Workshop88/thotcon0x4/DesignNotes.html

<h3>Links for Thotcon badges</h3>

<h4>Protocols</h4>

<ul>

<li>802.15.4 - MAC (Media Access Layer) and PHY (Physical layer) used by all RF devices (may be some others)</li>

<li>ZigBee - proprietary (consortium owned) protocol set over 802.15.4 RF. Requires ~128k memory for protocol stack. </li>

<li>6LowPan - <a href="http://www.ecnmag.com/articles/2009/02/6lowpan-goes-where-zigbee-cant">IPv6 over Low Power access network</a> - Routing, Addressing, IP protocols over 802.15.4 RF. Applications similar to Zigbee, multiple implementations. Each node gets an IP address. Less memory usage compared to Zigbee?</li>

<li><a href="http://www.contiki-os.org/">Contiki</a> - network OS built atop 6LowPan, open source. Runs on current generation chipsets. Full IDE, Cooja network simulator free. </li>

<li><a href="http://www.ti.com/tool/simpliciti">SimpliciTI</a> - simple protocol for small star networks, uses hubs for store and forward, minimal memory footprint, software available for Texas Instruments chipsets, price? <a href="http://www.ti.com/lit/ml/swru130b/swru130b.pdf">Overview</a></li>

<li>SNAP - network operating system over 802.15.4. Proprietary to <a href="http://www.synapse-wireless.com/snap-components/rf-engine">Synapse Networks</a>, programmed by Python over the air. Modules $40 each.</li>

<li><a href="http://en.m.wikipedia.org/wiki/MiWi">MiWi</a> Proprietary MicroChip protocol for PIC controllers over 802.15.4.</li>

</ul>

<h4>Chipsets</h4>

<p>TI has a variety of <a href="http://focus.ti.com/wireless/docs/wirelessproduct.tsp?familyId=2003&amp;sectionId=646&amp;tabId=2736">chipsets</a> with integrated radios that could fit the budget:</p>

<ul>

<li> <a href="http://www.ti.com/product/cc1110f32">CC1110F32</a> 8 bit processor (antique 8051 instruction set) + CC1101 900MHz RF. $2.75 1K quantity. This probably needs an additional host processor to do much. There’s a version with 6LowPan protocol preloaded <a href="http://www.ti.com/product/cc1180">CC1180</a> $3.85@1K.</li>

<li> <a href="http://www.ti.com/docs/prod/folders/print/cc430f6137.html">CC430F6137</a> - TI CC430 processor + CC1101 900MHz RF. $3 in 1K quantity. Used for variety of radio protocols. The processor is TI&#39;s 16 bit ultra low power series. &lt;1Ghz radio, use same band as wireless phone handset (900 mhz)</li>

<li><a href="http://www.ti.com/product/cc2530">CC2530</a> 8-bit 8051 + 2.4 GHz radio $3.65@1K. ZigBee stack available on 256K flash memory version</li>

<li><a href="http://www.ti.com/product/cc2544">CC2544</a> - 8-bit + 2.4GHz radio. “Value line” $1.80@1k. 32K flash memory, targeted to proprietary 2.4 GHz systems, USB dongles</li>

</ul>

<p>Freescale</p>

<ul>

<li>MC13211:2.4 GHz 802.15.4 RF and 8-bit HCS08 MCU with 16KB Flash, 1KB RAM</li>

<li> MC13224V: 2.4 GHz 802.15.4 RF and 32-bit ARM7™ MCU with 128KB Flash, 96K ram &lt;$5.</li>

<li>MPXY8300: Microcontroller, Pressure Sensor, X-Z Accelerometer and RF Transmitter- 900 MHz intended for tire pressure monitoring</li>

<li>MC12311: Sub-1 GHz RF and 8-bit HCS08 MCU with 32KB Flash, 2KB RAM</li>

<li>MC33696: PLL Tuned UHF Transceiver - 900Mhz, needs microprocessor to do anything</li>

</ul>

<p>Atmel</p>

<ul>

<li><a href="http://www.atmel.com/devices/ATMEGA256RFR2.aspx">ATMEGA256RFR2</a> brand new, AVR 8 bit processor + 2.4 GHz $6.20 DigiKey qty 1</li>

<li>AT86RF212 - 900 MHz transceiver chip, &lt; $3</li>

</ul>

<p>STMicroelectronics</p>

<ul>

<li><a href="http://www.st.com/internet/mcu/product/245381.jsp">STM32W108xx</a> ARM processor + 2.4 GHz radio, <a href="http://www.digikey.com/scripts/DkSearch/dksus.dll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">$2.75 @ 2.5K, $6.00 @ 1</a></li>

</ul>

<p>Silicon Labs</p>

<ul>

<li><a href="http://www.silabs.com/Support%20Documents/TechnicalDocs/Si1010.pdf">Si1012-A-GM</a> 8051 core + 915 MHz transceiver $5</li>

</ul>

<h4>RF modules</h4>

<p>Modules include radio chip, antenna, and support chips, sometimes with MCU. Price is the issue - first gen Zigbee seem to range from $20 to $75.</p>

<p><a href="http://www.anaren.com/air-wiki-zigbee/index.php/Main_Page">Anaren</a> - makes <a href="https://estore.ti.com/430BOOST-CC110L-CC110L-RF-Module-BoosterPack-P2734.aspx">RF Boosterpacks</a> for TI Launchpad dev units. $19 single unit</p>

<p><a href="http://www.anaren.com/sites/default/files/Part-Datasheets/A110LR09A.pdf">Anaren A110LR09A</a> - 900 MHz $15</p>

<p><a href="http://www.newark.com/microchip/mrf89xam9a-i-rm/915mhz-radio-transceiver-module/dp/76R6669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">MICROCHIP - MRF89XAM9A-I&#47;RM</a> - 915MHZ RADIO TRANSCEIVER MODULE W&#47; FCC CERTIFICATION, PCB ANTENNA AND MIWI SUPPORT $7+, SPI interface to host board, MiWi only if PIC processor used</p>

<p><a href="http://m.dhgate.com/product/FreeShipping-5pcs-lot-F20-Micro-NRF24L01+/112844608.html">No name Chinese 2.4 ghz xmit module</a> ~$6</p>

<h4>Dev kits</h4>

<p><a href="http://www.atmel.com/tools/ATMEGA256RFR2-EK.aspx">AT256RFR2-EK</a> Atmel kit includes two radios, processor, $349</p>

<p><a href="http://www.ti.com/tool/ez430-rf2500">EZ430-RF2500</a> kit from TI - two 2.4 GHz radio modules, MPS430 processor, USB board to attach radio to PC - $49</p>

<p><a href="http://www.freescale.com/webapp/sps/site/prod_summary.jsp?code=1320xRFC&amp;fpsp=1&amp;tab=desc">1320x-QE128-DSK</a> Freescale two radio kit $349</p>

<p><a href="http://www.newark.com/stmicroelectronics/stm32w-rfckit/eval-kit-stm32w-rf-control-kit/dp/39T7141">STM32W</a> two boards dev kit $38.75</p>

<h4>RF issues</h4>

<p>Design decision needed: what radio spectrum? Common choices for US are 900 MHz and 2.4 GHz. Radios available for each, most (all?) protocols work on both. Other things being equal, 915 MHz should have 2485&#47;915 ~= 2.5 times the range.</p>

<p>Noise floor - how many transmitters can we run simultaneously without blowing range, data rate?</p>

<p>How to test our implementation? Spectrum analyzer?</p>

<p>FCC certification for manufacture? We can <strong>operate</strong> in 2.4 Ghz, can we build 700 devices? We can get around any problems if we use an existing certified module.</p>

<p>Antenna detuning when used as badge - body within a centimeter would cause radio efficiency to get very poor if not tuned well. Even if tuned, radiation directional?</p>

<p><a href="http://www.ti.com/lit/an/swra169a/swra169a.pdf">Application note</a> describes range calculations and measurements for sensor radios.</p>

<p><a href="http://www.qsl.net/va3iul/Antenna/Printed_and_Microstrip_Antennas/Design_Ideas_for_Printed_and_Microstrip_Antennas.htm">Collection of real antenna designs</a></p>

<p><a href="http://www.newark.com/taiyo-yuden/ah212m245001-t/chip-antenna-2-45ghz/dp/46T5705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">Chip antenna</a> Taiyo Yuden 2.45GHz $0.73</p>

<p><a href="http://www.newark.com/abracon/abls2-13-000mhz-d4-t/crystal-13mhz-18pf-smd/dp/67P3787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">Abracon</a> 13 MHz SMD crystal $0.35
