Workshop88/thotcon0x4/tcb-prop.pdf

# THOTCON 0x4 Badge

## Design Proposal

Thursday, January 3, 2013

# Design Requirements

- Interactive element
- Battery powered
- RF transmitter / communications w/ Unique Identifiers
- Scoreboard / wall element
- Mixed color theme (Black,green,blue,red,gold)
- ~30k sq. ft. facility
- ~$12k budgeted, ~700 qty
- Early April Delivery

# Design Features

# - Multiple levels of hackability - hardware - firmware serial access - backend system - Useful after the con - Tool oriented - Explorative

# System Considerations

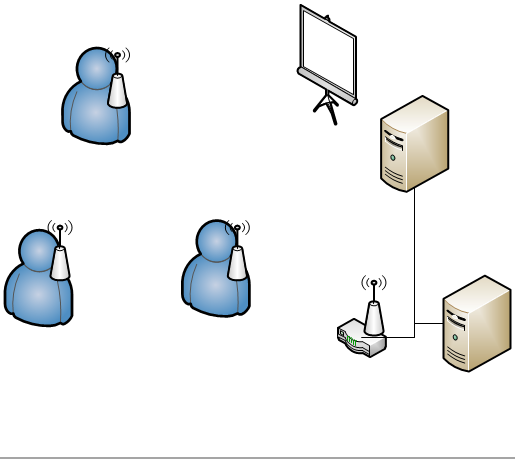
[picture p1: figure]

# Component Consideration

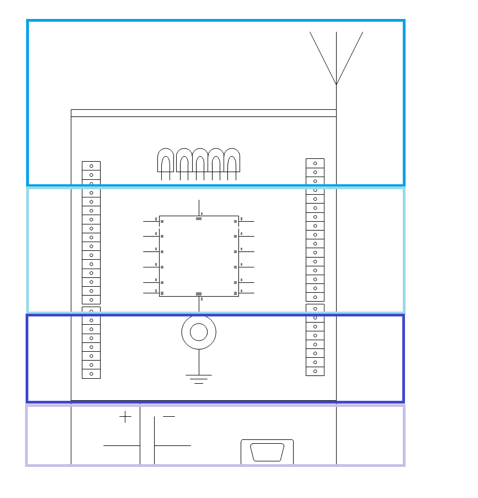
[picture p2: figure]

# - Out:RF / LED

- uC

# - In: Sensors - Power

# RF Technologies

# - High Band AM - Low Band FM

- IR

# - Proximity Radios - 802.11 - WiFi - 802.16 - WiMax - 802.15.4 - ZigBee

802.15.4

# - Cost effective Radio - Native protocols to manage base stations - CDMA , Error Control, Replay - Architecture to manage density

- Wide range of protocols (ZigBee,Xbee,

# 6LoWPAN, OpenBeacon, etc)

# Antenna Consideration

| Cost | Range | Durability | Size | Design
PCB | $10* | Variable | Highly Durable | PCB Based | Large PCB Aesthetics
Whip | $3 | Directional | Connectors Break | Obtrusive | Wireless Mystique
Chip | $0.50 | Moderate | Highly Durable | Component based

Contained
to PCB

# Network Topologies

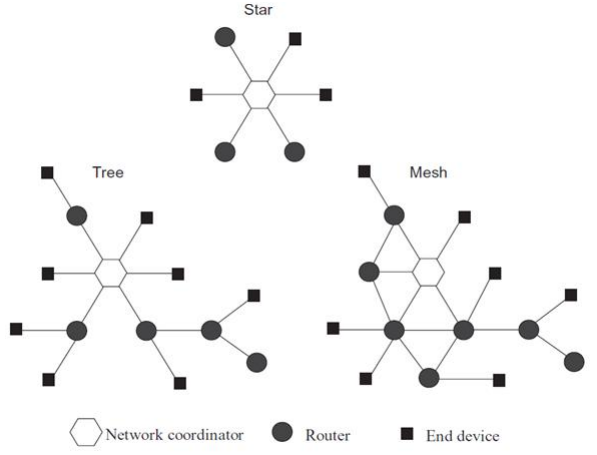
[picture p3: figure]

# Coverage Area

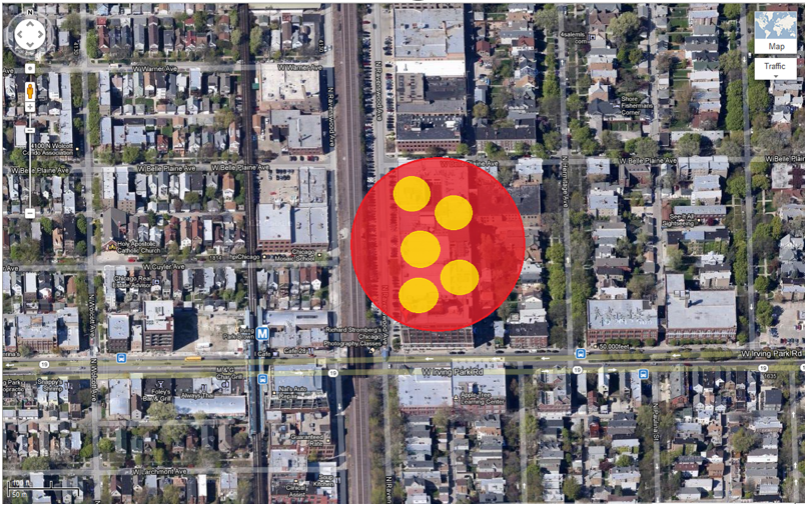
[picture p4: figure]

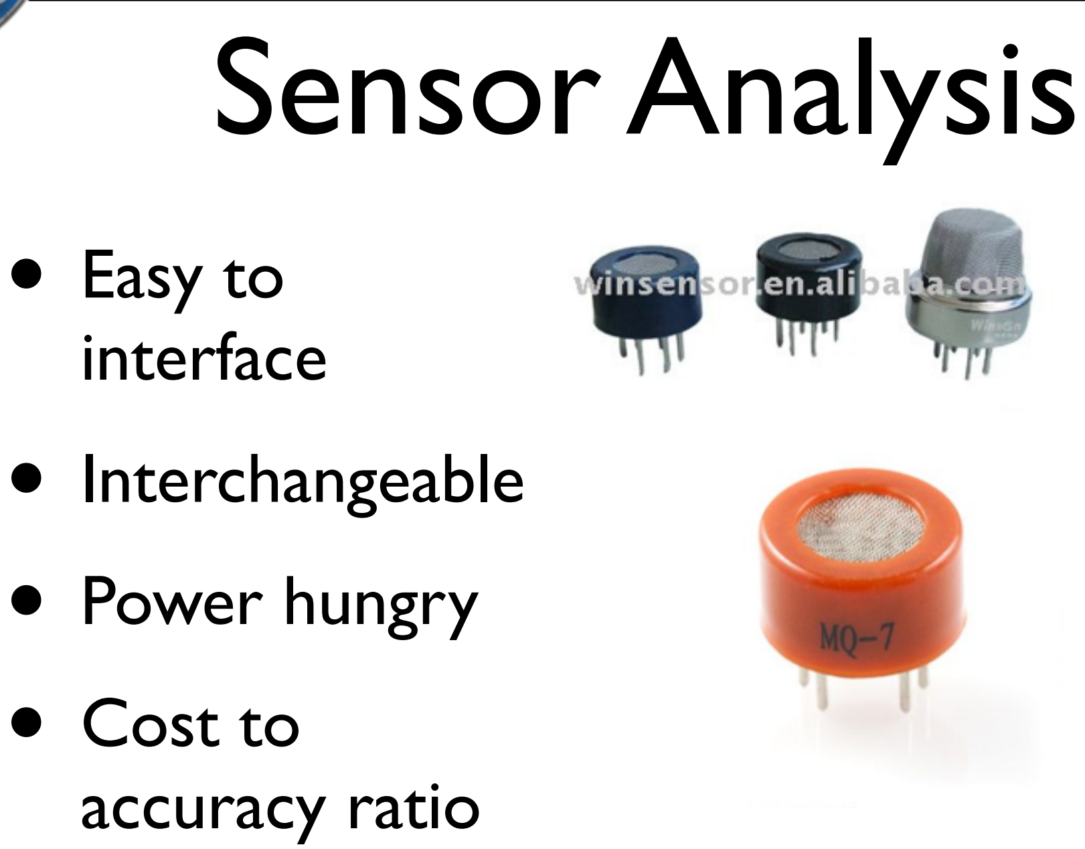
[picture p5: figure]
Sensor Analysis; • Interchangeable; • Power hungry; • Cost to accuracy ratio

# - Easy to interface

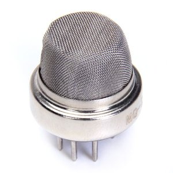
[picture p6: figure]

# Microcontroller Selection

# - Multiple A/D Inputs - Decent on chip Memory Footprint - Standard Bus Protocols

Atmel | Rabbit | TI | Freescale
Large community Several supported base languages ASM is most friendly Hobbiest Support Moderate Cost | Popular hobbyist community Difficult to program Free tools but not officially supported High Cost | Widely used commercially Not much public code base Closed Tools Low Cost | Widely used commercially Open tools, but small public code base Fewer community users Moderate Cost

# Scoreboard/Gameplay

# - QR Code Based Reg / Portal - Accessible from the THOTCON network - Top Scorerboard / Wall of Shame - Achievements

# Artistic Aspect / Theme

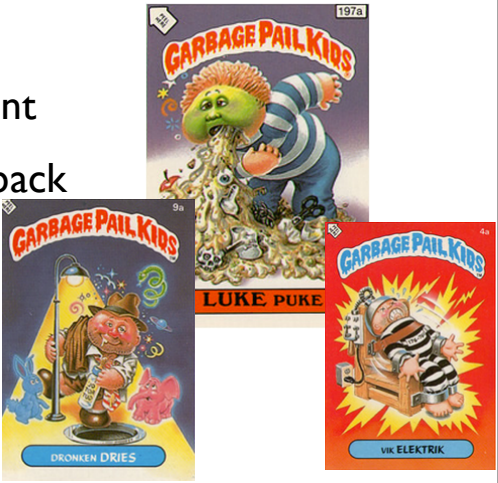
[picture p7: figure]

# - “Coaster” screen print - “Crime Dog” throwback - “Garbage Pail Kids”

# BoM Estimate

Component | Qty | Cost (@700 Units)
ATMEGA128RF | 1 | 5.28
MQ - 3 Sensor | 1 | 3.06
AT9520 Antenna | 1 | 0.56
32kHz Crystal | 1 | 0.18
16 mHz Crystal | 1 | 0.21
LED Array | 5 | 0.55
Battery | 2 | 0.25
Passive Components | 16 | 0.42
PCB Fab* | | $3 - $6
PCB Assembly* | | $6 - $10
Per Unit | -$18 - $26
Raw Cost | -$12,650 - $18,200

# Milestones

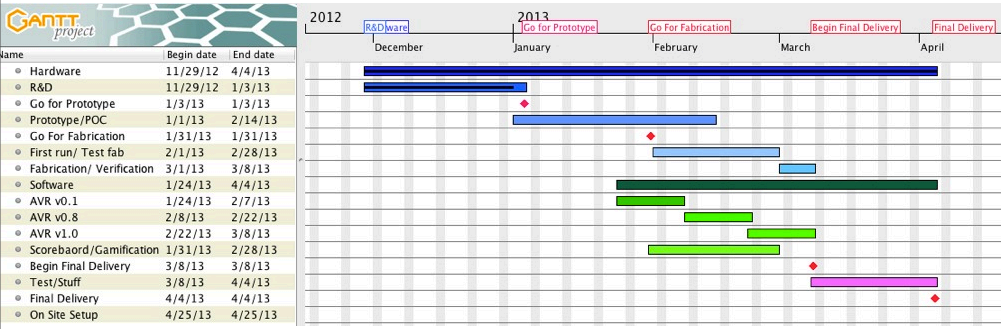
[picture p8: figure]

# - Design Review - Fab and assembly quote - Fab Verification

# Risks

# - Lot size - Lead times from Fab shops - Component availability - Budget skew

# Prior Art

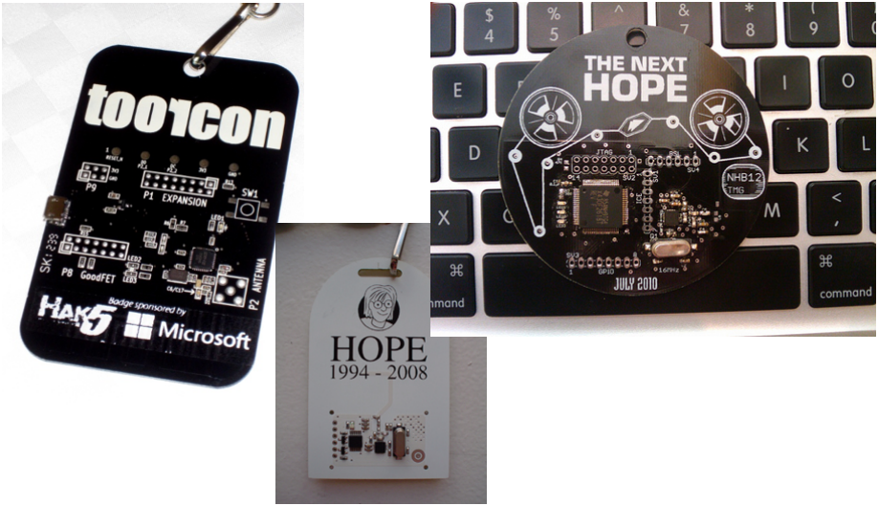
[picture p9: figure]

# Documentation / Publicity

# - “Making of the Badge” blog series - Open licensed schematics - Attribution on PCB and firmware - Github repo for documentations - All released post-con
