Workshop88/thotcon0x4/00PCB-layout/attic/01-15-13/ScreenCap-01-15-13.png

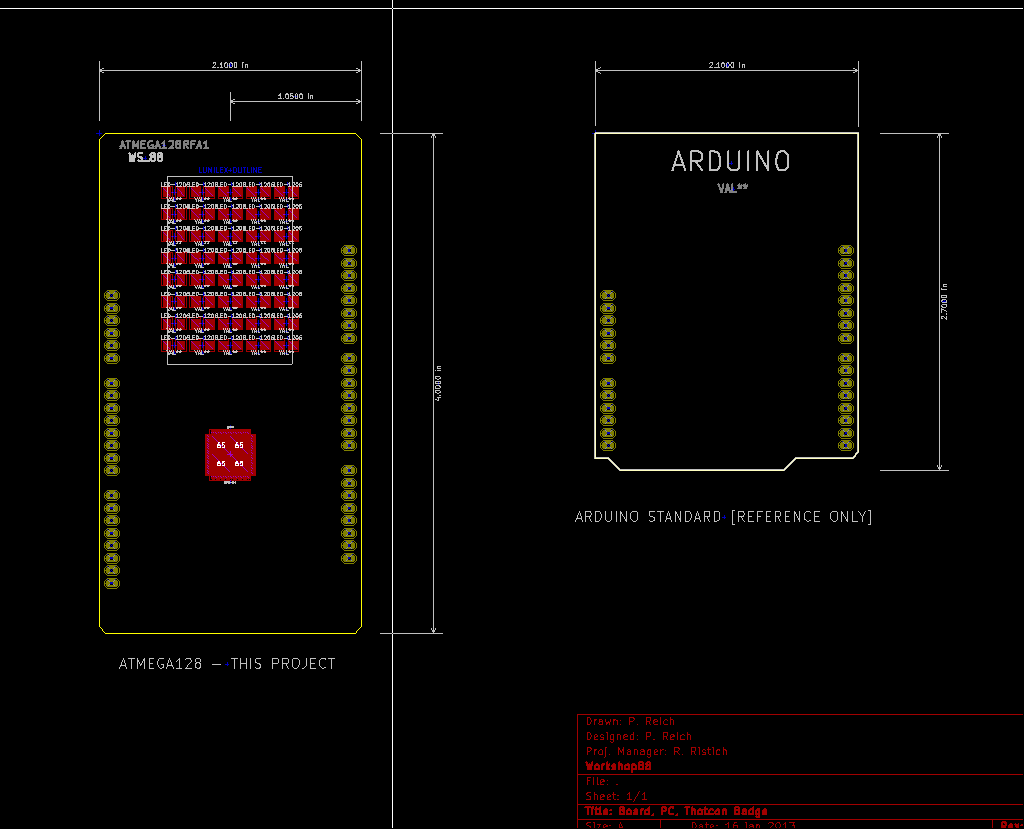
00PCB-layout/attic/01-15-13/ScreenCap-01-15-13.png
