Workshop88/thotcon0x4/00PCB-layout/attic/iss_P1/release/fab/THOTCON_0x4_oper.png

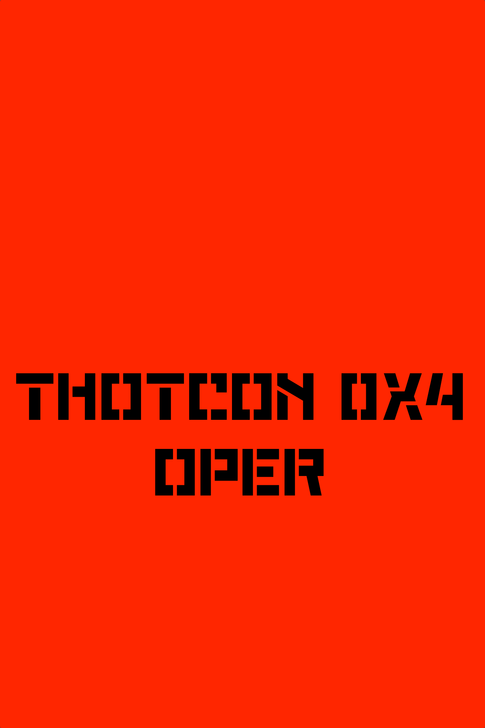
00PCB-layout/attic/iss_P1/release/fab/THOTCON_0x4_oper.png
