Workshop88/thotcon0x4/00PCB-layout/attic/iss_T2/cc_sa_3_notice.png

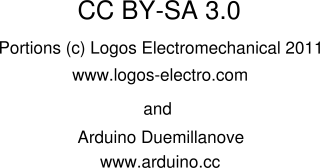
00PCB-layout/attic/iss_T2/cc_sa_3_notice.png
