Workshop88/thotcon0x4/00PCB-layout/development/iss_P3/release/thotcon_front.png

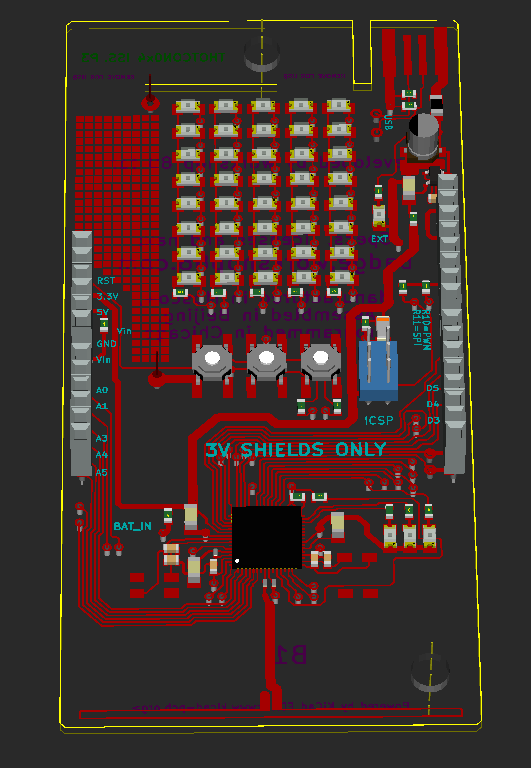
00PCB-layout/development/iss_P3/release/thotcon_front.png
