Workshop88/thotcon0x4/FUSE_TABLE/fuse-bits-2.png

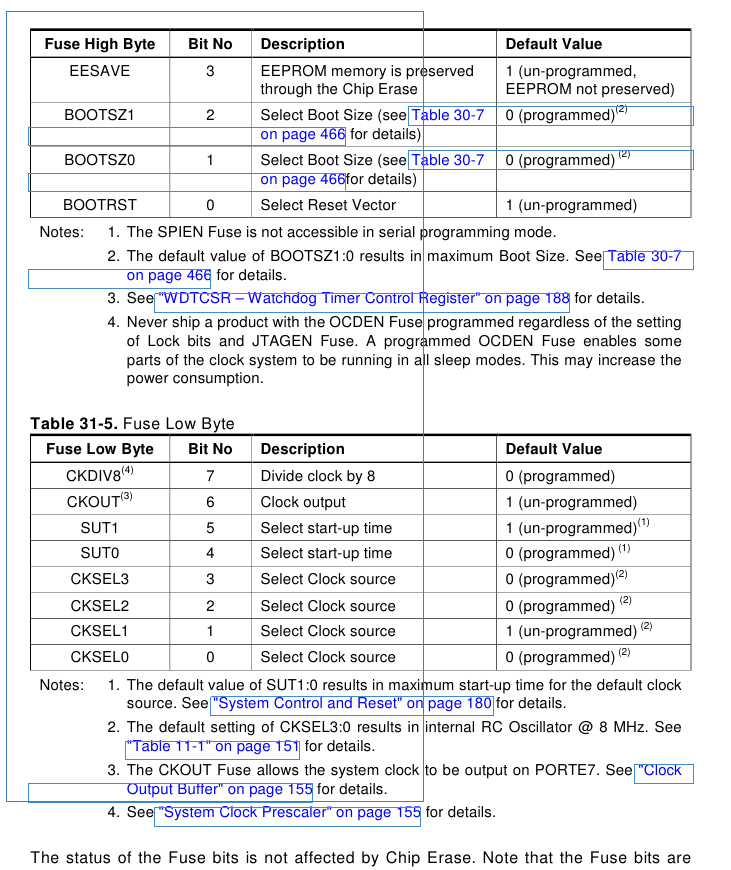
FUSE_TABLE/fuse-bits-2.png
