Workshop88/thotcon0x4/00PCB-layout/attic/iss_T2/release/thotcon_badge_zig_BOM_BY_PART.pdf

Sheet1

Page 1

REF | VALUE | DESC | PRICE/1000 | ASSY_STATUS | SUPLIER_1 | SUPPLIER_2
B1 | 3.3V | HOLDER BATT CR2032 | 0.230 | Y | Mouser 712-BAT-HLD-001
C1 | CAP CER SMD 0402 22 5 NPO | 0.040 | Y | Mouser 581-04023U220JAT2A
C2 | CAP CER SMD 0402 22 5 NPO | 0.040 | Y | Mouser 581-04023U220JAT2A
C3 | CAP CER SMD 0603 12 5 NPO | 0.010 | Y | Mouser 81-GRM39C120J50
C4 | CAP CER SMD 0603 12 5 NPO | 0.010 | Y | Mouser 81-GRM39C120J50
C5 | CAP CER SMD 0603 12 5 NPO | 0.010 | Y | Mouser 81-GRM39C120J50
C6 | CAP CER SMD 0603 12 5 NPO | 0.010 | Y | Mouser 81-GRM39C120J50
C8 | CAP CER SMD .01 10 X7R 16V | 0.015 | Y | Mouser 81-GRM18R71C103KA01D
C9 | CAP CER SMD 4.7uF 10% X7R 25V | 0.110 | Y | Mouser 81-GRM31CR71E475KA88
C10 | | CAP CER SMD 4.7uF 10% X7R 25V | 0.110 | Y | Mouser 81-GRM31CR71E475KA88
C11 | | CAR CER SMD 0402 22 5 NPO | 0.040 | Y | Mouser 581-04023U220JAT2A
C12 | | CAP LYTIC 100u 20% 6.3V | 0.210 | Y | Mouser 647-UWX0J101MCL1
D1 | RED | DIODE LED RED 1206 | 0.050 | Y | Mouser 604-APTL3216SURCK
D2 | RED | DIODE LED RED 1206 | 0.050 | Y | Mouser 604-APTL3216SURCK
D3 | RED | DIODE LED RED 1206 | 0.050 | Y | Mouser 604-APTL3216SURCK
D4 | RED | DIODE LED RED 1206 | 0.050 | Y | Mouser 604-APTL3216SURCK
D5 | RED | DIODE LED RED 1206 | 0.050 | Y | Mouser 604-APTL3216SURCK
D6 | RED | DIODE LED RED 1206 | 0.050 | Y | Mouser 604-APTL3216SURCK
D7 | RED | DIODE LED RED 1206 | 0.050 | Y | Mouser 604-APTL3216SURCK
D8 | RED | DIODE LED RED 1206 | 0.050 | Y | Mouser 604-APTL3216SURCK
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
| Digi 754-1165-1-ND
| Digi 754-1165-1-ND
| Digi CD1206-S01575CT-ND
| DigiKey P120GCT-ND
| DigiKey P120GCT-ND
| DigiKey P120GCT-ND
| DigiKey P120GCT-ND
| DigiKey P120GCT-ND
| Digikey P10KGCT-ND
| DigiKey P120GCT-ND
| Digikey P0.0GCT-ND
| Digikey P10KGCT-ND
| Digikey P0.0GCT-ND

Sheet1

Page 2

S1 | RESET | SW PB SMD N.O. | 0.250 | Y | Mouser 667-EVQQ2P02W
U1 | ATMEGA128RFA1 | IC MICROCONT RF 2450 | 5.280 | Y | Mouser 556-ATMEGA128RFA1-ZU
Y1 | 16.000 MHz | XTAL 16 MHZ | 0.500 | Y | Mouser 815-ABMM-16-B2-T
Y2 | | XTAL RTC 32768 | 0.800 | Y | Mouser 520-ECS327-12.5-17X-TR
| | TOTAL ACTIVE PART COST | 9.7322

NON-ITEMIZED PARTS
| BATTERY, CR-2032 | BATTERY, CR-2032 | 0.280 | Y
BAOARD, PC, THOTCON 0x04 | 3.000 | Y
| | TOTAL NON-ITEMIZED COST | 3.280
C13 | | CAP CER SMD 4.7u 10% X7R 25V | 0.110 | DO NOT PLACE | Mouser 81-GRM31CR71E475KA88
C14 | | CAP CER SMD .01 10 X7R 16V | 0.015 | DO NOT PLACE | Mouser 81-GRM18R71C103KA01D
C15 | | CAP LYTIC SMD 10uF 20% 16V | 0.100 | DO NOT PLACE | Mouser 647-UWF1C100MCL1GB
D41 | RED | DIODE LED RED 1206 | 0.050 | DO NOT PLACE | Mouser 604-APTL3216SURCK
D42 | RED | DIODE LED RED 1206 | 0.050 | DO NOT PLACE | Mouser 604-APTL3216SURCK
D43 | RED | DIODE LED RED 1206 | 0.050 | DO NOT PLACE | Mouser 604-APTL3216SURCK
D44 | RED | DIODE LED RED 1206 | 0.050 | DO NOT PLACE | Mouser 604-APTL3216SURCK
F1 | .5 A | FUSE POLY .5A 15V | 0.210 | DO NOT PLACE | Mouser 576-1206L050/15YR
J1 | POWER | 06-WAY SIL VERT SOCKET | 0.480 | DO NOT PLACE | Mouser 855-M20-7820646
J2 | ANALOG | 06-WAY SIL VERT SOCKET | 0.480 | DO NOT PLACE | Mouser 855-M20-7820646
J3 | DIGITAL_0 | SOCKET STRP .1 1X8 | 0.550 | DO NOT PLACE | Mouser 855-M20-7820842
J4 | DIGITAL_1 | SOCKET STRP .1 1X8 | 0.550 | DO NOT PLACE | Mouser 855-M20-7820842
P1 | USB_2_MALE | CONN USB PCB M | 0.000 | DO NOT PLACE
P2 | AVR-ISP-6A | CONN SPI AVR | 0.480 | DO NOT PLACE | Mouser 649-75869-131LF
R7 | 1K | RES CER SMD 0603 1K 5 1/10 | 0.003 | DO NOT PLACE | Mouser 667-ERJ-3GEYJ102V
R8 | 1K | RES CER SMD 0603 1K 5 1/10 | 0.003 | DO NOT PLACE | Mouser 667-ERJ-3GEYJ102V
R9 | 1K | RES CER SMD 0603 1K 5 1/10 | 0.003 | DO NOT PLACE | Mouser 667-ERJ-3GEYJ102V
R11 | 120 | RES CER SMD 0603 120 5 1/10 | 0.003 | DO NOT PLACE | Mouser 667-ERJ-3GEYJ121V
R15 | 0 | RES CER SMD 0603 0 | 0.003 | DO NOT PLACE | Mouser 667-ERJ-3GEY0R00V
R16 | 1K | RES CER SMD 0603 1K 5 1/10 | 0.003 | DO NOT PLACE | Mouser 667-ERJ-3GEYJ102V
R17 | 5V | VRSTR ESD 0603 LO-CAP | 0.090 | DO NOT PLACE | Mouser 652-CG0603MLC-05E
R18 | 5V | VRSTR ESD 0603 LO-CAP | 0.090 | DO NOT PLACE | Mouser 652-CG0603MLC-05E
R19 | 1K | RES CER SMD 0603 1K 5 1/10 | 0.003 | DO NOT PLACE | Mouser 667-ERJ-3GEYJ102V
R20 | 1K | RES CER SMD 0603 1K 5 1/10 | 0.003 | DO NOT PLACE | Mouser 667-ERJ-3GEYJ102V
R21 | 0 | RES CER SMD 0603 0 | 0.003 | DO NOT PLACE | Mouser 667-ERJ-3GEY0R00V
R22 | 120 | RES CER SMD 0603 120 5 1/10 | 0.003 | DO NOT PLACE | Mouser 667-ERJ-3GEYJ121V
R23 | 120 | RES CER SMD 0603 120 5 1/10 | 0.003 | DO NOT PLACE | Mouser 667-ERJ-3GEYJ121V
R24 | 120 | RES CER SMD 0603 120 5 1/10 | 0.003 | DO NOT PLACE | Mouser 667-ERJ-3GEYJ121V
R25 | 120 | RES CER SMD 0603 120 5 1/10 | 0.003 | DO NOT PLACE | Mouser 667-ERJ-3GEYJ121V
R26 | 120 | RES CER SMD 0603 120 5 1/10 | 0.003 | DO NOT PLACE | Mouser 667-ERJ-3GEYJ121V
R27 | 120 | RES CER SMD 0603 120 5 1/10 | 0.003 | DO NOT PLACE | Mouser 667-ERJ-3GEYJ121V
S2 | PF1 | SW PB SMD N.O. | 0.250 | DO NOT PLACE | Mouser 667-EVQQ2P02W
S3 | PF2 | SW PB SMD N.O. | 0.250 | DO NOT PLACE | Mouser 667-EVQQ2P02W
TP1 | USB_D- | TEST POINT | 0.000 | DO NOT PLACE
TP2 | USB_D+ | TEST POINT | 0.000 | DO NOT PLACE
U2 | LP2985-33 | IC REG 3.3V LDO SOT5 | 0.360 | DO NOT PLACE | Mouser 595-LP2985-33DBVR
Z1 | ANTENNA | ANTENNA PRINTED | 0.000 | DO NOT PLACE
Z2 | 100 OHM BAL | LINE TRANS 100 OHM | 0.000 | DO NOT PLACE
| | TOTAL DO NOT PLACE/UNUSED** | 4.254
| | GRAND TOTAL DEFAULT CONFIG. | 13.012
BACKWARD COMPAT CONFIG | 17.266 | **NOTE: Not all required compatibility parts have been designed in at this time.

Digikey P12943SCT-ND
Digi ATMEGA128RFA1-ZU-ND
DigiKey 535-9155-1-ND
32.768 KHz | DigiKey XC1195CT-ND
(500 pc. Estimate)
| Diigikey P189-ND
Engineer's 500 pc. Estamate.

DO NOT PLACE/UNUSED PARTS
4.7 uF | Digikey 490-1809-1-ND
.01 uF | Digikey 490-1525-1-ND
10 uF
| Digi 754-1165-1-ND
| Digi 754-1165-1-ND
| Digi 754-1165-1-ND
| Digi 754-1165-1-ND
| Digikey F3733CT-ND
| DigiKey 952-1809-ND
| DigiKey 952-1809-ND
| Digikey 952-1823-ND
| Digikey 952-1823-ND
| Digikey 609-2845-ND
| DigiKey P1.0KGCT-ND
| DigiKey P1.0KGCT-ND
| DigiKey P1.0KGCT-ND
| DigiKey P120GCT-ND
| Digikey P0.0GCT-ND
| DigiKey P1.0KGCT-ND
| Digi CG0603MLC-05ECT-ND
| Digi CG0603MLC-05ECT-ND
| DigiKey P1.0KGCT-ND
| DigiKey P1.0KGCT-ND
| Digikey P0.0GCT-ND
| DigiKey P120GCT-ND
| DigiKey P120GCT-ND
| DigiKey P120GCT-ND
| DigiKey P120GCT-ND
| DigiKey P120GCT-ND
| DigiKey P120GCT-ND
| Digikey P12943SCT-ND
| Digikey P12943SCT-ND
| Digi 296-18476-1-ND
