Workshop88/thotcon0x4/00PCB-layout/attic/iss_T2a/release/thotcon_badge_zig_BOM_BY_REF_T2a.pdf

Sheet1

Page 1

REF | VALUE | DESC | PRICE/1000 | ASSY_STATUS | SUPPLIER_1 | SUPPLIER_2
B1 | CR_2032 | HOLDER BATT CR2032 | 0.230 | Y | Mouser 712-BAT-HLD-001
C1 | | CAP CER SMD 0402 22 5 NPO | 0.04 | Y | Mouser 581-04023U220JAT2A
C2 | | CAP CER SMD 0402 22 5 NPO | 0.04 | Y | Mouser 581-04023U220JAT2A
C3 | | CAP CER SMD 0603 12 5 NPO | 0.0103 | Y | Mouser 81-GRM39C120J50
C4 | | CAP CER SMD 0603 12 5 NPO | 0.0103 | Y | Mouser 81-GRM39C120J50
C5 | | CAP CER SMD 0603 12 5 NPO | 0.0103 | Y | Mouser 81-GRM39C120J50
C6 | | CAP CER SMD 0603 12 5 NPO | 0.0103 | Y | Mouser 81-GRM39C120J50
C8 | | CAP CER SMD .01 10 X7R 16V | 0.015 | Y | Mouser 81-GRM18R71C103KA01D
C9 | | CAP CER SMD 4.7uF 10% X7R 25V | 0.11 | Y | Mouser 81-GRM31CR71E475KA88
C10 | | CAP CER SMD 4.7uF 10% X7R 25V | 0.11 | Y | Mouser 81-GRM31CR71E475KA88
C11 | | CAR CER SMD 0402 22 5 NPO | 0.04 | Y | Mouser 581-04023U220JAT2A
C12 | | CAP CER SMD 4.7uF 10% X7R 25V | 0.11 | Y | Mouser 81-GRM31CR71E475KA88
D1 | RED | DIODE LED RED 1206 | 0.05 | Y | Mouser 604-APTL3216SURCK
D2 | RED | DIODE LED RED 1206 | 0.05 | Y | Mouser 604-APTL3216SURCK
D3 | RED | DIODE LED RED 1206 | 0.05 | Y | Mouser 604-APTL3216SURCK
D4 | RED | DIODE LED RED 1206 | 0.05 | Y | Mouser 604-APTL3216SURCK
D5 | RED | DIODE LED RED 1206 | 0.05 | Y | Mouser 604-APTL3216SURCK
D6 | RED | DIODE LED RED 1206 | 0.05 | Y | Mouser 604-APTL3216SURCK
D7 | RED | DIODE LED RED 1206 | 0.05 | Y | Mouser 604-APTL3216SURCK
D8 | RED | DIODE LED RED 1206 | 0.05 | Y | Mouser 604-APTL3216SURCK
D9 | RED | DIODE LED RED 1206 | 0.05 | Y | Mouser 604-APTL3216SURCK
D10 | RED | DIODE LED RED 1206 | 0.05 | Y | Mouser 604-APTL3216SURCK
D11 | RED | DIODE LED RED 1206 | 0.05 | Y | Mouser 604-APTL3216SURCK
D12 | RED | DIODE LED RED 1206 | 0.05 | Y | Mouser 604-APTL3216SURCK
D13 | RED | DIODE LED RED 1206 | 0.05 | Y | Mouser 604-APTL3216SURCK
D14 | RED | DIODE LED RED 1206 | 0.05 | Y | Mouser 604-APTL3216SURCK
D15 | RED | DIODE LED RED 1206 | 0.05 | Y | Mouser 604-APTL3216SURCK
D16 | RED | DIODE LED RED 1206 | 0.05 | Y | Mouser 604-APTL3216SURCK
D17 | RED | DIODE LED RED 1206 | 0.05 | Y | Mouser 604-APTL3216SURCK
D18 | RED | DIODE LED RED 1206 | 0.05 | Y | Mouser 604-APTL3216SURCK
D19 | RED | DIODE LED RED 1206 | 0.05 | Y | Mouser 604-APTL3216SURCK
D20 | RED | DIODE LED RED 1206 | 0.05 | Y | Mouser 604-APTL3216SURCK
D21 | RED | DIODE LED RED 1206 | 0.05 | Y | Mouser 604-APTL3216SURCK
D22 | RED | DIODE LED RED 1206 | 0.05 | Y | Mouser 604-APTL3216SURCK
D23 | RED | DIODE LED RED 1206 | 0.05 | Y | Mouser 604-APTL3216SURCK
D24 | RED | DIODE LED RED 1206 | 0.05 | Y | Mouser 604-APTL3216SURCK
D25 | RED | DIODE LED RED 1206 | 0.05 | Y | Mouser 604-APTL3216SURCK
D26 | RED | DIODE LED RED 1206 | 0.05 | Y | Mouser 604-APTL3216SURCK
D27 | RED | DIODE LED RED 1206 | 0.05 | Y | Mouser 604-APTL3216SURCK
D28 | RED | DIODE LED RED 1206 | 0.05 | Y | Mouser 604-APTL3216SURCK
D29 | RED | DIODE LED RED 1206 | 0.05 | Y | Mouser 604-APTL3216SURCK
D30 | RED | DIODE LED RED 1206 | 0.05 | Y | Mouser 604-APTL3216SURCK
D31 | RED | DIODE LED RED 1206 | 0.05 | Y | Mouser 604-APTL3216SURCK
D32 | RED | DIODE LED RED 1206 | 0.05 | Y | Mouser 604-APTL3216SURCK
D33 | RED | DIODE LED RED 1206 | 0.05 | Y | Mouser 604-APTL3216SURCK
D34 | RED | DIODE LED RED 1206 | 0.05 | Y | Mouser 604-APTL3216SURCK
D35 | RED | DIODE LED RED 1206 | 0.05 | Y | Mouser 604-APTL3216SURCK
D36 | RED | DIODE LED RED 1206 | 0.05 | Y | Mouser 604-APTL3216SURCK
D37 | RED | DIODE LED RED 1206 | 0.05 | Y | Mouser 604-APTL3216SURCK
D38 | RED | DIODE LED RED 1206 | 0.05 | Y | Mouser 604-APTL3216SURCK
D39 | RED | DIODE LED RED 1206 | 0.05 | Y | Mouser 604-APTL3216SURCK
D40 | RED | DIODE LED RED 1206 | 0.05 | Y | Mouser 604-APTL3216SURCK
D45 | S01575 | DIODE SIG SMD 75V 1206 | 0.04 | Y | Mouser 652-CD1206-S01575
R1 | 120 | RES CER SMD 0603 120 5 1/10 | 0.0026 | Y | Mouser 667-ERJ-3GEYJ121V
R2 | 120 | RES CER SMD 0603 120 5 1/10 | 0.0026 | Y | Mouser 667-ERJ-3GEYJ121V
R3 | 120 | RES CER SMD 0603 120 5 1/10 | 0.0026 | Y | Mouser 667-ERJ-3GEYJ121V
R4 | 120 | RES CER SMD 0603 120 5 1/10 | 0.0026 | Y | Mouser 667-ERJ-3GEYJ121V
R5 | 120 | RES CER SMD 0603 120 5 1/10 | 0.0026 | Y | Mouser 667-ERJ-3GEYJ121V
R6 | 10K | RES CER SMD 0603 10K 5 1/10 | 0.0026 | Y | Mouser 667-ERJ-3GEYJ103V
R10 | 120 | RES CER SMD 0603 120 5 1/10 | 0.0026 | Y | Mouser 667-ERJ-3GEYJ121V
R12 | 0 | RES CER SMD 0603 0 | 0.0026 | Y | Mouser 667-ERJ-3GEY0R00V
R13 | 10K | RES CER SMD 0603 10K 5 1/10 | 0.0026 | Y | Mouser 667-ERJ-3GEYJ103V
R14 | 0 | RES CER SMD 0603 0 | 0.0026 | Y | Mouser 667-ERJ-3GEY0R00V
S1 | RESET | SW PB SMD N.O. | 0.25 | Y | Mouser 667-EVQQ2P02W
U1 | ATMEGA128RFA1 | IC MICROCONT RF 2450 | 5.28 | Y | Mouser 556-ATMEGA128RFA1-ZU

Digikey BAT-HLD-001-ND
22 pF
22 pF
12 pF | Digikey 490-1405-1-ND
12 pF | Digikey 490-1405-1-ND
12 pF | Digikey 490-1405-1-ND
12 pF | Digikey 490-1405-1-ND
.01 uF | Digikey 490-1525-1-ND
4.7 uF | Digikey 490-1809-1-ND
4.7 uF | Digikey 490-1809-1-ND
22 pF
4.7 uF | Digikey 490-1809-1-ND
| Digi 754-1165-1-ND
| Digi 754-1165-1-ND
| Digi 754-1165-1-ND
| Digi 754-1165-1-ND
| Digi 754-1165-1-ND
| Digi 754-1165-1-ND
| Digi 754-1165-1-ND
| Digi 754-1165-1-ND
| Digi 754-1165-1-ND
| Digi 754-1165-1-ND
| Digi 754-1165-1-ND
| Digi 754-1165-1-ND
| Digi 754-1165-1-ND
| Digi 754-1165-1-ND
| Digi 754-1165-1-ND
| Digi 754-1165-1-ND
| Digi 754-1165-1-ND
| Digi 754-1165-1-ND
| Digi 754-1165-1-ND
| Digi 754-1165-1-ND
| Digi 754-1165-1-ND
| Digi 754-1165-1-ND
| Digi 754-1165-1-ND
| Digi 754-1165-1-ND
| Digi 754-1165-1-ND
| Digi 754-1165-1-ND
| Digi 754-1165-1-ND
| Digi 754-1165-1-ND
| Digi 754-1165-1-ND
| Digi 754-1165-1-ND
| Digi 754-1165-1-ND
| Digi 754-1165-1-ND
| Digi 754-1165-1-ND
| Digi 754-1165-1-ND
| Digi 754-1165-1-ND
| Digi 754-1165-1-ND
| Digi 754-1165-1-ND
| Digi 754-1165-1-ND
| Digi 754-1165-1-ND
| Digi 754-1165-1-ND
| Digi CD1206-S01575CT-ND
| DigiKey P120GCT-ND
| DigiKey P120GCT-ND
| DigiKey P120GCT-ND
| DigiKey P120GCT-ND
| DigiKey P120GCT-ND
| Digikey P10KGCT-ND
| DigiKey P120GCT-ND
| Digikey P0.0GCT-ND
| Digikey P10KGCT-ND
| Digikey P0.0GCT-ND
| Digikey P12943SCT-ND
| Digi ATMEGA128RFA1-ZU-ND

Sheet1

Page 2

Y1 | 16.000 MHz | XTAL 16 MHZ | 0.5 | Y | Mouser 815-ABMM-16-B2-T
Y2 | | XTAL RTC 32768 | 0.8 | Y | Mouser 520-ECS327-12.5-17X-TR
| | TOTAL ACTIVE PART COST | 9.6322

NON-ITEMIZED PARTS
| BATTERY, CR-2032 | BATTERY, CR-2032 | 0.280 | Y
BOARD, PC, THOTCO Printed Circuit, each | 3.000 | Y
| | TOTAL NON-ITEMIZED COST | 3.280
C13 | | CAP CER SMD 4.7u 10% X7R 25V | 0.11 | DO NOT PLACE | Mouser 81-GRM31CR71E475KA88
C14 | | CAP CER SMD .01 10 X7R 16V | 0.015 | DO NOT PLACE | Mouser 81-GRM18R71C103KA01D
C15 | | CAP LYTIC SMD 10uF 20% 16V | 0.1 | DO NOT PLACE | Mouser 647-UWF1C100MCL1GB
D41 | | DIODE LED RED 1206 | 0.05 | DO NOT PLACE | Mouser 604-APTL3216SURCK
D42 | | DIODE LED RED 1206 | 0.05 | DO NOT PLACE | Mouser 604-APTL3216SURCK
D43 | SCK | DIODE LED RED 1206 | 0.05 | DO NOT PLACE | Mouser 604-APTL3216SURCK
D44 | | DIODE LED RED 1206 | 0.05 | DO NOT PLACE | Mouser 604-APTL3216SURCK
F1 | .5 A | FUSE POLY .5A 15V | 0.21 | DO NOT PLACE | Mouser 576-1206L050/15YR
J1 | POWER | 06-WAY SIL VERT SOCKET | 0.48 | DO NOT PLACE | Mouser 855-M20-7820646
J2 | ANALOG | 06-WAY SIL VERT SOCKET | 0.48 | DO NOT PLACE | Mouser 855-M20-7820646
J3 | DIGITAL_0 | SOCKET STRP .1 1X8 | 0.55 | DO NOT PLACE | Mouser 855-M20-7820842
J4 | DIGITAL_1 | SOCKET STRP .1 1X8 | 0.55 | DO NOT PLACE | Mouser 855-M20-7820842
P1 | USB_2_MALE | CONN USB PCB M | 0 | DO NOT PLACE
P2 | AVR-ISP-6A | CONN SPI AVR | 0.48 | DO NOT PLACE | Mouser 649-75869-131LF
R7 | 1K | RES CER SMD 0603 1K 5 1/10 | 0.0026 | DO NOT PLACE | Mouser 667-ERJ-3GEYJ102V
R8 | 1K | RES CER SMD 0603 1K 5 1/10 | 0.0026 | DO NOT PLACE | Mouser 667-ERJ-3GEYJ102V
R9 | 1K | RES CER SMD 0603 1K 5 1/10 | 0.0026 | DO NOT PLACE | Mouser 667-ERJ-3GEYJ102V
R11 | 120 | RES CER SMD 0603 120 5 1/10 | 0.0026 | DO NOT PLACE | Mouser 667-ERJ-3GEYJ121V
R15 | 0 | RES CER SMD 0603 0 | 0.0026 | DO NOT PLACE | Mouser 667-ERJ-3GEY0R00V
R16 | 1K | RES CER SMD 0603 1K 5 1/10 | 0.0026 | DO NOT PLACE | Mouser 667-ERJ-3GEYJ102V
R17 | 5V | VRSTR ESD 0603 LO-CAP | 0.09 | DO NOT PLACE | Mouser 652-CG0603MLC-05E
R18 | 5V | VRSTR ESD 0603 LO-CAP | 0.09 | DO NOT PLACE | Mouser 652-CG0603MLC-05E
R19 | 1K | RES CER SMD 0603 1K 5 1/10 | 0.0026 | DO NOT PLACE | Mouser 667-ERJ-3GEYJ102V
R20 | 1K | RES CER SMD 0603 1K 5 1/10 | 0.0026 | DO NOT PLACE | Mouser 667-ERJ-3GEYJ102V
R21 | 0 | RES CER SMD 0603 0 | 0.0026 | DO NOT PLACE | Mouser 667-ERJ-3GEY0R00V
S2 | PF1 | SW PB SMD N.O. | 0.25 | DO NOT PLACE | Mouser 667-EVQQ2P02W
S3 | PF2 | SW PB SMD N.O. | 0.25 | DO NOT PLACE | Mouser 667-EVQQ2P02W
TP1 | USB_D- | TEST POINT | 0 | DO NOT PLACE
TP2 | USB_D+ | TEST POINT | 0 | DO NOT PLACE
TP3 | SER_RXD | TEST POINT | 0 | DO NOT PLACE
TP4 | SER_TXD | TEST POINT | 0 | DO NOT PLACE
U2 | LP2985-33 | IC REG 3.3V LDO SOT5 | 0.36 | DO NOT PLACE | Mouser 595-LP2985-33DBVR
Z3 | ANTENNA | DIPOLE_FOLDED | 0 | DO NOT PLACE
| | TOTAL DO NOT PLACE/UNUSED** | 4.238
| | GRAND TOTAL DEFAULT CONFIG. | 12.912
| | BACKWARD COMPAT CONFIG | 17.151

DigiKey 535-9155-1-ND
32.768 KHz | DigiKey XC1195CT-ND
(500 pc. Estimate)

Diigikey P189-ND
Engineer's 500 pc. Estimate.

DO NOT PLACE/UNUSED PARTS
4.7 uF | Digikey 490-1809-1-ND
.01 uF | Digikey 490-1525-1-ND
10 uF
RxD | Digi 754-1165-1-ND
TxD | Digi 754-1165-1-ND
| Digi 754-1165-1-ND
ExT_PwR | Digi 754-1165-1-ND
| Digikey F3733CT-ND
| DigiKey 952-1809-ND
| DigiKey 952-1809-ND
| Digikey 952-1823-ND
| Digikey 952-1823-ND
| Digikey 609-2845-ND
| DigiKey P1.0KGCT-ND
| DigiKey P1.0KGCT-ND
| DigiKey P1.0KGCT-ND
| DigiKey P120GCT-ND
| Digikey P0.0GCT-ND
| DigiKey P1.0KGCT-ND
| Digi CG0603MLC-05ECT-ND
| Digi CG0603MLC-05ECT-ND
| DigiKey P1.0KGCT-ND
| DigiKey P1.0KGCT-ND
| Digikey P0.0GCT-ND
| Digikey P12943SCT-ND
| Digikey P12943SCT-ND

Digi 296-18476-1-ND

**NOTE: Arduino compatibility features are incomplete at this time.
