Workshop88/thotcon0x4/00PCB-layout/attic/iss_P1/release/fab/thotcon_badge_zig_BOM-BY-REF_P1_PRODN.pdf

BOM-BY-REF

Page 1

REF | VALUE | DESC | ASSY_STATUS | SUPPLIER_1 | SUPPLIER_2
B1 | CR_2032 | HOLDER BATT CR2032 | Y | Mouser 712-BAT-HLD-001
C1 | | CAP CER SMD 0402 22 5 NPO | Y | Mouser 581-04023U220JAT2A
C2 | | CAP CER SMD 0402 22 5 NPO | Y | Mouser 581-04023U220JAT2A
C3 | | CAP CER SMD 0603 12 5 NPO | Y | Mouser 81-GRM39C120J50
C4 | | CAP CER SMD 0603 12 5 NPO | Y | Mouser 81-GRM39C120J50
C5 | | CAP CER SMD 0603 12 5 NPO | Y | Mouser 81-GRM39C120J50
C6 | | CAP CER SMD 0603 12 5 NPO | Y | Mouser 81-GRM39C120J50
C8 | | CAP CER SMD .01 10 X7R 16V | Y | Mouser 81-GRM18R71C103KA01D
C9 | | CAP CER SMD 4.7uF 10% X7R 25V | Y | Mouser 81-GRM31CR71E475KA88
C10 | | CAP CER SMD 4.7uF 10% X7R 25V | Y | Mouser 81-GRM31CR71E475KA88
C11 | | CAR CER SMD 0402 22 5 NPO | Y | Mouser 581-04023U220JAT2A
C12 | | CAP CER SMD 4.7uF 10% X7R 25V | Y | Mouser 81-GRM31CR71E475KA88
D1 | RED | DIODE LED RED 1206 | Y | Mouser 604-APTL3216SURCK
D2 | RED | DIODE LED RED 1206 | Y | Mouser 604-APTL3216SURCK
D3 | RED | DIODE LED RED 1206 | Y | Mouser 604-APTL3216SURCK
D4 | RED | DIODE LED RED 1206 | Y | Mouser 604-APTL3216SURCK
D5 | RED | DIODE LED RED 1206 | Y | Mouser 604-APTL3216SURCK
D6 | RED | DIODE LED RED 1206 | Y | Mouser 604-APTL3216SURCK
D7 | RED | DIODE LED RED 1206 | Y | Mouser 604-APTL3216SURCK
D8 | RED | DIODE LED RED 1206 | Y | Mouser 604-APTL3216SURCK
D9 | RED | DIODE LED RED 1206 | Y | Mouser 604-APTL3216SURCK
D10 | RED | DIODE LED RED 1206 | Y | Mouser 604-APTL3216SURCK
D11 | RED | DIODE LED RED 1206 | Y | Mouser 604-APTL3216SURCK
D12 | RED | DIODE LED RED 1206 | Y | Mouser 604-APTL3216SURCK
D13 | RED | DIODE LED RED 1206 | Y | Mouser 604-APTL3216SURCK
D14 | RED | DIODE LED RED 1206 | Y | Mouser 604-APTL3216SURCK
D15 | RED | DIODE LED RED 1206 | Y | Mouser 604-APTL3216SURCK
D16 | RED | DIODE LED RED 1206 | Y | Mouser 604-APTL3216SURCK
D17 | RED | DIODE LED RED 1206 | Y | Mouser 604-APTL3216SURCK
D18 | RED | DIODE LED RED 1206 | Y | Mouser 604-APTL3216SURCK
D19 | RED | DIODE LED RED 1206 | Y | Mouser 604-APTL3216SURCK
D20 | RED | DIODE LED RED 1206 | Y | Mouser 604-APTL3216SURCK
D21 | RED | DIODE LED RED 1206 | Y | Mouser 604-APTL3216SURCK
D22 | RED | DIODE LED RED 1206 | Y | Mouser 604-APTL3216SURCK
D23 | RED | DIODE LED RED 1206 | Y | Mouser 604-APTL3216SURCK
D24 | RED | DIODE LED RED 1206 | Y | Mouser 604-APTL3216SURCK
D25 | RED | DIODE LED RED 1206 | Y | Mouser 604-APTL3216SURCK
D26 | RED | DIODE LED RED 1206 | Y | Mouser 604-APTL3216SURCK
D27 | RED | DIODE LED RED 1206 | Y | Mouser 604-APTL3216SURCK
D28 | RED | DIODE LED RED 1206 | Y | Mouser 604-APTL3216SURCK
D29 | RED | DIODE LED RED 1206 | Y | Mouser 604-APTL3216SURCK
D30 | RED | DIODE LED RED 1206 | Y | Mouser 604-APTL3216SURCK
D31 | RED | DIODE LED RED 1206 | Y | Mouser 604-APTL3216SURCK
D32 | RED | DIODE LED RED 1206 | Y | Mouser 604-APTL3216SURCK
D33 | RED | DIODE LED RED 1206 | Y | Mouser 604-APTL3216SURCK
D34 | RED | DIODE LED RED 1206 | Y | Mouser 604-APTL3216SURCK
D35 | RED | DIODE LED RED 1206 | Y | Mouser 604-APTL3216SURCK
D36 | RED | DIODE LED RED 1206 | Y | Mouser 604-APTL3216SURCK
D37 | RED | DIODE LED RED 1206 | Y | Mouser 604-APTL3216SURCK

Digikey BAT-HLD-001-ND
22 pF
22 pF
12 pF | Digikey 490-1405-1-ND
12 pF | Digikey 490-1405-1-ND
12 pF | Digikey 490-1405-1-ND
12 pF | Digikey 490-1405-1-ND
.01 uF | Digikey 490-1525-1-ND
4.7 uF | Digikey 490-1809-1-ND
4.7 uF | Digikey 490-1809-1-ND
22 pF
4.7 uF | Digikey 490-1809-1-ND
| Digi 754-1165-1-ND
| Digi 754-1165-1-ND
| Digi 754-1165-1-ND
| Digi 754-1165-1-ND
| Digi 754-1165-1-ND
| Digi 754-1165-1-ND
| Digi 754-1165-1-ND
| Digi 754-1165-1-ND
| Digi 754-1165-1-ND
| Digi 754-1165-1-ND
| Digi 754-1165-1-ND
| Digi 754-1165-1-ND
| Digi 754-1165-1-ND
| Digi 754-1165-1-ND
| Digi 754-1165-1-ND
| Digi 754-1165-1-ND
| Digi 754-1165-1-ND
| Digi 754-1165-1-ND
| Digi 754-1165-1-ND
| Digi 754-1165-1-ND
| Digi 754-1165-1-ND
| Digi 754-1165-1-ND
| Digi 754-1165-1-ND
| Digi 754-1165-1-ND
| Digi 754-1165-1-ND
| Digi 754-1165-1-ND
| Digi 754-1165-1-ND
| Digi 754-1165-1-ND
| Digi 754-1165-1-ND
| Digi 754-1165-1-ND
| Digi 754-1165-1-ND
| Digi 754-1165-1-ND
| Digi 754-1165-1-ND
| Digi 754-1165-1-ND
| Digi 754-1165-1-ND
| Digi 754-1165-1-ND
| Digi 754-1165-1-ND

BOM-BY-REF

Page 2

D38 | RED | DIODE LED RED 1206 | Y | Mouser 604-APTL3216SURCK
D39 | RED | DIODE LED RED 1206 | Y | Mouser 604-APTL3216SURCK
D40 | RED | DIODE LED RED 1206 | Y | Mouser 604-APTL3216SURCK
D45 | S01575 | DIODE SIG SMD 75V 1206 | Y | Mouser 652-CD1206-S01575
R1 | 120 | RES CER SMD 0603 120 5 1/10 | Y | Mouser 667-ERJ-3GEYJ121V
R2 | 120 | RES CER SMD 0603 120 5 1/10 | Y | Mouser 667-ERJ-3GEYJ121V
R3 | 120 | RES CER SMD 0603 120 5 1/10 | Y | Mouser 667-ERJ-3GEYJ121V
R4 | 120 | RES CER SMD 0603 120 5 1/10 | Y | Mouser 667-ERJ-3GEYJ121V
R5 | 120 | RES CER SMD 0603 120 5 1/10 | Y | Mouser 667-ERJ-3GEYJ121V
R6 | 10K | RES CER SMD 0603 10K 5 1/10 | Y | Mouser 667-ERJ-3GEYJ103V
R10 | 120 | RES CER SMD 0603 120 5 1/10 | Y | Mouser 667-ERJ-3GEYJ121V
R12 | 0 | RES CER SMD 0603 0 | Y | Mouser 667-ERJ-3GEY0R00V
R13 | 10K | RES CER SMD 0603 10K 5 1/10 | Y | Mouser 667-ERJ-3GEYJ103V
R14 | 0 | RES CER SMD 0603 0 | Y | Mouser 667-ERJ-3GEY0R00V
S1 | RESET | SW PB SMD N.O. | Y | Mouser 667-EVQQ2P02W
U1 | ATMEGA128RFA1 | IC MICROCONT RF 2450 | Y | Mouser 556-ATMEGA128RFA1-ZU
Y1 | 16.000 MHz | XTAL 16 MHZ | Y | Mouser 815-ABMM-16-B2-T
Y2 | | XTAL RTC 32768 | Y | Mouser 520-ECS327-12.5-17X

NON-ITEMIZED PARTS
| BATTERY, CR-2032 | BATTERY, CR-2032 | Y | Mouser 658-CR2032
| BOARD, PC, THOTCO | Printed Circuit, each | Y

DO NOT PLACE PARTS

C13 | | CAP CER SMD 4.7u 10% X7R 25V | DO NOT PLACE | DO NOT PLACE | DO NOT PLACE
C14 | | CAP CER SMD .01 10 X7R 16V | DO NOT PLACE | DO NOT PLACE | DO NOT PLACE
C15 | | CAP LYTIC SMD 10uF 20% 16V | DO NOT PLACE | DO NOT PLACE | DO NOT PLACE
D41 | | DIODE LED RED 1206 | DO NOT PLACE | DO NOT PLACE | DO NOT PLACE
D42 | | DIODE LED RED 1206 | DO NOT PLACE | DO NOT PLACE | DO NOT PLACE
D43 | SCK | DIODE LED RED 1206 | DO NOT PLACE | DO NOT PLACE | DO NOT PLACE
D44 | | DIODE LED RED 1206 | DO NOT PLACE | DO NOT PLACE | DO NOT PLACE
F1 | .5 A | FUSE POLY .5A 15V | DO NOT PLACE | DO NOT PLACE | DO NOT PLACE
J1 | POWER | 06-WAY SIL VERT SOCKET | DO NOT PLACE | DO NOT PLACE | DO NOT PLACE
J2 | ANALOG | 06-WAY SIL VERT SOCKET | DO NOT PLACE | DO NOT PLACE | DO NOT PLACE
J3 | DIGITAL_0 | SOCKET STRP .1 1X8 | DO NOT PLACE | DO NOT PLACE | DO NOT PLACE
J4 | DIGITAL_1 | SOCKET STRP .1 1X8 | DO NOT PLACE | DO NOT PLACE | DO NOT PLACE
P1 | USB_2_MALE | CONN USB PCB M | DO NOT PLACE | DO NOT PLACE | DO NOT PLACE
P2 | AVR-ISP-6A | CONN SPI AVR | DO NOT PLACE | DO NOT PLACE | DO NOT PLACE
R7 | 1K | RES CER SMD 0603 1K 5 1/10 | DO NOT PLACE | DO NOT PLACE | DO NOT PLACE
R8 | 1K | RES CER SMD 0603 1K 5 1/10 | DO NOT PLACE | DO NOT PLACE | DO NOT PLACE
R9 | 1K | RES CER SMD 0603 1K 5 1/10 | DO NOT PLACE | DO NOT PLACE | DO NOT PLACE
R11 | 120 | RES CER SMD 0603 120 5 1/10 | DO NOT PLACE | DO NOT PLACE | DO NOT PLACE
R15 | 0 | RES CER SMD 0603 0 | DO NOT PLACE | DO NOT PLACE | DO NOT PLACE
R16 | 1K | RES CER SMD 0603 1K 5 1/10 | DO NOT PLACE | DO NOT PLACE | DO NOT PLACE
R17 | 5V | VRSTR ESD 0603 LO-CAP | DO NOT PLACE | DO NOT PLACE | DO NOT PLACE
R18 | 5V | VRSTR ESD 0603 LO-CAP | DO NOT PLACE | DO NOT PLACE | DO NOT PLACE
R19 | 1K | RES CER SMD 0603 1K 5 1/10 | DO NOT PLACE | DO NOT PLACE | DO NOT PLACE
R20 | 1K | RES CER SMD 0603 1K 5 1/10 | DO NOT PLACE | DO NOT PLACE | DO NOT PLACE
R21 | 0 | RES CER SMD 0603 0 | DO NOT PLACE | DO NOT PLACE | DO NOT PLACE
S2 | PF1 | SW PB SMD N.O. | DO NOT PLACE | DO NOT PLACE | DO NOT PLACE

Digi 754-1165-1-ND
Digi 754-1165-1-ND
Digi 754-1165-1-ND
Digi CD1206-S01575CT-ND
DigiKey P120GCT-ND
DigiKey P120GCT-ND
DigiKey P120GCT-ND
DigiKey P120GCT-ND
DigiKey P120GCT-ND
Digikey P10KGCT-ND
DigiKey P120GCT-ND
Digikey P0.0GCT-ND
Digikey P10KGCT-ND
Digikey P0.0GCT-ND
Digikey P12943SCT-ND
Digi ATMEGA128RFA1-ZURCT-ND DigiKey 535-9155-1-ND
32.768 KHz | DigiKey XC1195CT-ND
| Digikey P189-ND
*Brigitflex quote / 800 pcs

4.7 uF
.01 uF
10 uF
RxD
TxD

ExT_PwR

BOM-BY-REF

Page 3

S3 | PF2 | SW PB SMD N.O. | DO NOT PLACE | DO NOT PLACE | DO NOT PLACE
TP1 | USB_D- | TEST POINT | DO NOT PLACE | P/O PCB | P/O PCB
TP2 | USB_D+ | TEST POINT | DO NOT PLACE | P/O PCB | P/O PCB
TP3 | SER_RXD | TEST POINT | DO NOT PLACE | P/O PCB | P/O PCB
TP4 | SER_TXD | TEST POINT | DO NOT PLACE | P/O PCB | P/O PCB
U2 | LP2985-33 | IC REG 3.3V LDO SOT5 | DO NOT PLACE | DO NOT PLACE | DO NOT PLACE
Z3 | ANTENNA | DIPOLE_FOLDED | DO NOT PLACE | P/O PCB | P/O PCB
