Workshop88/thotcon0x4/00PCB-layout/assembly/U1-assembly.png

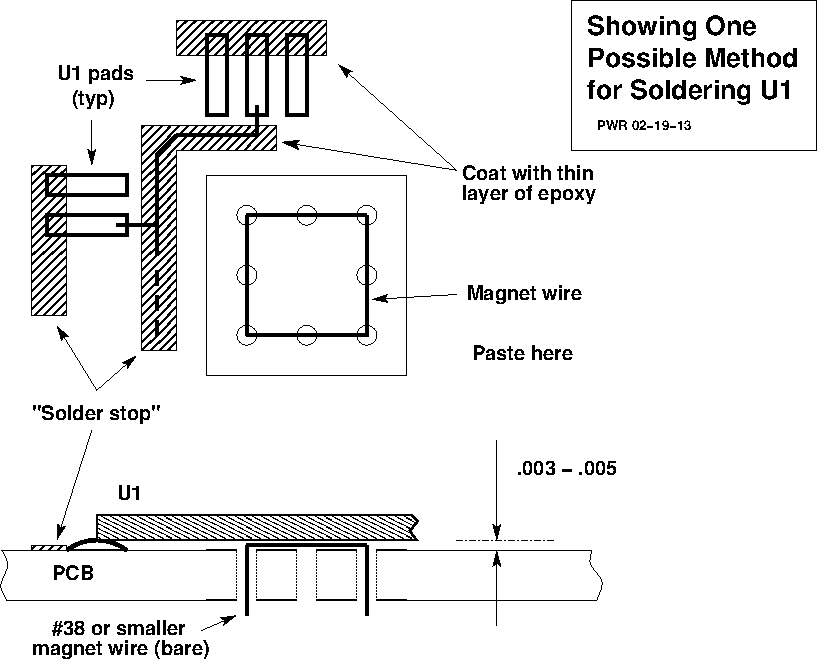
00PCB-layout/assembly/U1-assembly.png
