Workshop88/thotcon0x4/00PCB-layout/attic/iss_P1/patches/Y2_fix.png

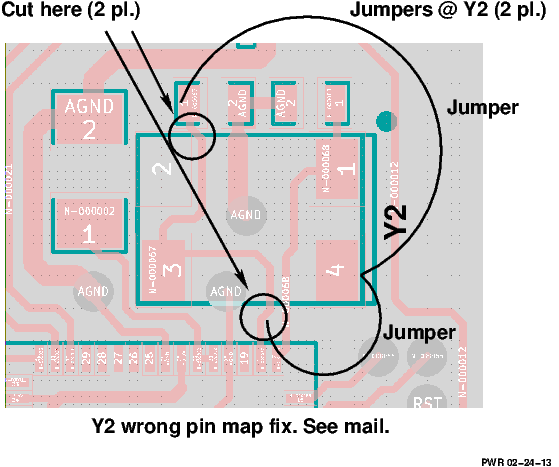
00PCB-layout/attic/iss_P1/patches/Y2_fix.png
