Workshop88/thotcon0x4/00PCB-layout/attic/iss_P2/release/thotcon_badge_zig-SCHEM.pdf

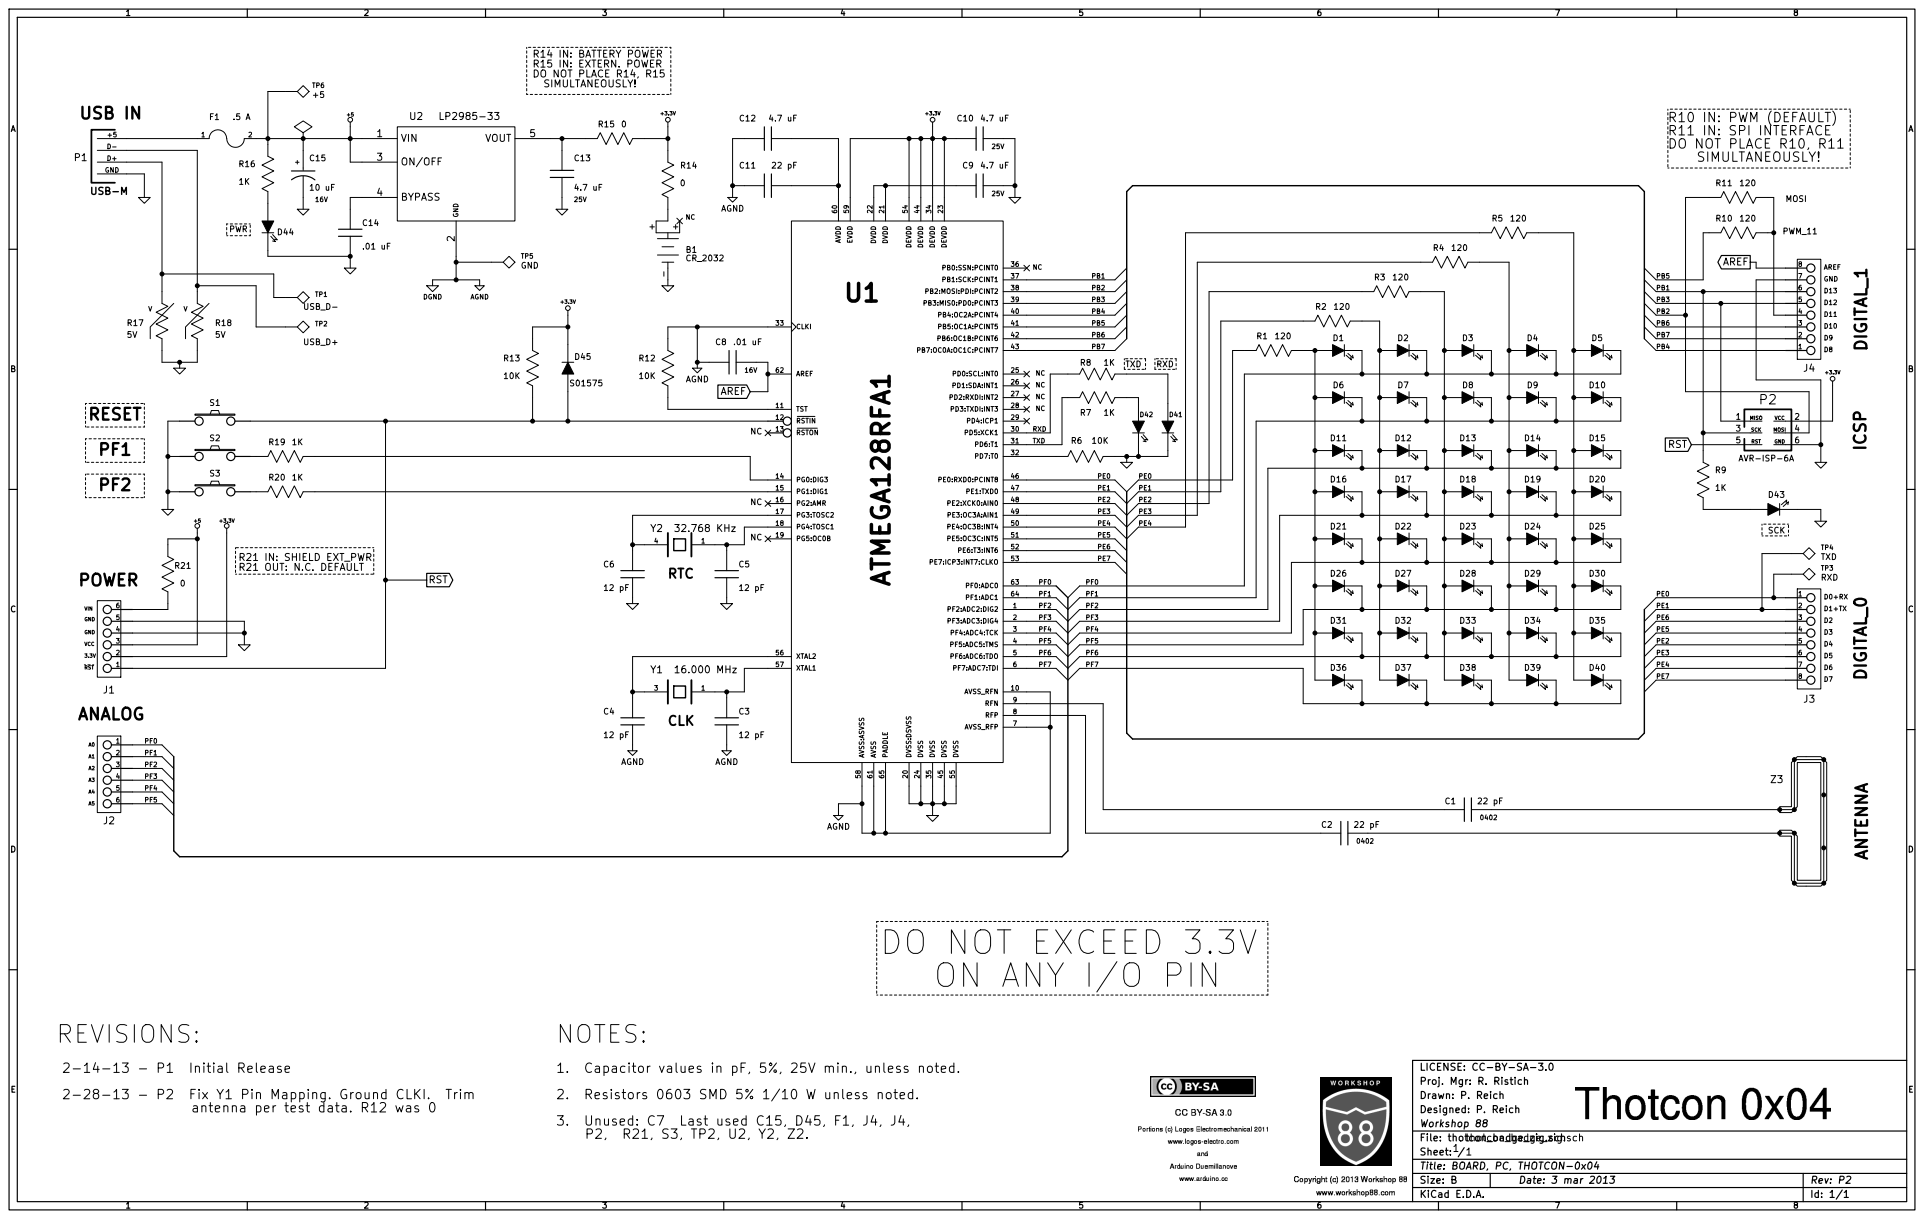
[picture p21: page 1]

2-14-13 - P1 Initial Release
2-28-13 - P2 Fix Y1 Pin Mapping. Ground CLKI. Trim

1. Capacitor values in pF, 5%, 25V min., unless noted.
2. Resistors 0603 SMD 5% 1/10 W unless noted.
3. Unused: C7 Last used C15, D45, F1, J4, J4,

LICENSE: CC-BY-SA-3.0
Designed: P. Reich Drawn: P. Reich Proj. Mgr: R. Ristich

antenna per test data. R12 was 0
