Workshop88/thotcon0x4/00PCB-layout/attic/iss_T2/release/thotcon_badge_zig-SCHEM(cut).pdf

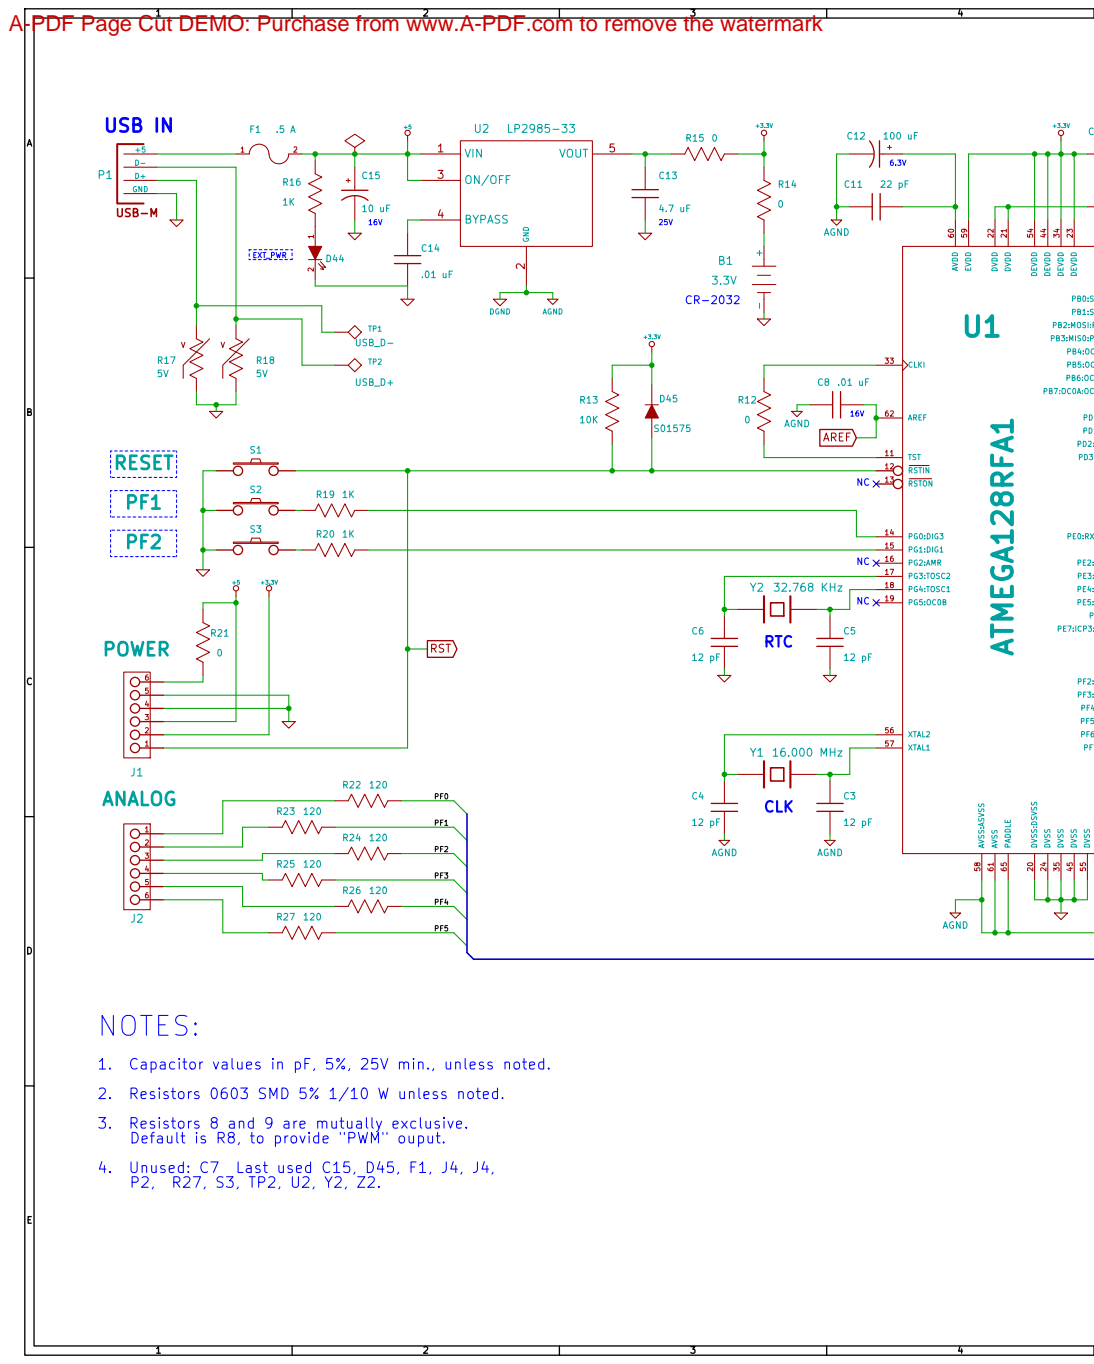
[picture p22: page 1]

A-PDF Page Cut DEMO: Purchase from www.A-PDF.com to remove the watermark (http://www.a-pdf.com/?pc-demo)

RXD_IN SCKMOSI 1. Capacitor values in pF, 5%, 25V min., unless noted.

2. Resistors 0603 SMD 5% 1/10 W unless noted.
3. Resistors 8 and 9 are mutually exclusive.
Default is R8, to provide "PWM" ouput.
4. Unused: C7 Last used C15, D45, F1, J4, J4,

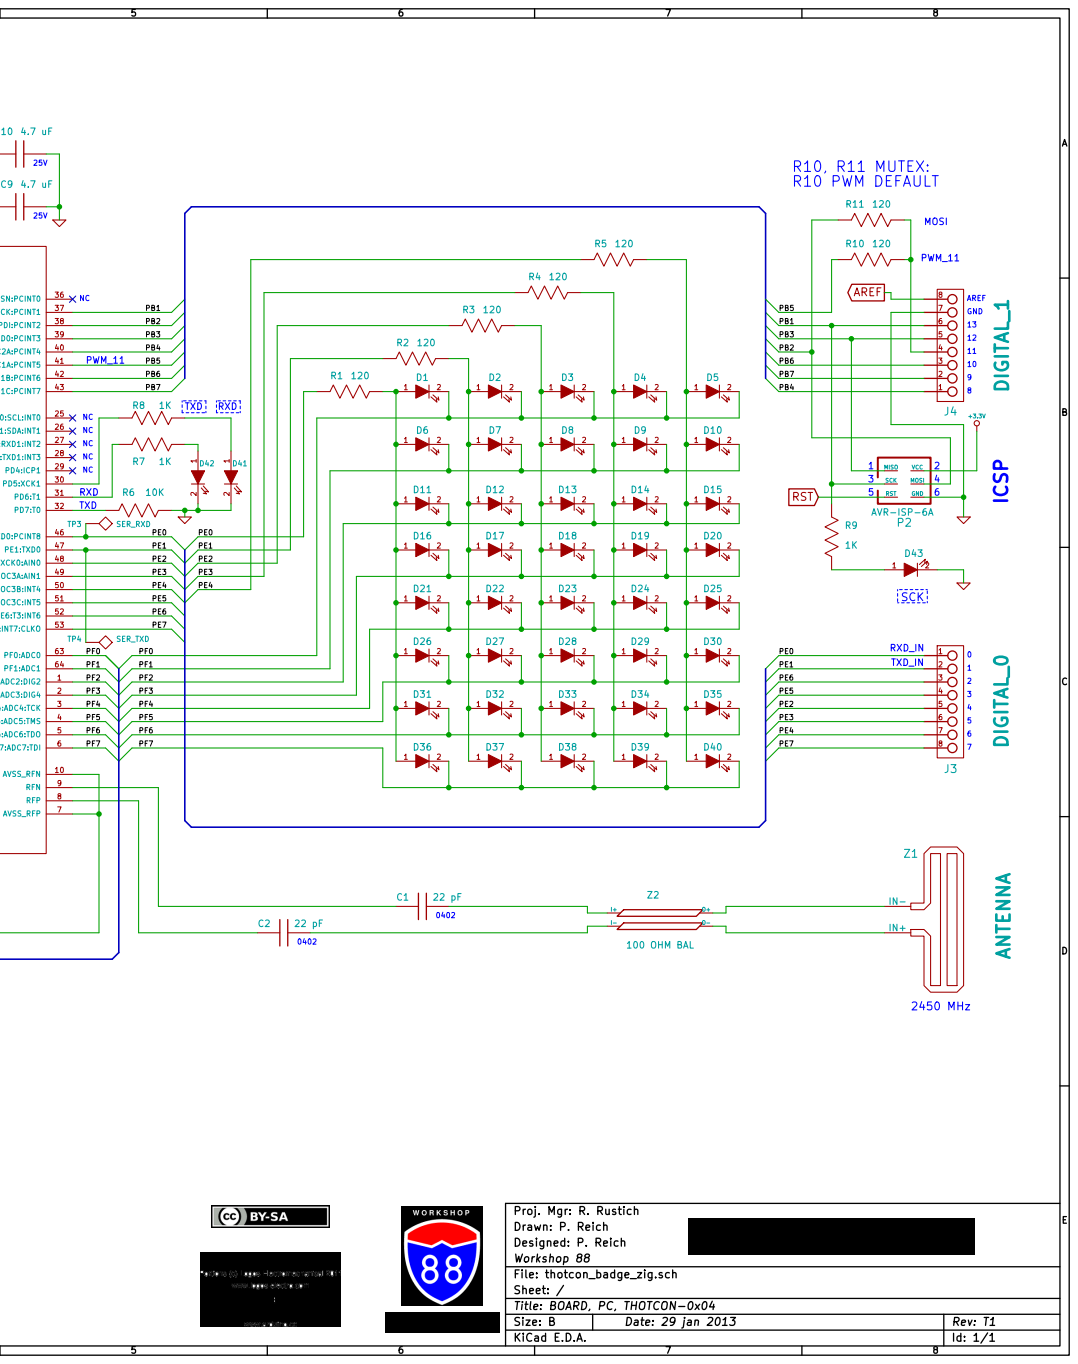
[picture p23: page 2]

RXD_IN SCKMOSI 1. Capacitor values in pF, 5%, 25V min., unless noted.

Designed: P. Reich Drawn: P. Reich Proj. Mgr: R. Rustich
