Workshop88/thotcon0x4/00PCB-layout/attic/iss_T2a/release/thotcon_badge_zig-SCHEM.pdf

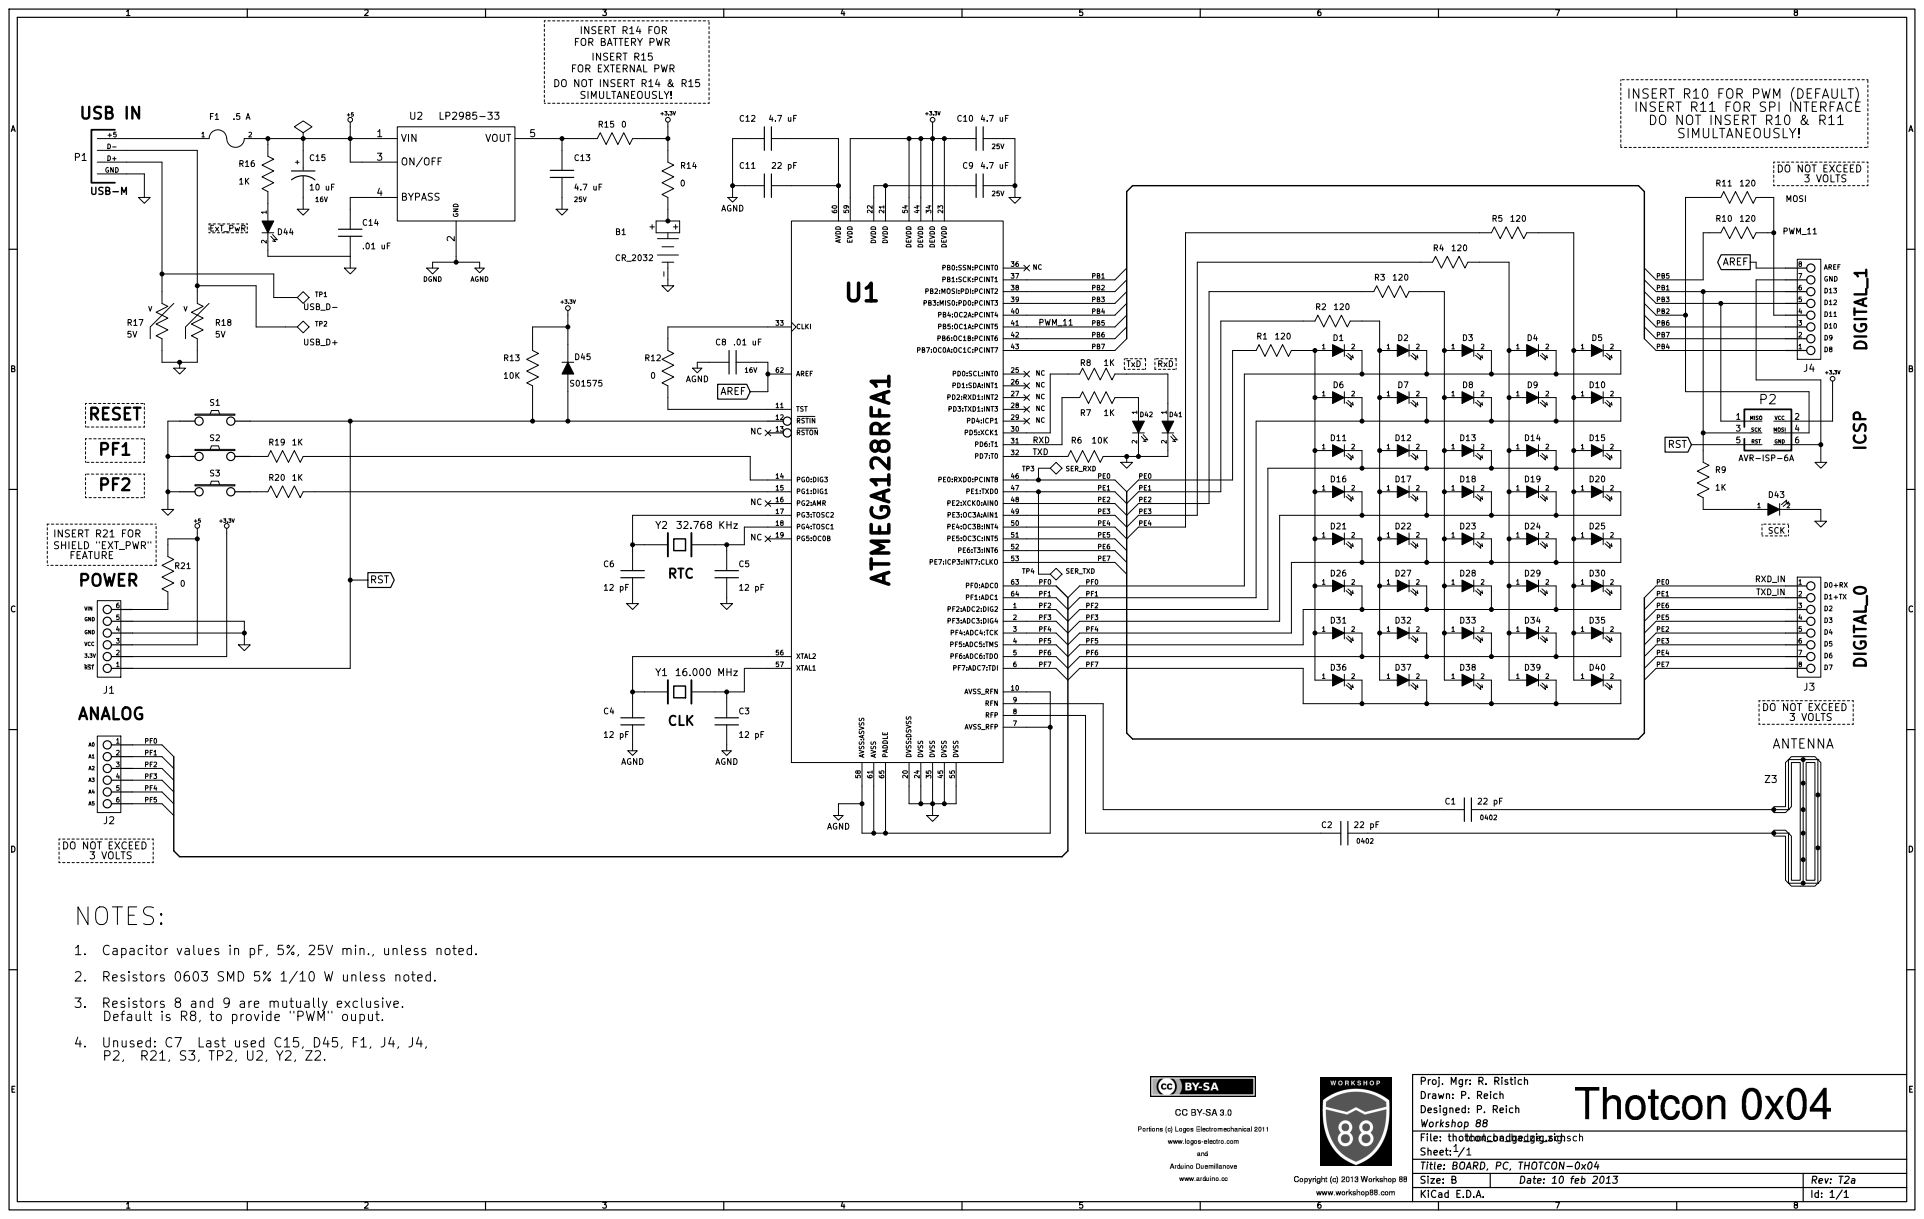
[picture p26: page 1]

PB5 INSERT R10 FOR PWM (DEFAULT)
INSERT R11 FOR SPI INTERFACE
DO NOT INSERT R10 & R11

RXD_INMOSI 1. Capacitor values in pF, 5%, 25V min., unless noted.

SHIELD "EXT_PWR"

2. Resistors 0603 SMD 5% 1/10 W unless noted.
3. Resistors 8 and 9 are mutually exclusive.
Default is R8, to provide "PWM" ouput.
4. Unused: C7 Last used C15, D45, F1, J4, J4,

Designed: P. Reich Drawn: P. Reich Proj. Mgr: R. Ristich
