Workshop88/thotcon0x4/00PCB-layout/development/iss_P3/release/thotcon_badge_zig-SCHEM.pdf

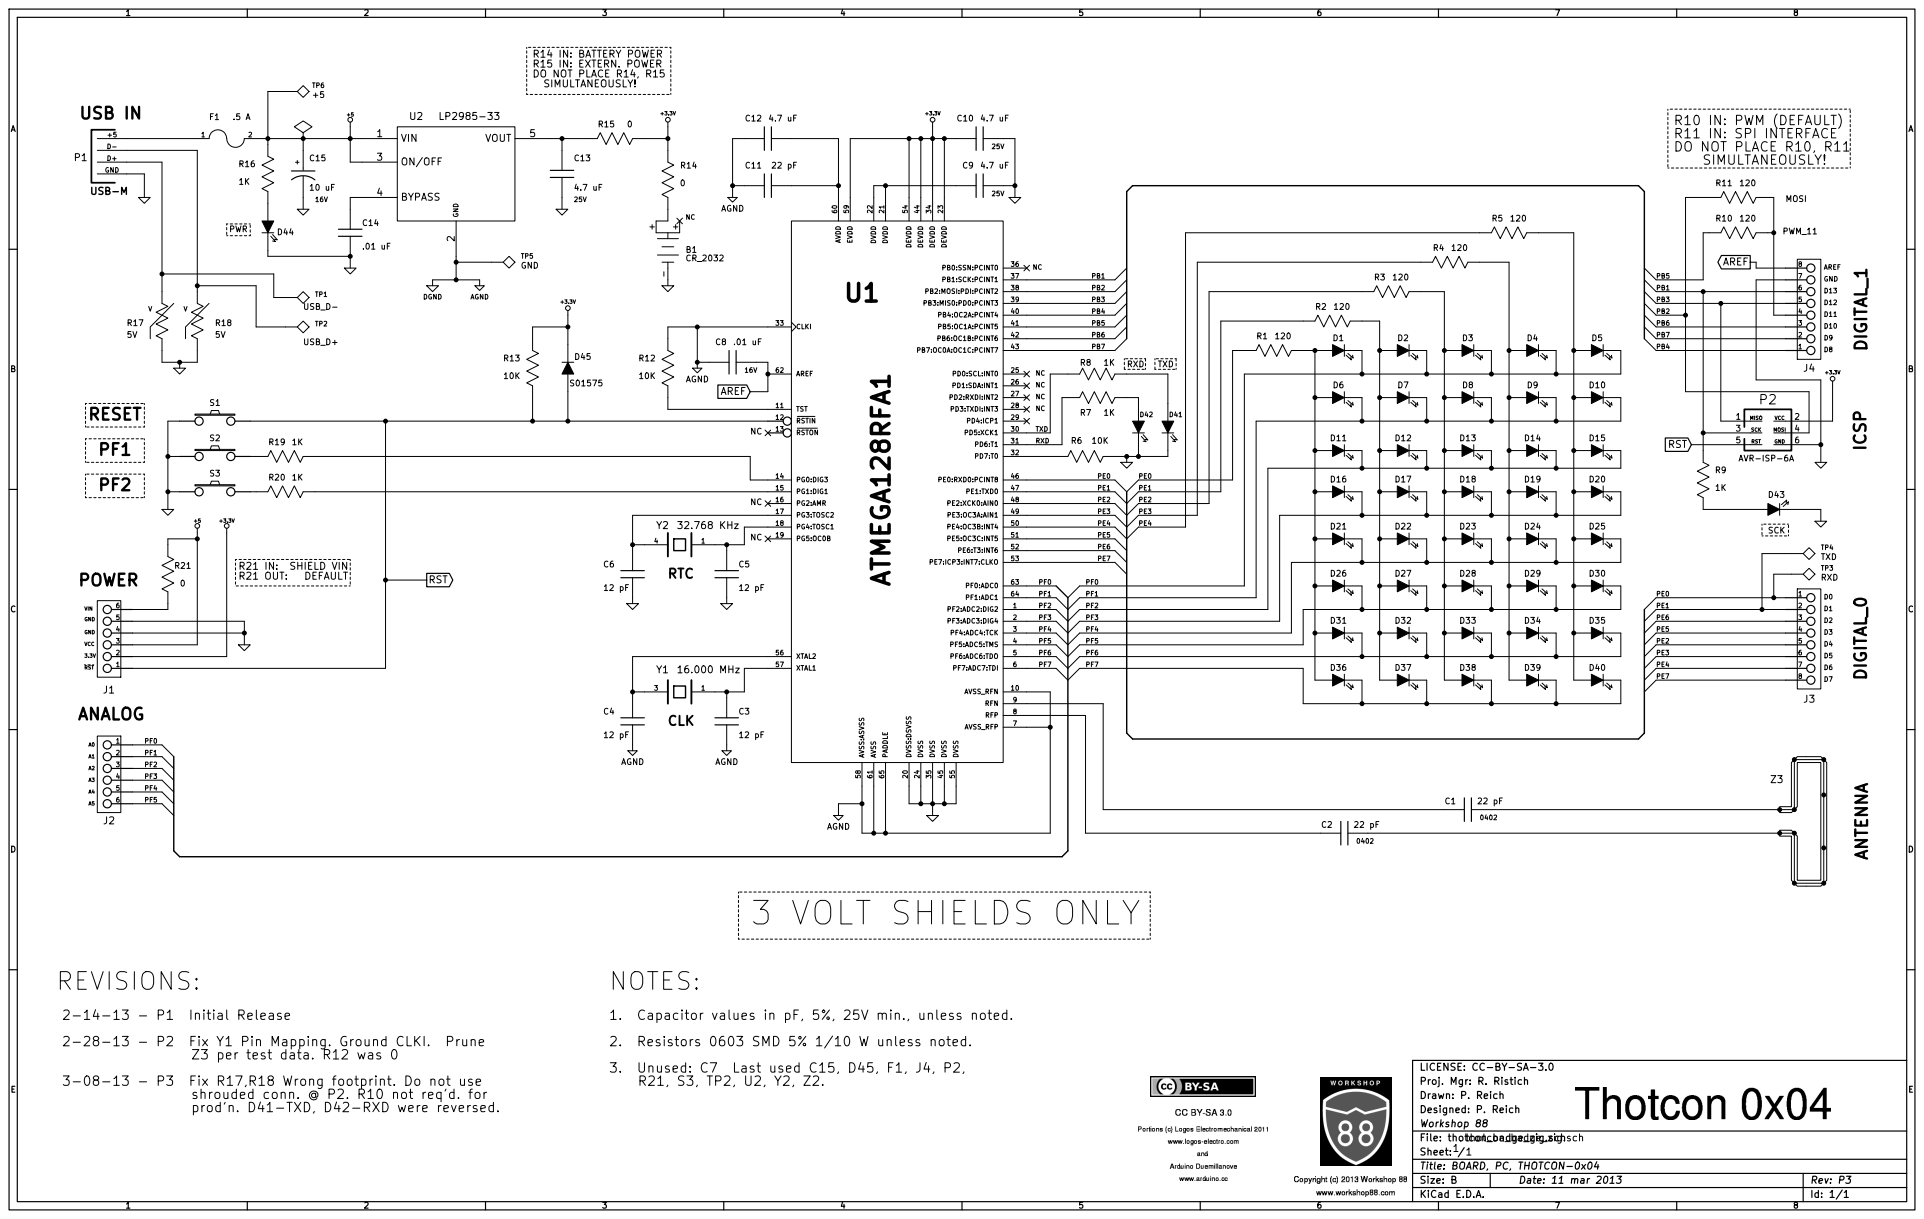
[picture p27: page 1]

2-14-13 - P1 Initial Release
2-28-13 - P2 Fix Y1 Pin Mapping. Ground CLKI. Prune

1. Capacitor values in pF, 5%, 25V min., unless noted.
2. Resistors 0603 SMD 5% 1/10 W unless noted.
3. Unused: C7 Last used C15, D45, F1, J4, P2,

Z3 per test data. R12 was 0

LICENSE: CC-BY-SA-3.0
Designed: P. Reich Drawn: P. Reich Proj. Mgr: R. Ristich

3-08-13 - P3 Fix R17,R18 Wrong footprint. Do not use

shrouded conn. @ P2. R10 not req'd. for
prod'n. D41-TXD, D42-RXD were reversed.
