Workshop88/thotcon0x4/pinoccio-schematic.pdf

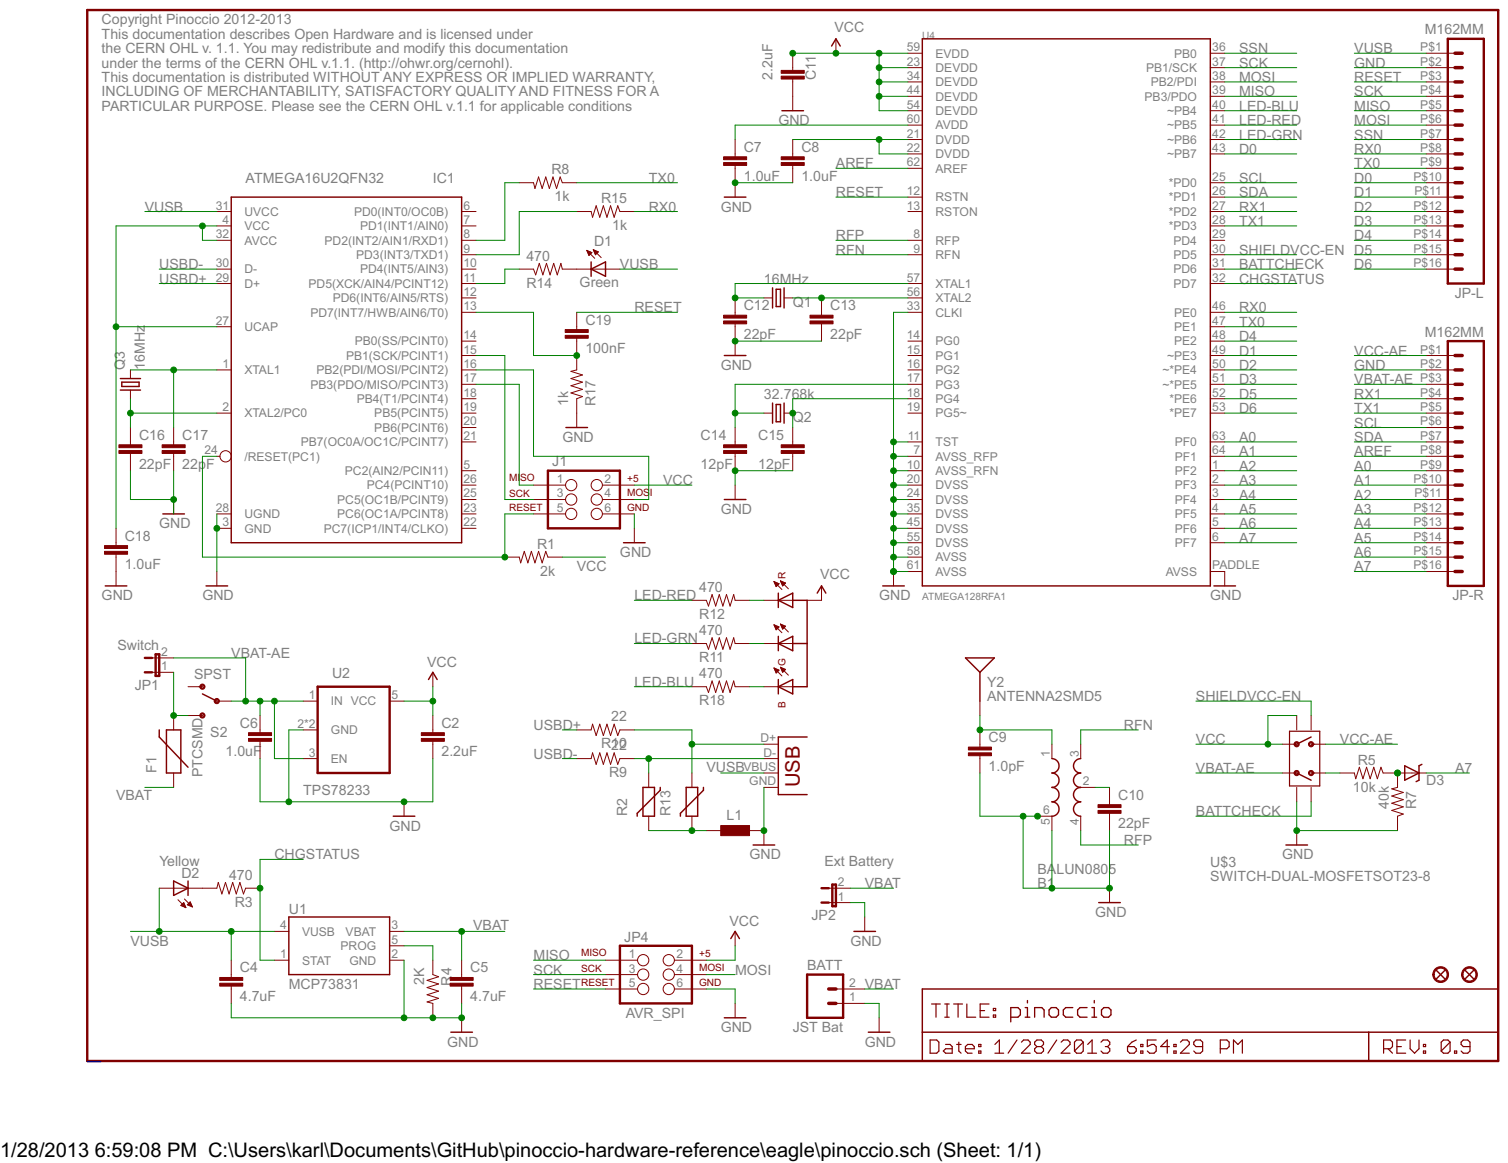
[picture p28: page 1]

Copyright Pinoccio 2012-2013
This documentation describes Open Hardware and is licensed under
the CERN OHL v. 1.1. You may redistribute and modify this documentation
under the terms of the CERN OHL v.1.1. (http://ohwr.org/cernohl). This documentation is distributed WITHOUT ANY EXPRESS OR IMPLIED WARRANTY,

INCLUDING OF MERCHANTABILITY, SATISFACTORY QUALITY AND FITNESS FOR A
PARTICULAR PURPOSE. Please see the CERN OHL v.1.1 for applicable conditions

21 | | LED-GRN

AREF | 22 | | 43 D0

32.768k | | 52 D5
Q2 | 11 | 53 D6

1/28/2013 6:59:08 PM C:\Users\karl\Documents\GitHub\pinoccio-hardware-reference\eagle\pinoccio.sch (Sheet: 1/1)
