Workshop88/thotcon0x4/00PCB-layout/attic/01-15-13/test-brd.pdf

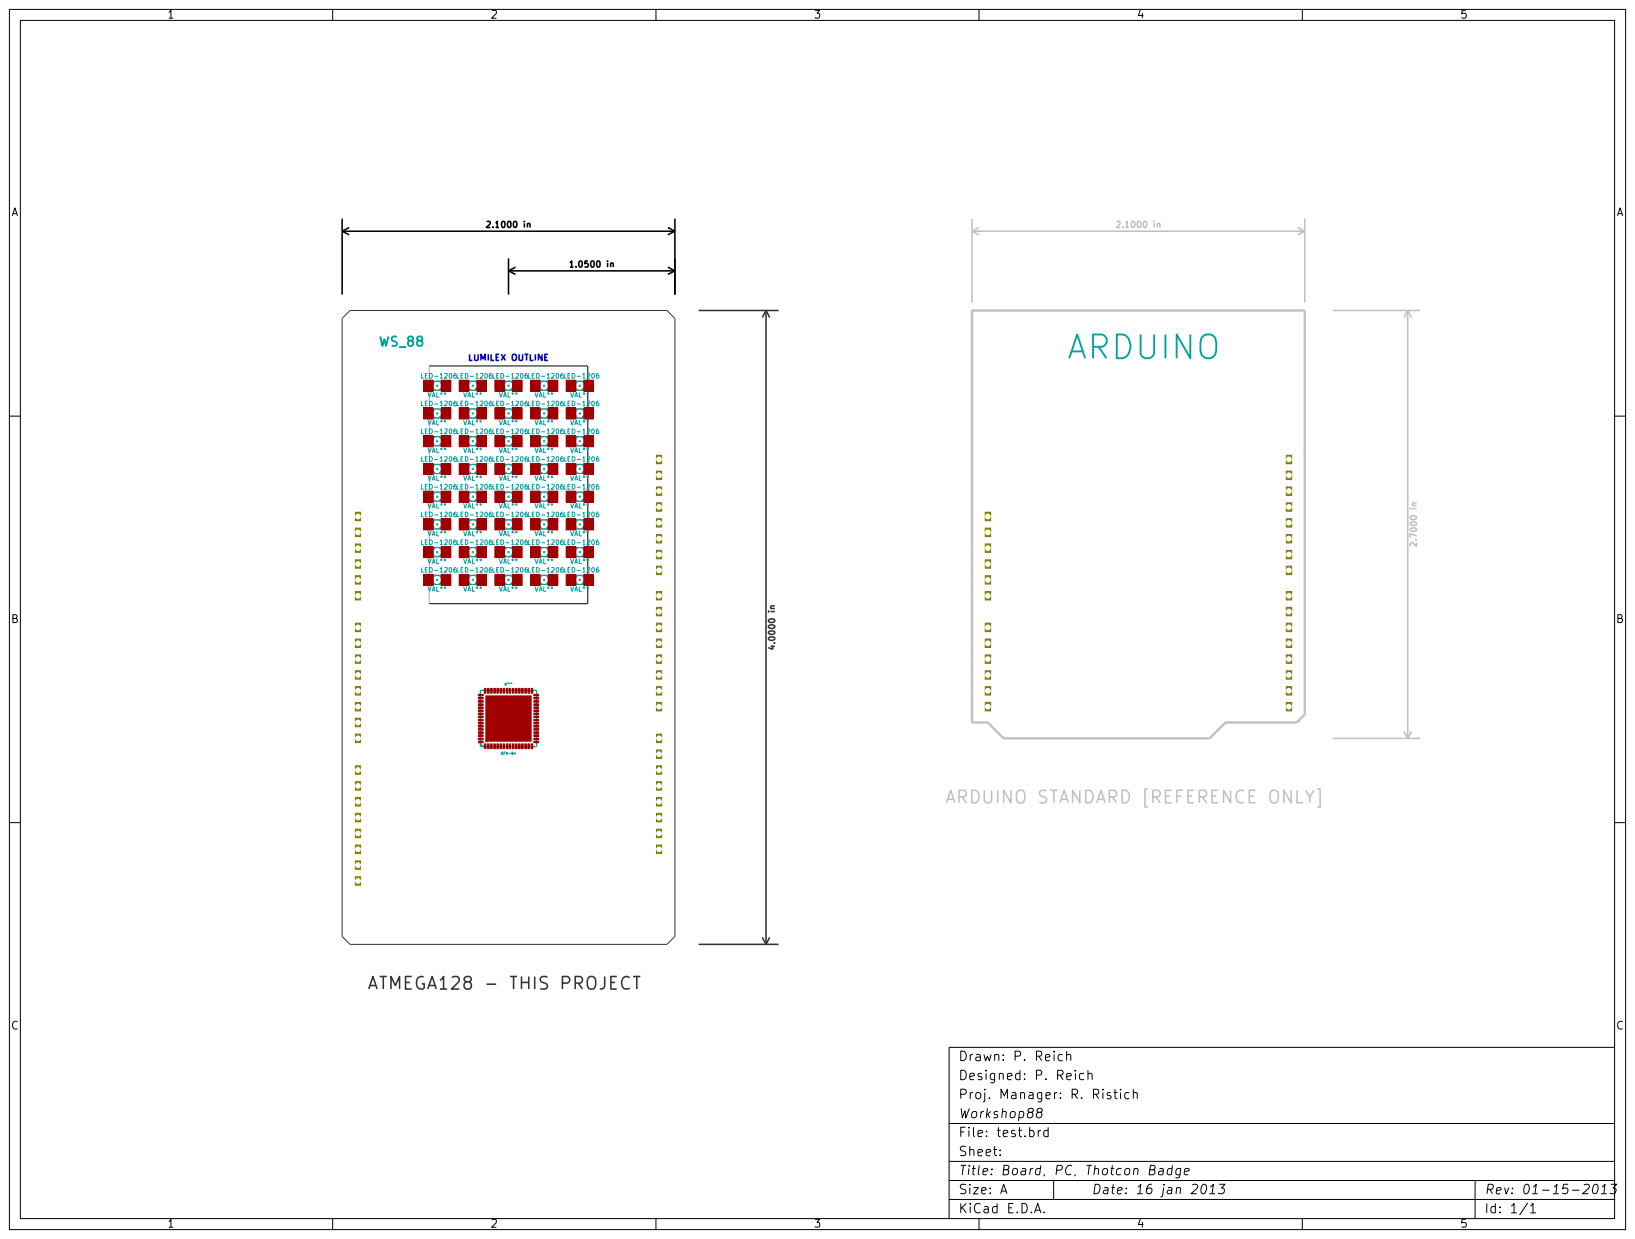
[picture p29: page 1]
