Workshop88/thotcon0x4/pinoccio-board.pdf

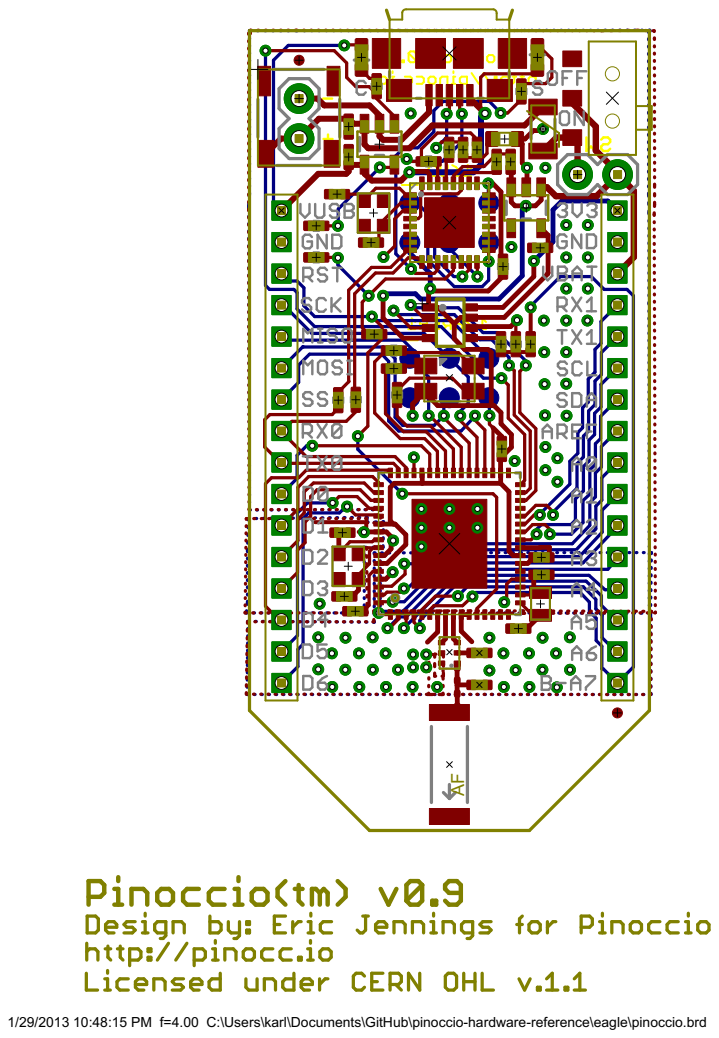
[picture p30: page 1]

1/29/2013 10:48:15 PM f=4.00 C:\Users\karl\Documents\GitHub\pinoccio-hardware-reference\eagle\pinoccio.brd
