Workshop88/thotcon0x4/00PCB-layout/attic/iss_P1/release/thotcon_badge_zig-B_copper.pdf

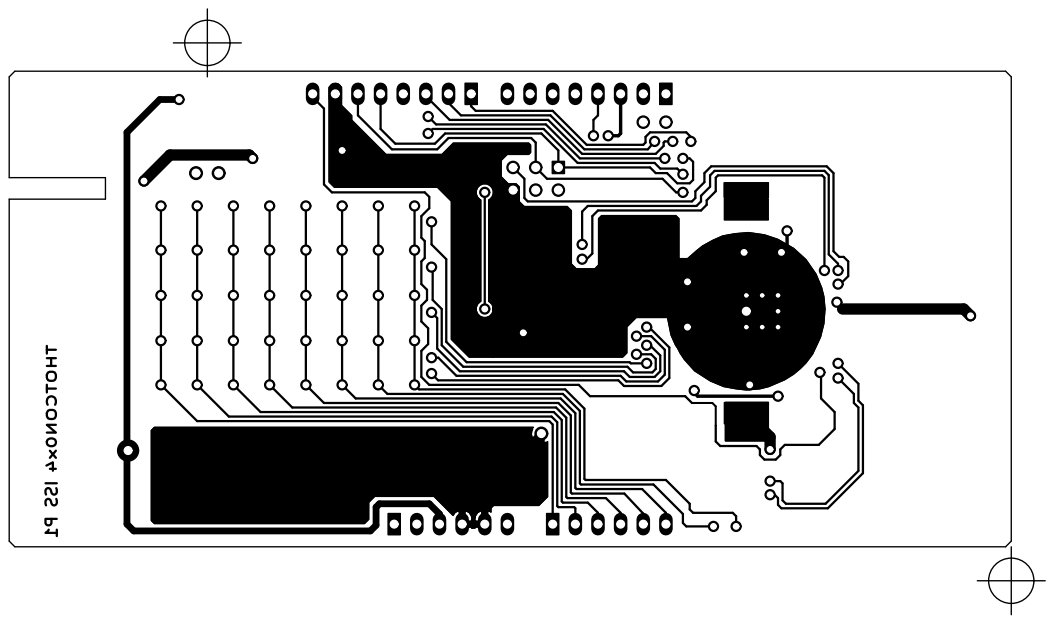
[picture p31: page 1]
