Workshop88/thotcon0x4/00PCB-layout/attic/iss_P1/release/thotcon_badge_zig-Dwgs_User.pdf

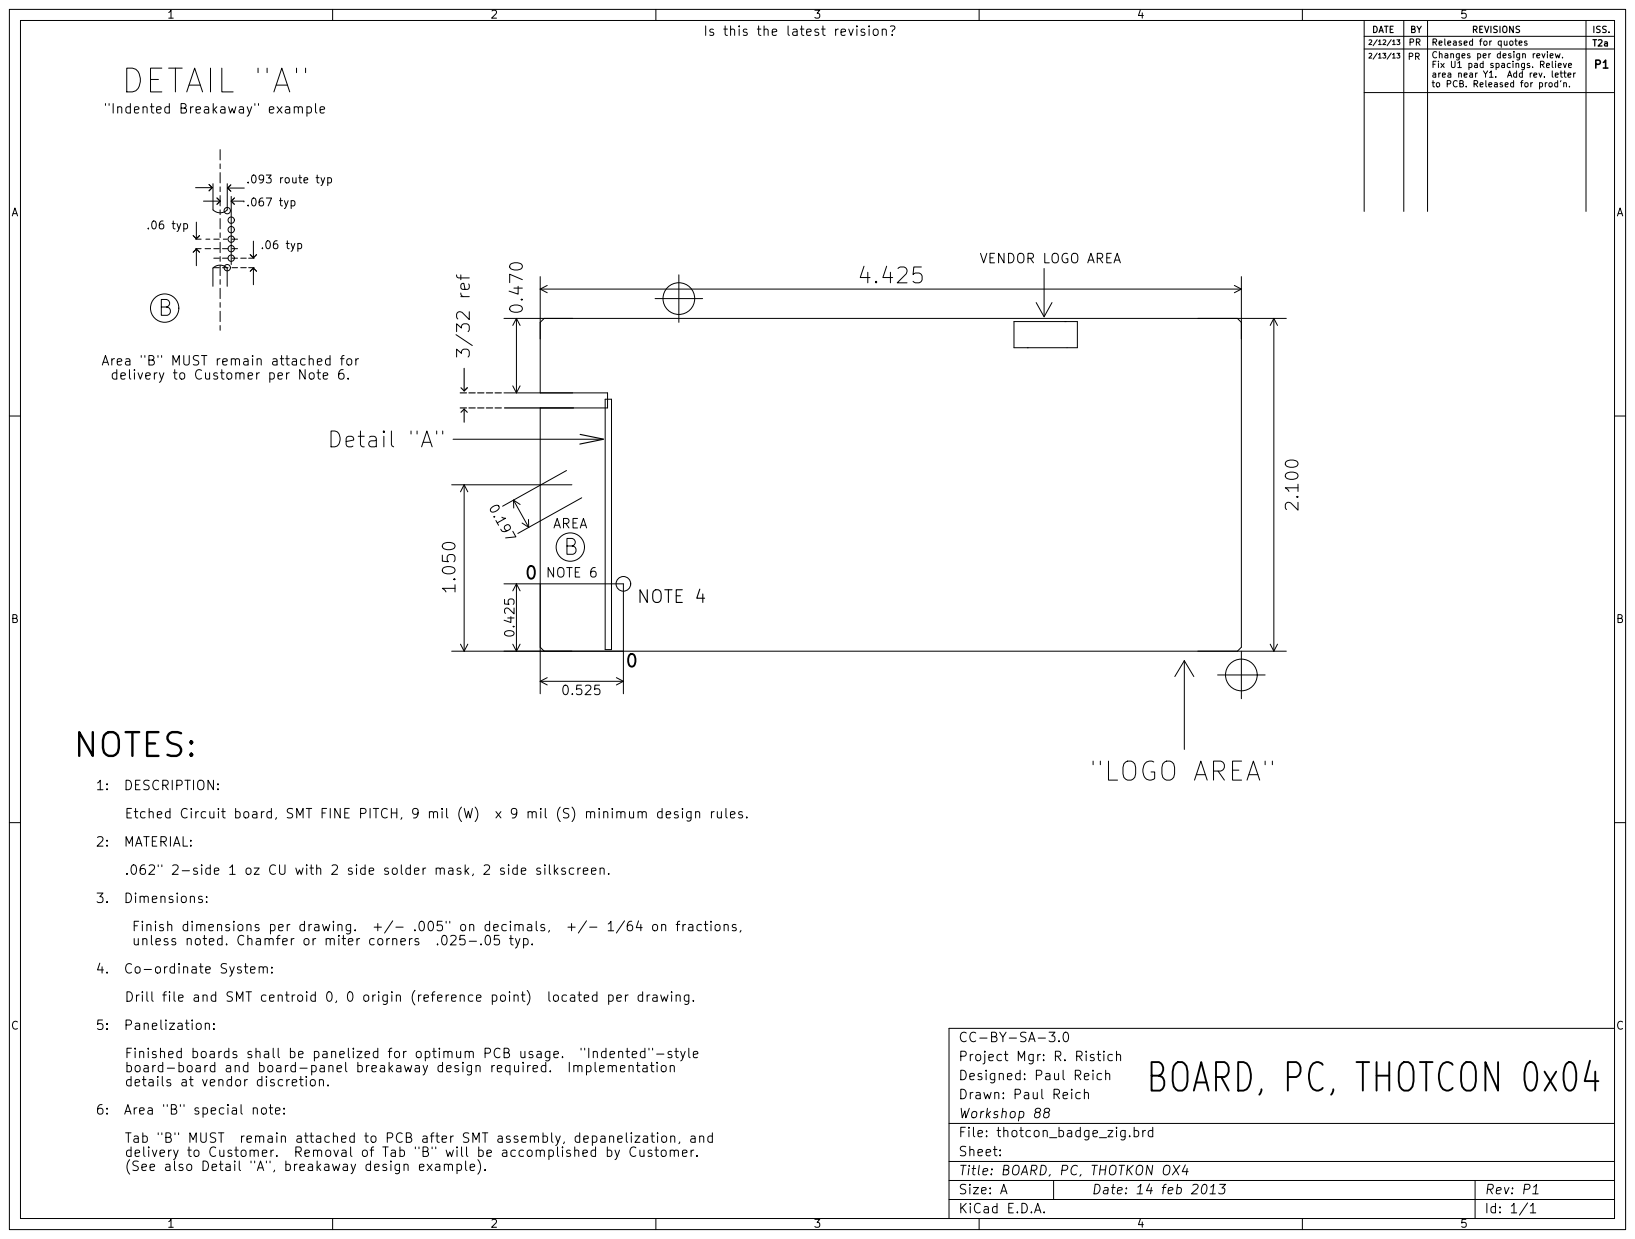
[picture p35: page 1]
