Workshop88/thotcon0x4/00PCB-layout/attic/iss_P1/release/thotcon_badge_zig-Edge_Cuts.pdf

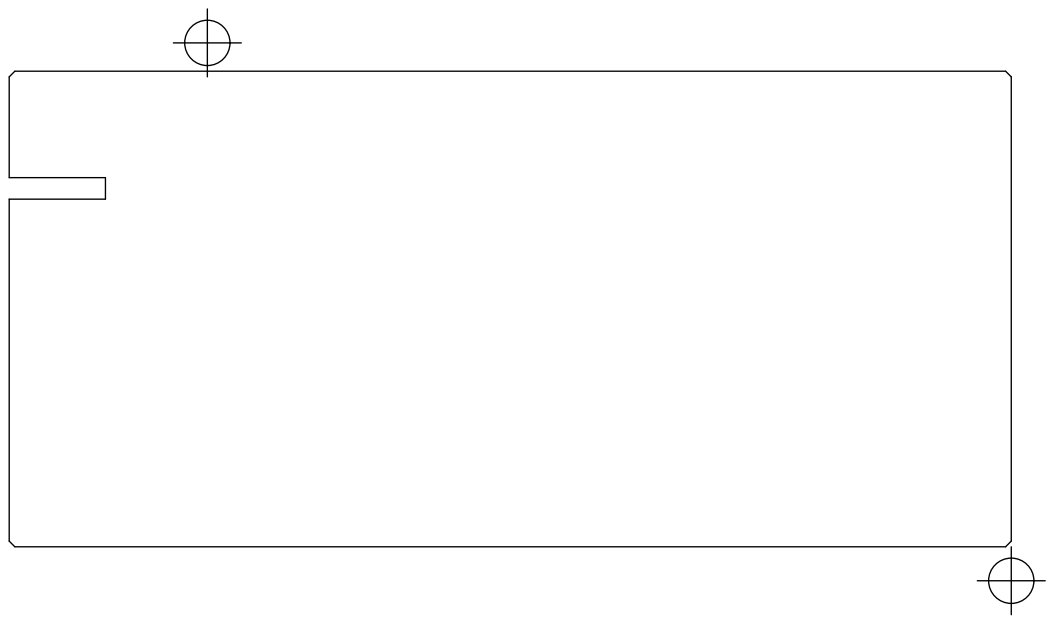
[picture p36: page 1]
