Workshop88/thotcon0x4/00PCB-layout/attic/iss_P1/release/thotcon_badge_zig-F_copper.pdf

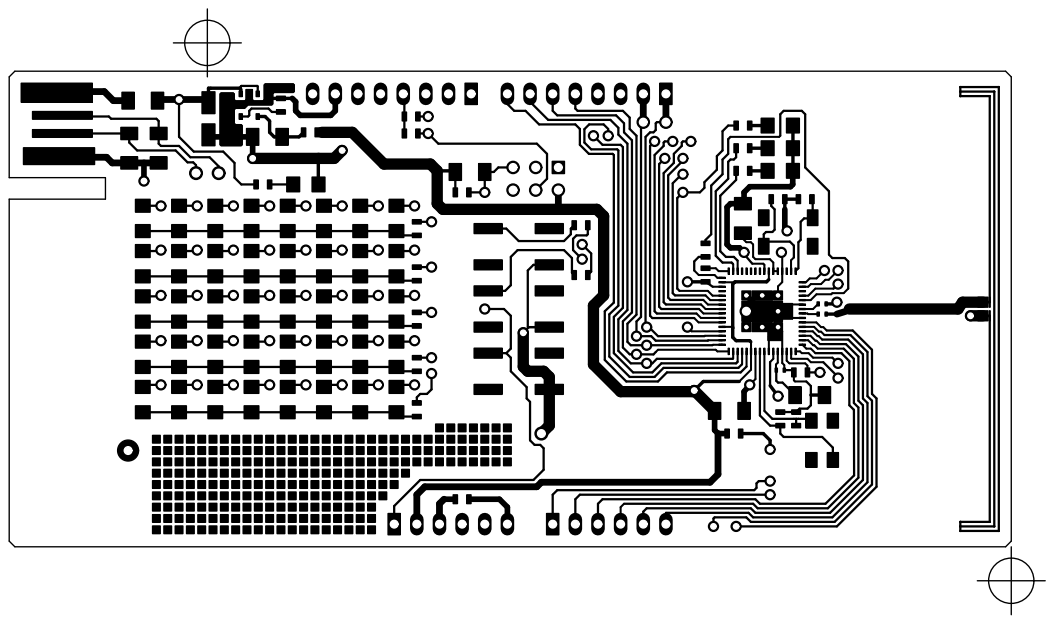
[picture p37: page 1]
