Workshop88/thotcon0x4/00PCB-layout/attic/iss_P1/release/thotcon_badge_zig-F_Mask.pdf

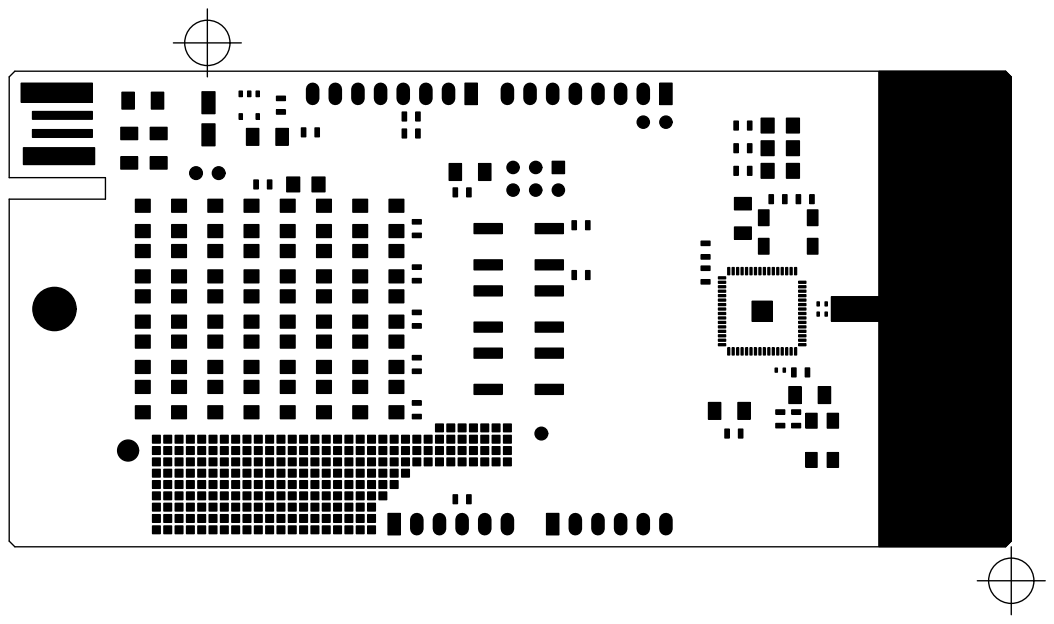
[picture p38: page 1]
