Workshop88/thotcon0x4/00PCB-layout/attic/iss_P1/release/thotcon_badge_zig-F_Paste.pdf

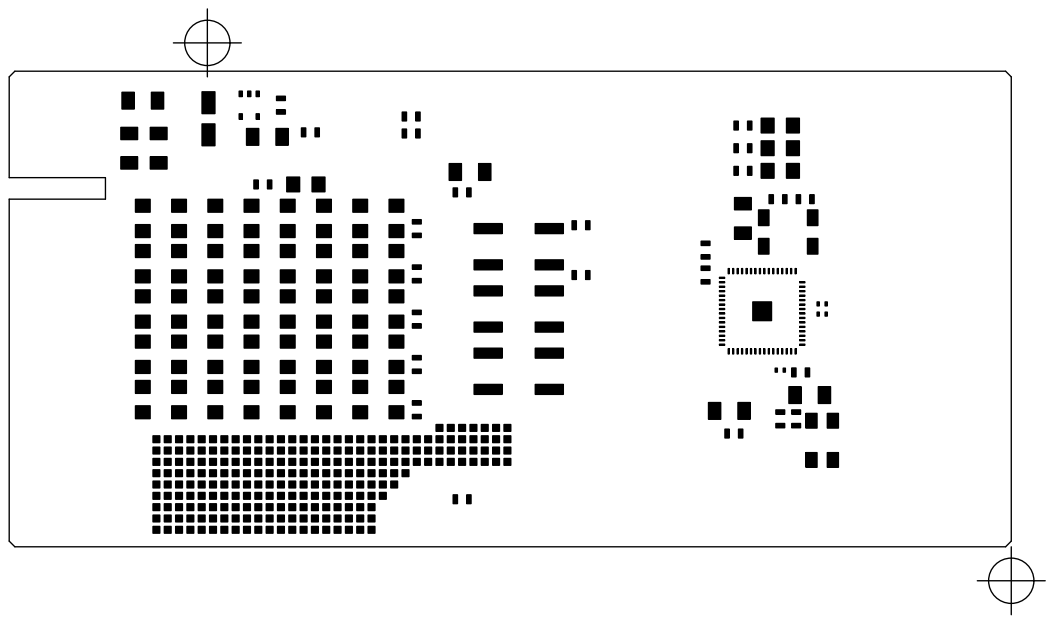
[picture p39: page 1]
