Workshop88/thotcon0x4/00PCB-layout/attic/iss_P1/release/thotcon_badge_zig-F_SilkS.pdf

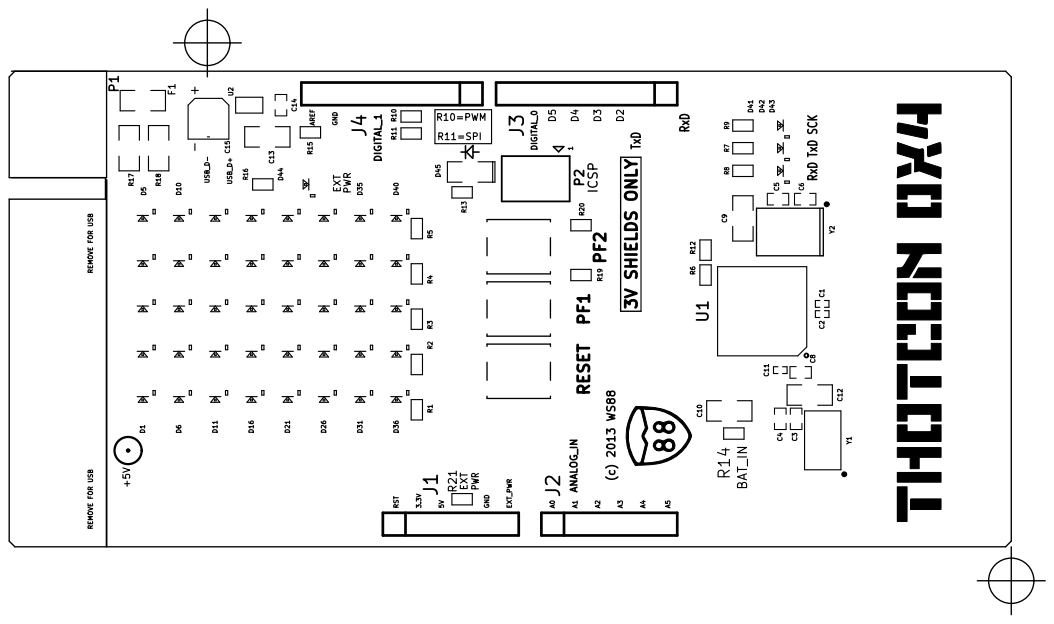
[picture p40: page 1]
