Workshop88/thotcon0x4/00PCB-layout/attic/iss_P2/release/thotcon_badge_zig-B_SilkS.pdf

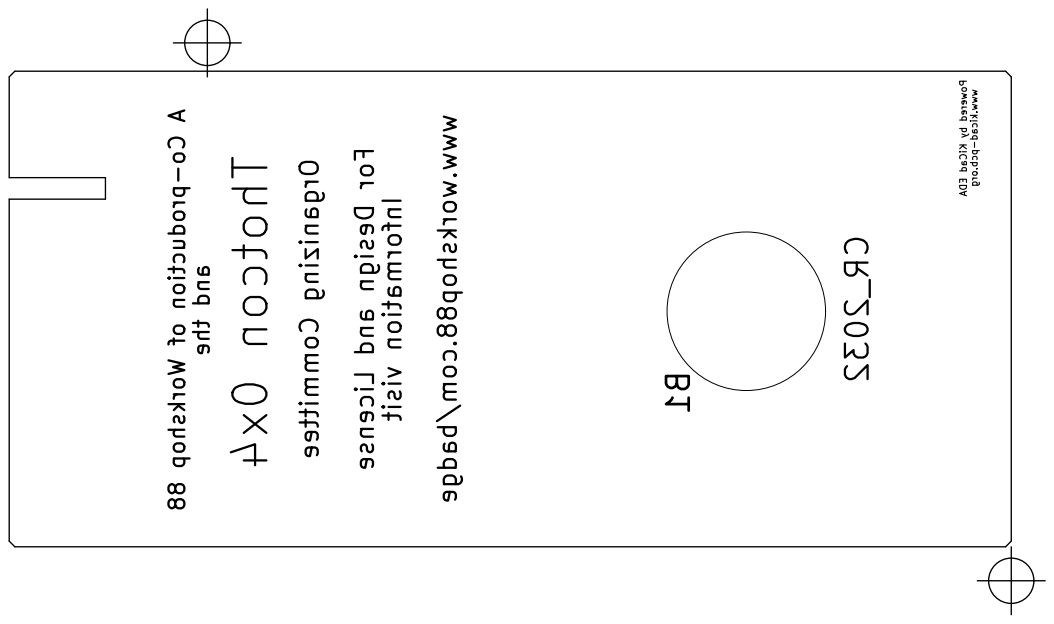
[picture p44: page 1]
