Workshop88/thotcon0x4/00PCB-layout/attic/iss_P2/release/thotcon_badge_zig-Dwgs_User.pdf

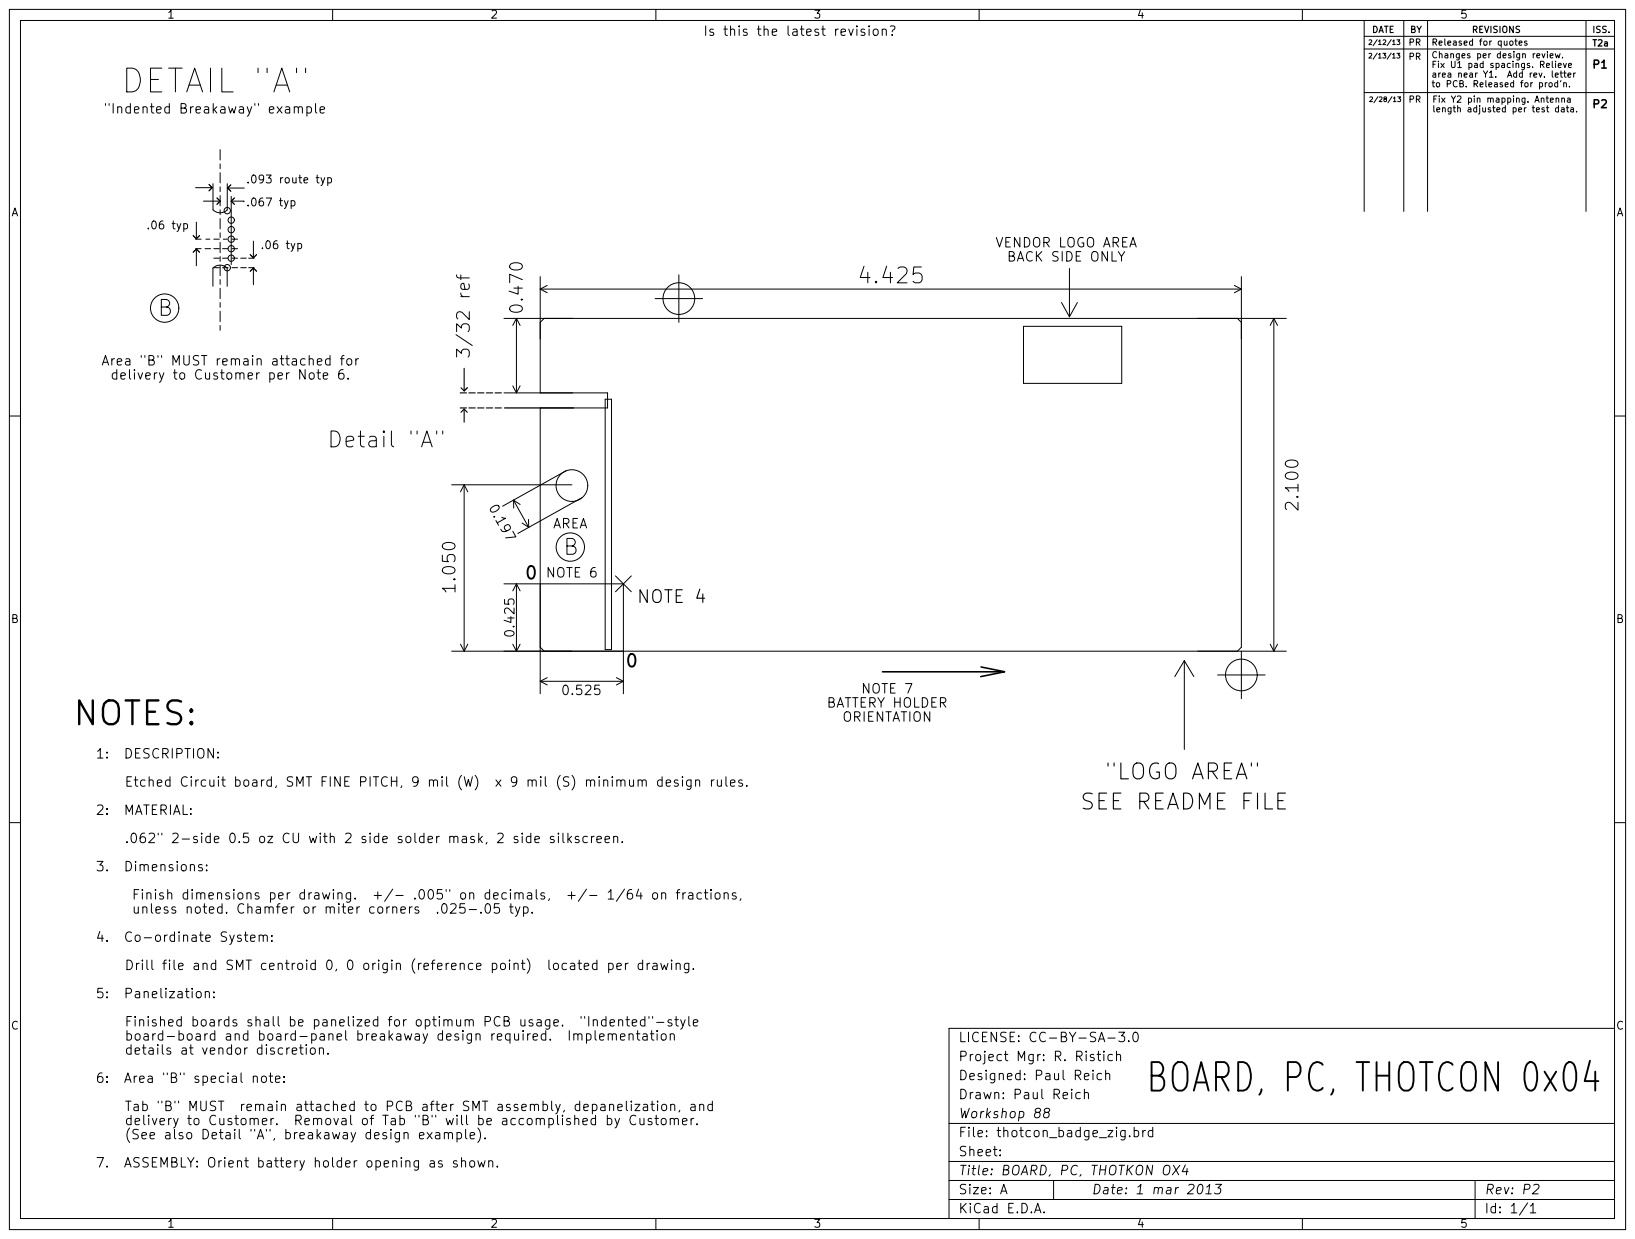
[picture p45: page 1]
