Workshop88/thotcon0x4/00PCB-layout/attic/iss_P2/release/thotcon_badge_zig-Edge_Cuts.pdf

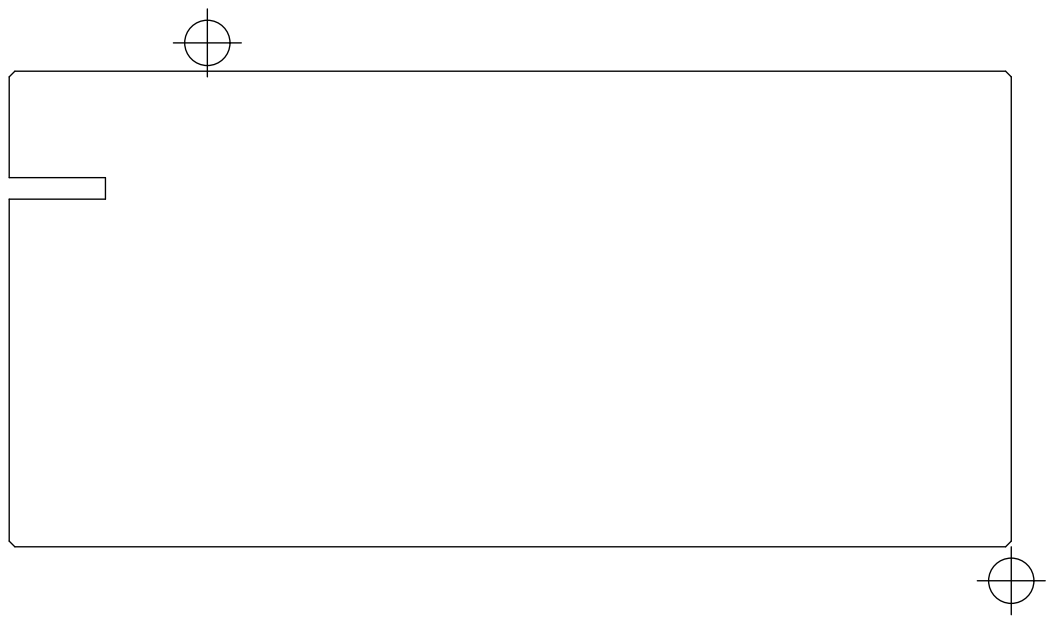
[picture p46: page 1]
