Workshop88/thotcon0x4/00PCB-layout/attic/iss_P2/release/thotcon_badge_zig-F_copper.pdf

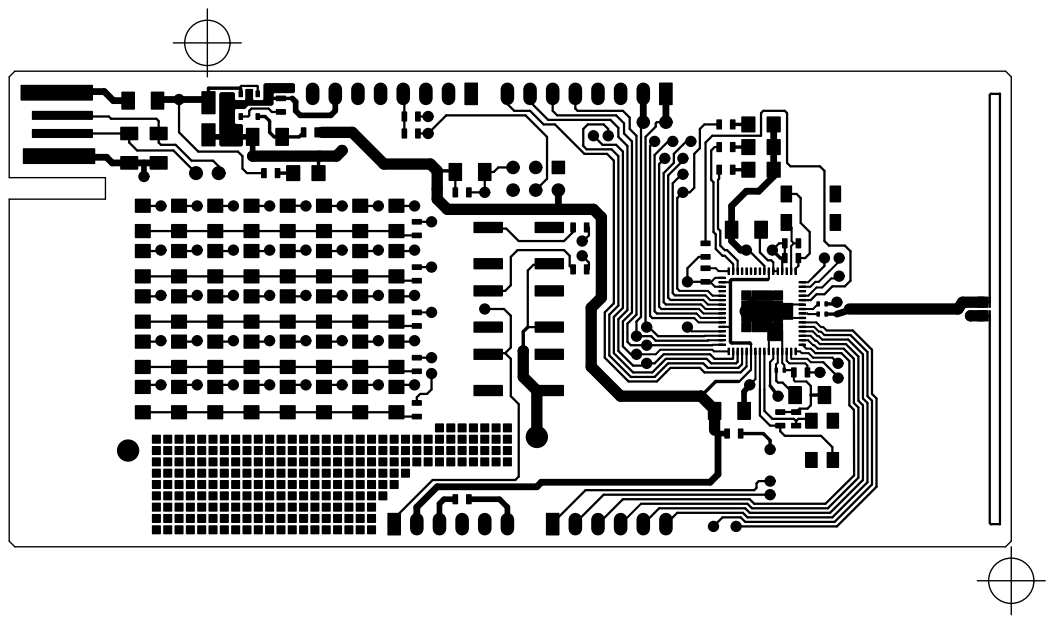
[picture p47: page 1]
