Workshop88/thotcon0x4/00PCB-layout/attic/iss_P2/release/thotcon_badge_zig-F_Mask.pdf

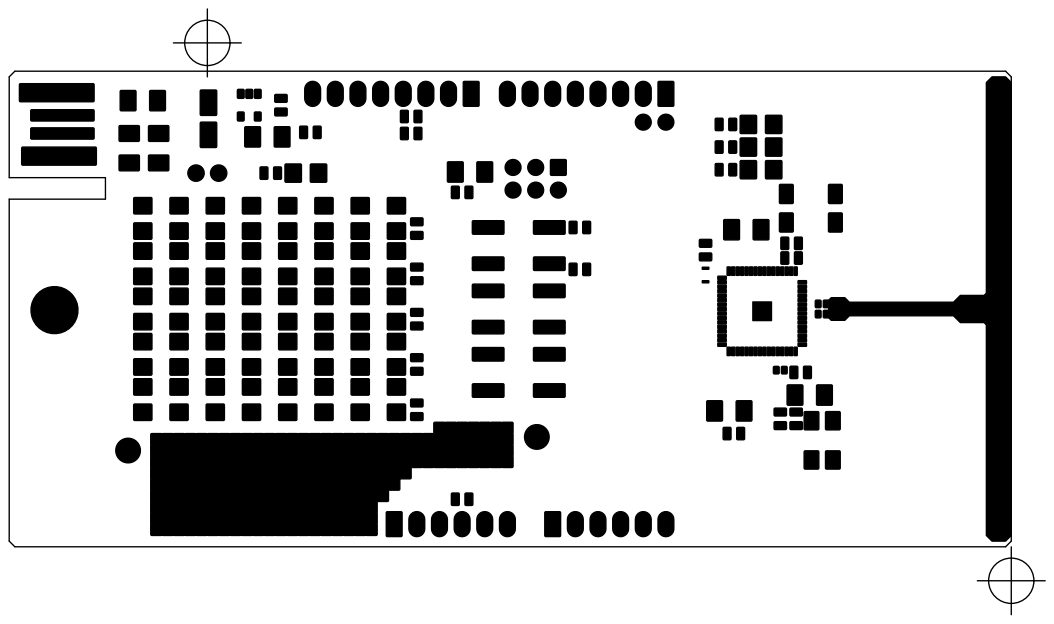
[picture p48: page 1]
