Workshop88/thotcon0x4/00PCB-layout/attic/iss_T1/release/thotcon_badge-SCH.pdf

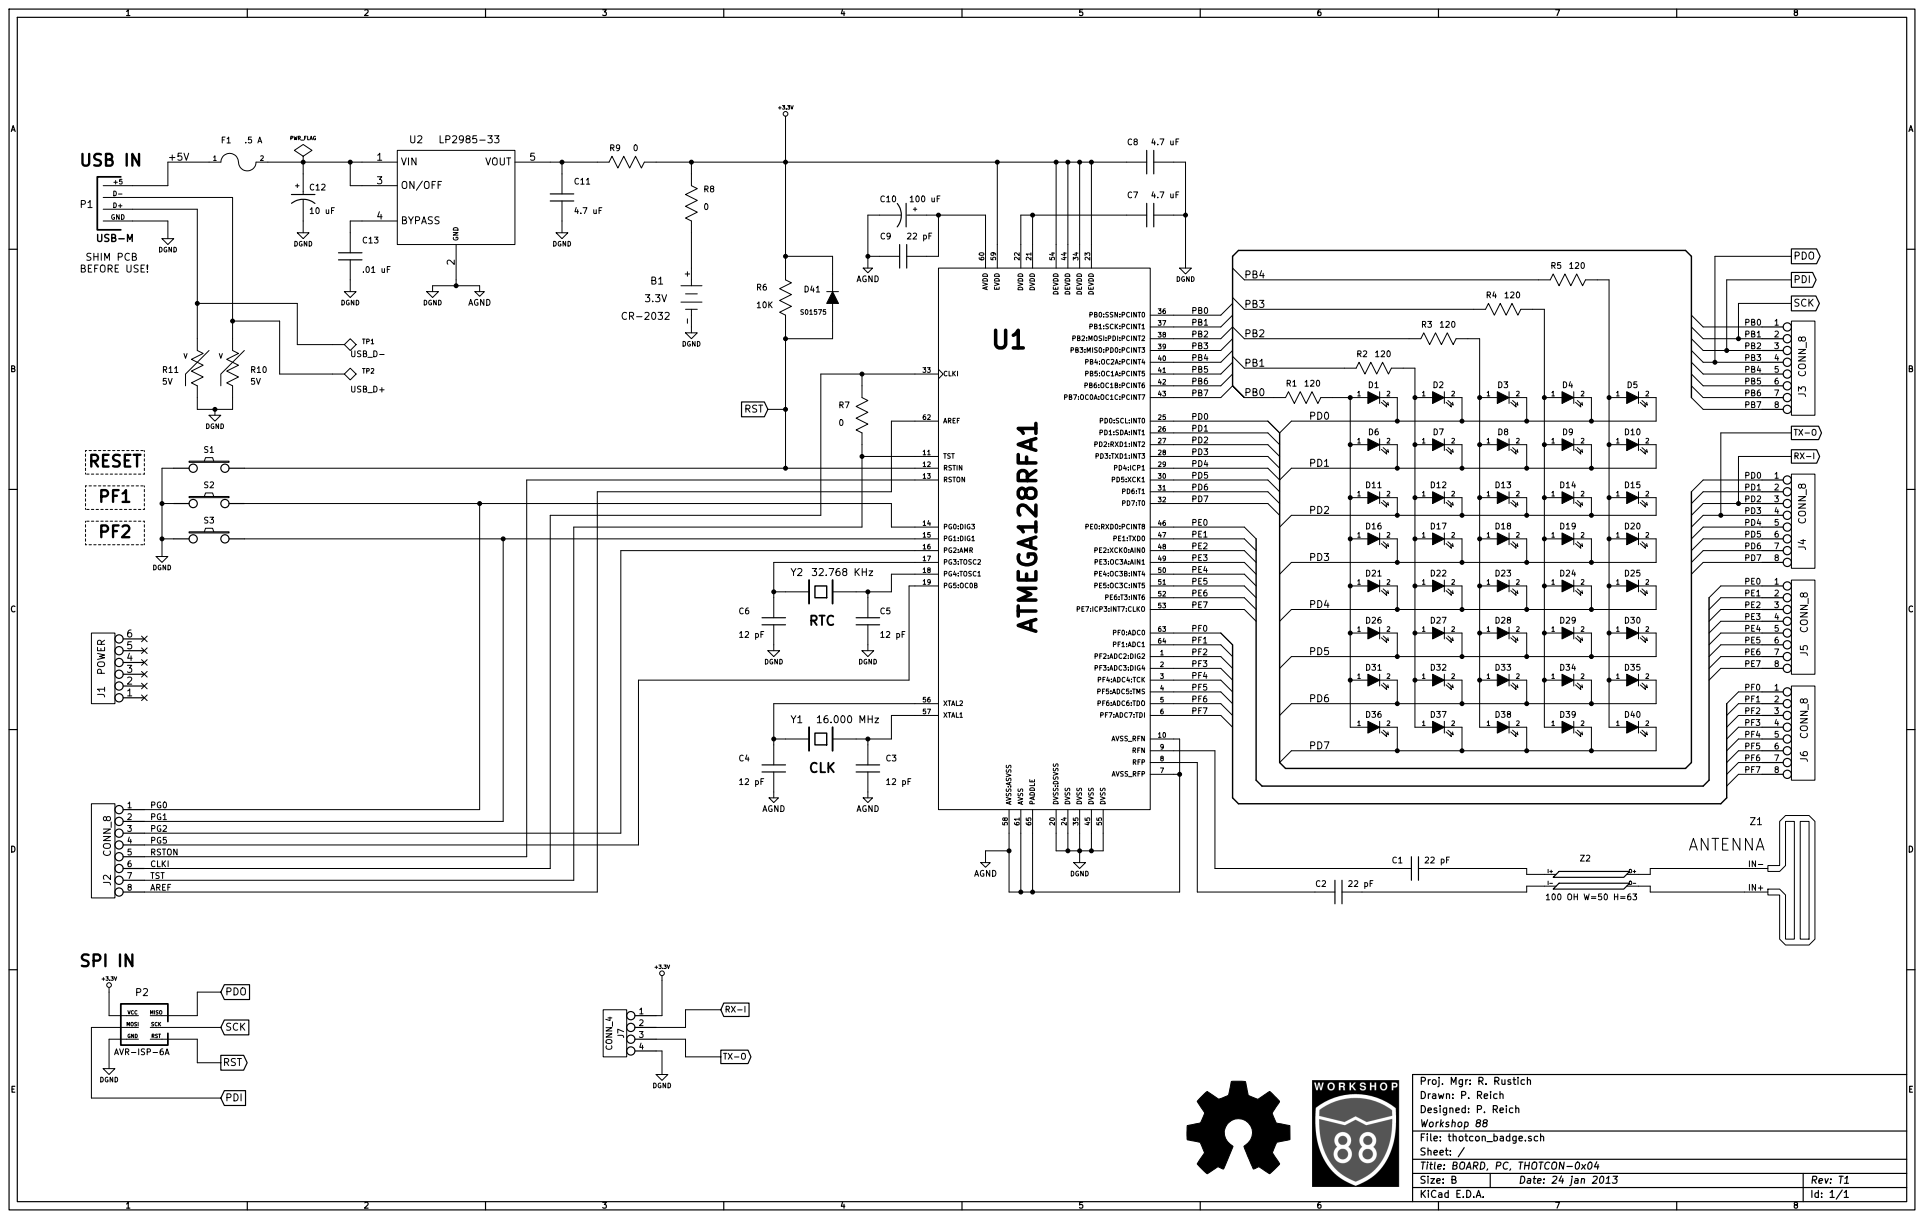
[picture p51: page 1]
