Workshop88/thotcon0x4/00PCB-layout/attic/iss_T2a/release/thotcon_badge_zig-Dwgs_User.pdf

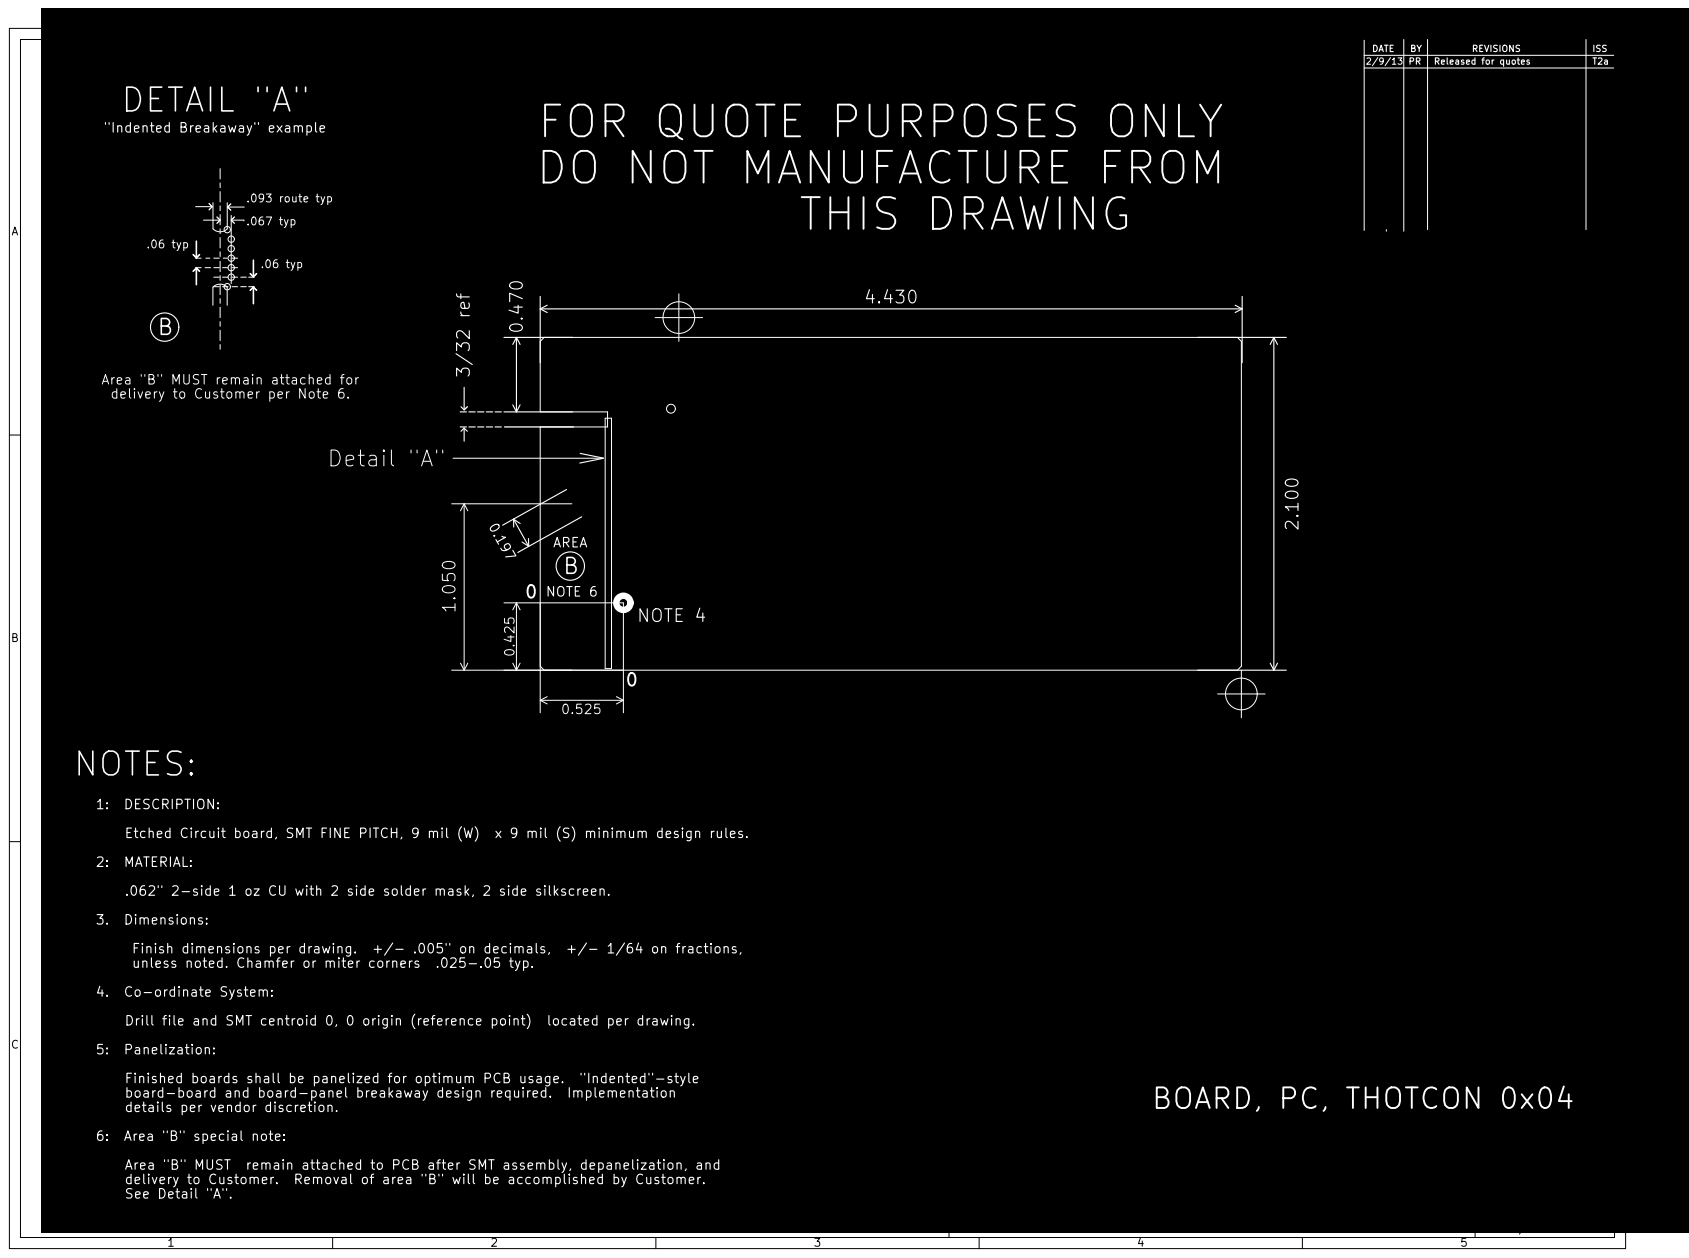
[picture p52: page 1]
