Workshop88/thotcon0x4/00PCB-layout/attic/iss_T2a/release/thotcon_badge_zig-F_SilkS.pdf

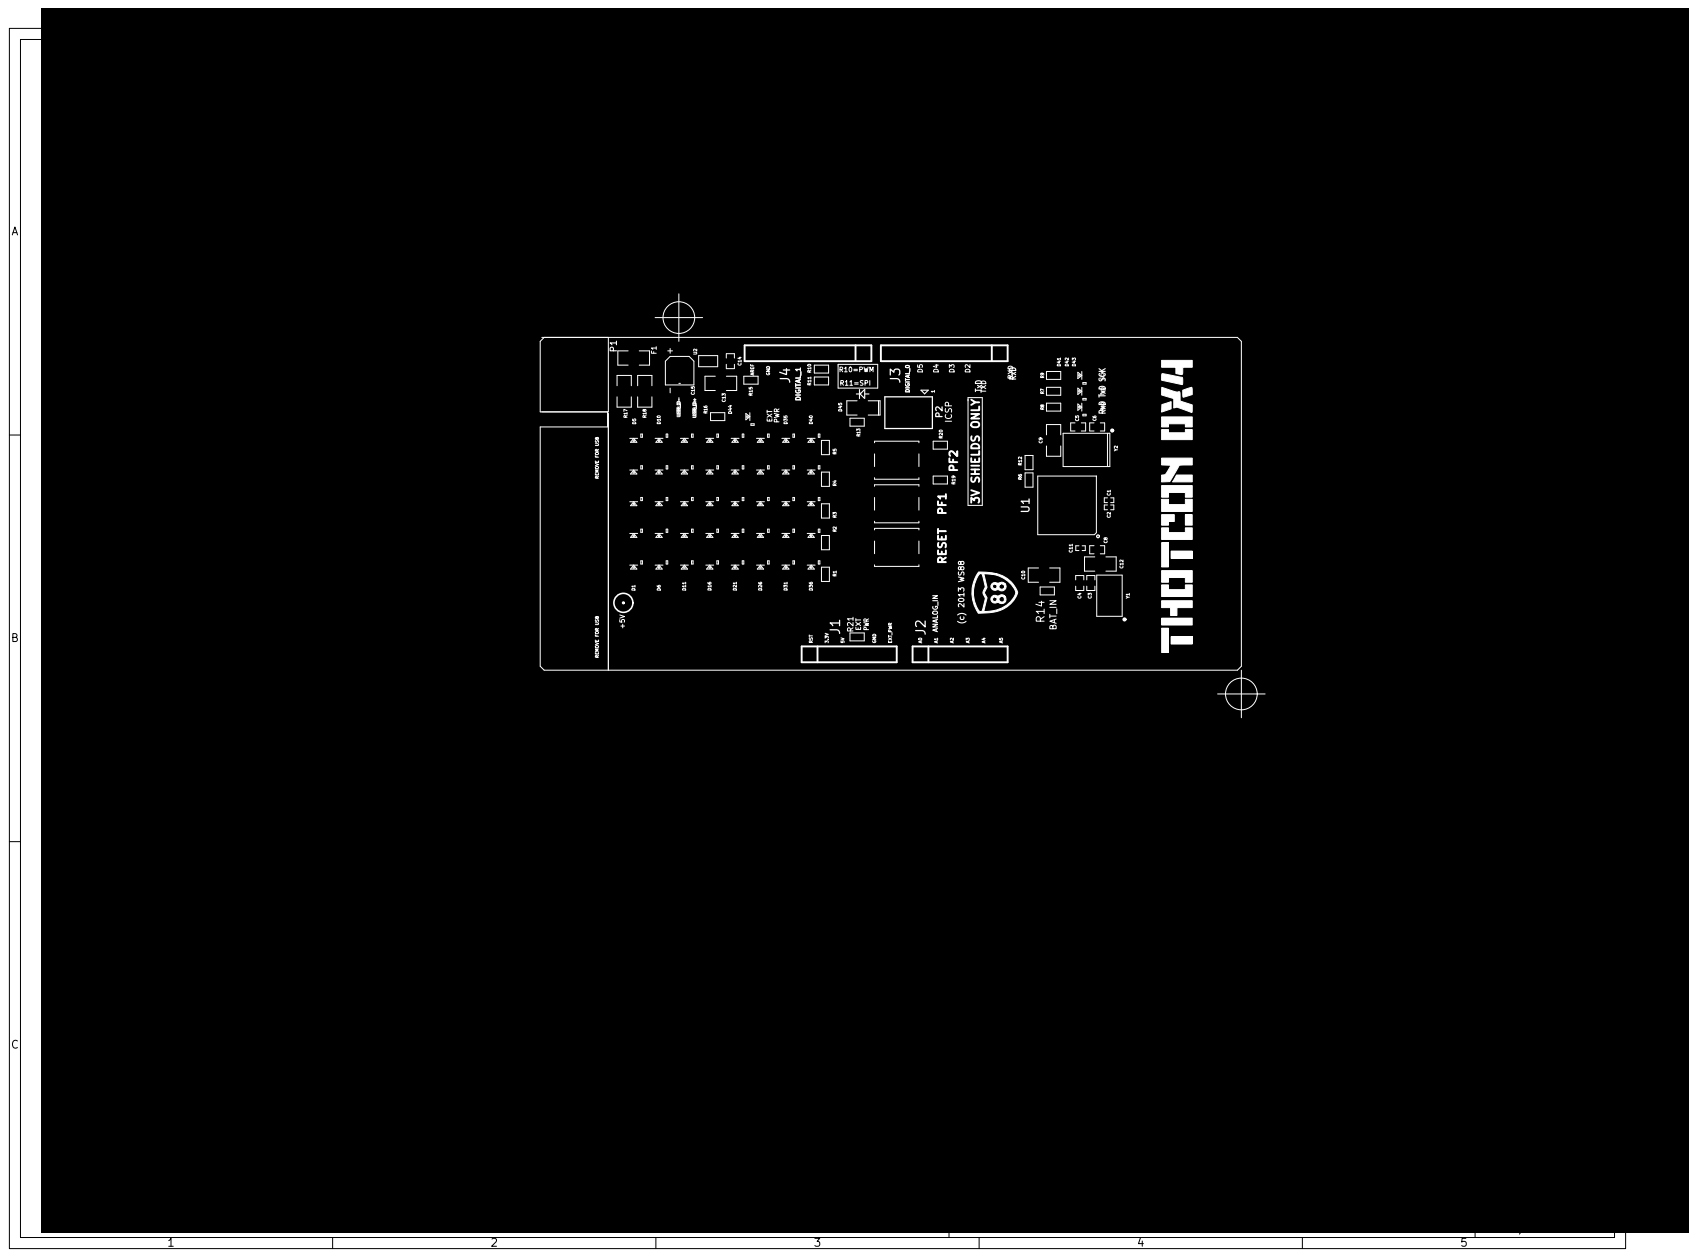
[picture p53: page 1]
