Workshop88/thotcon0x4/00PCB-layout/development/fixture/programming/thotcon_badge_zig-Cmts_User.pdf

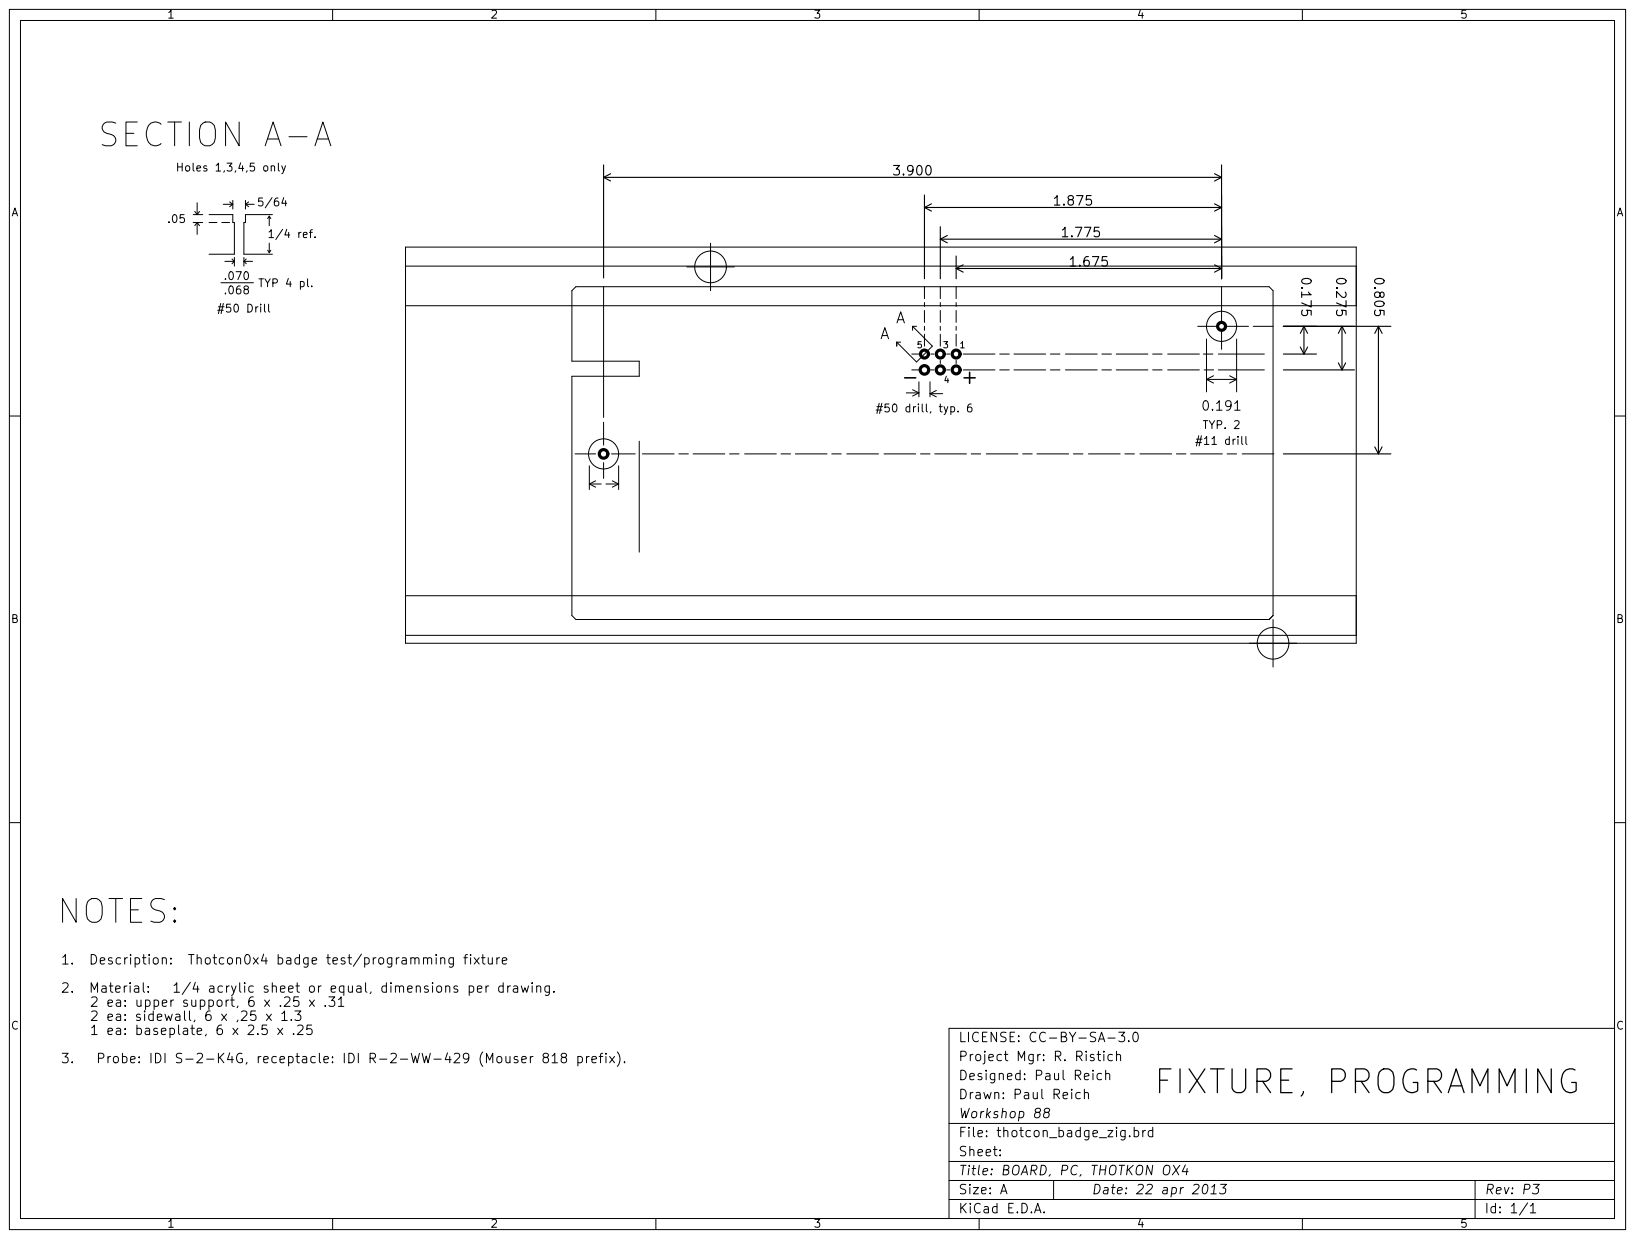
[picture p54: page 1]
