Workshop88/thotcon0x4/00PCB-layout/development/iss_P3/release/thotcon_badge_zig-B_copper.pdf

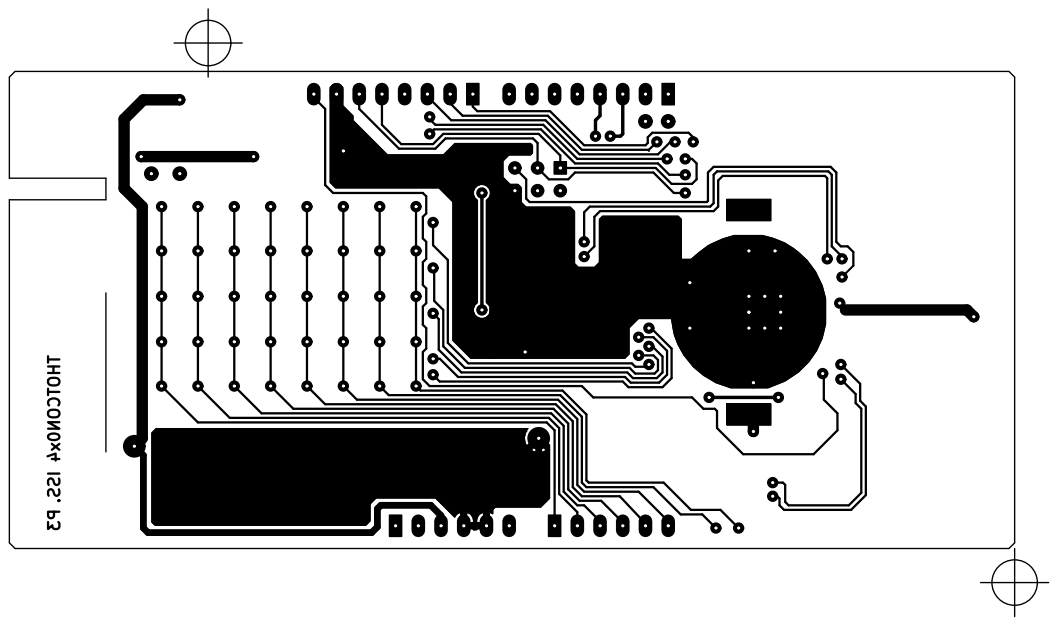
[picture p55: page 1]
