Workshop88/thotcon0x4/00PCB-layout/development/iss_P3/release/thotcon_badge_zig-B_Paste.pdf

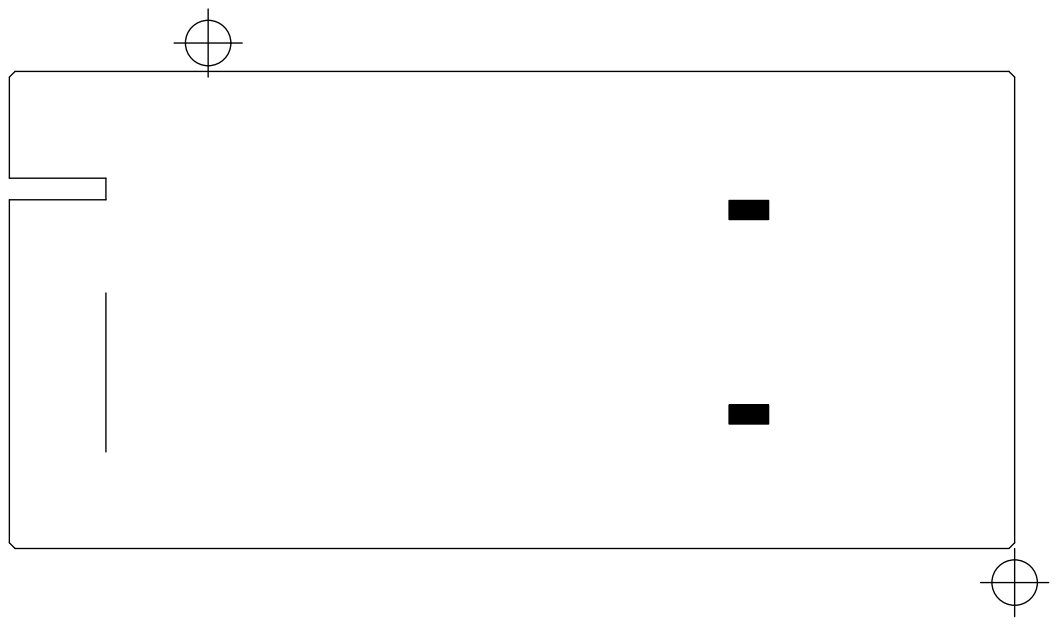
[picture p57: page 1]
