Workshop88/thotcon0x4/00PCB-layout/development/iss_P3/release/thotcon_badge_zig-Dwgs_User.pdf

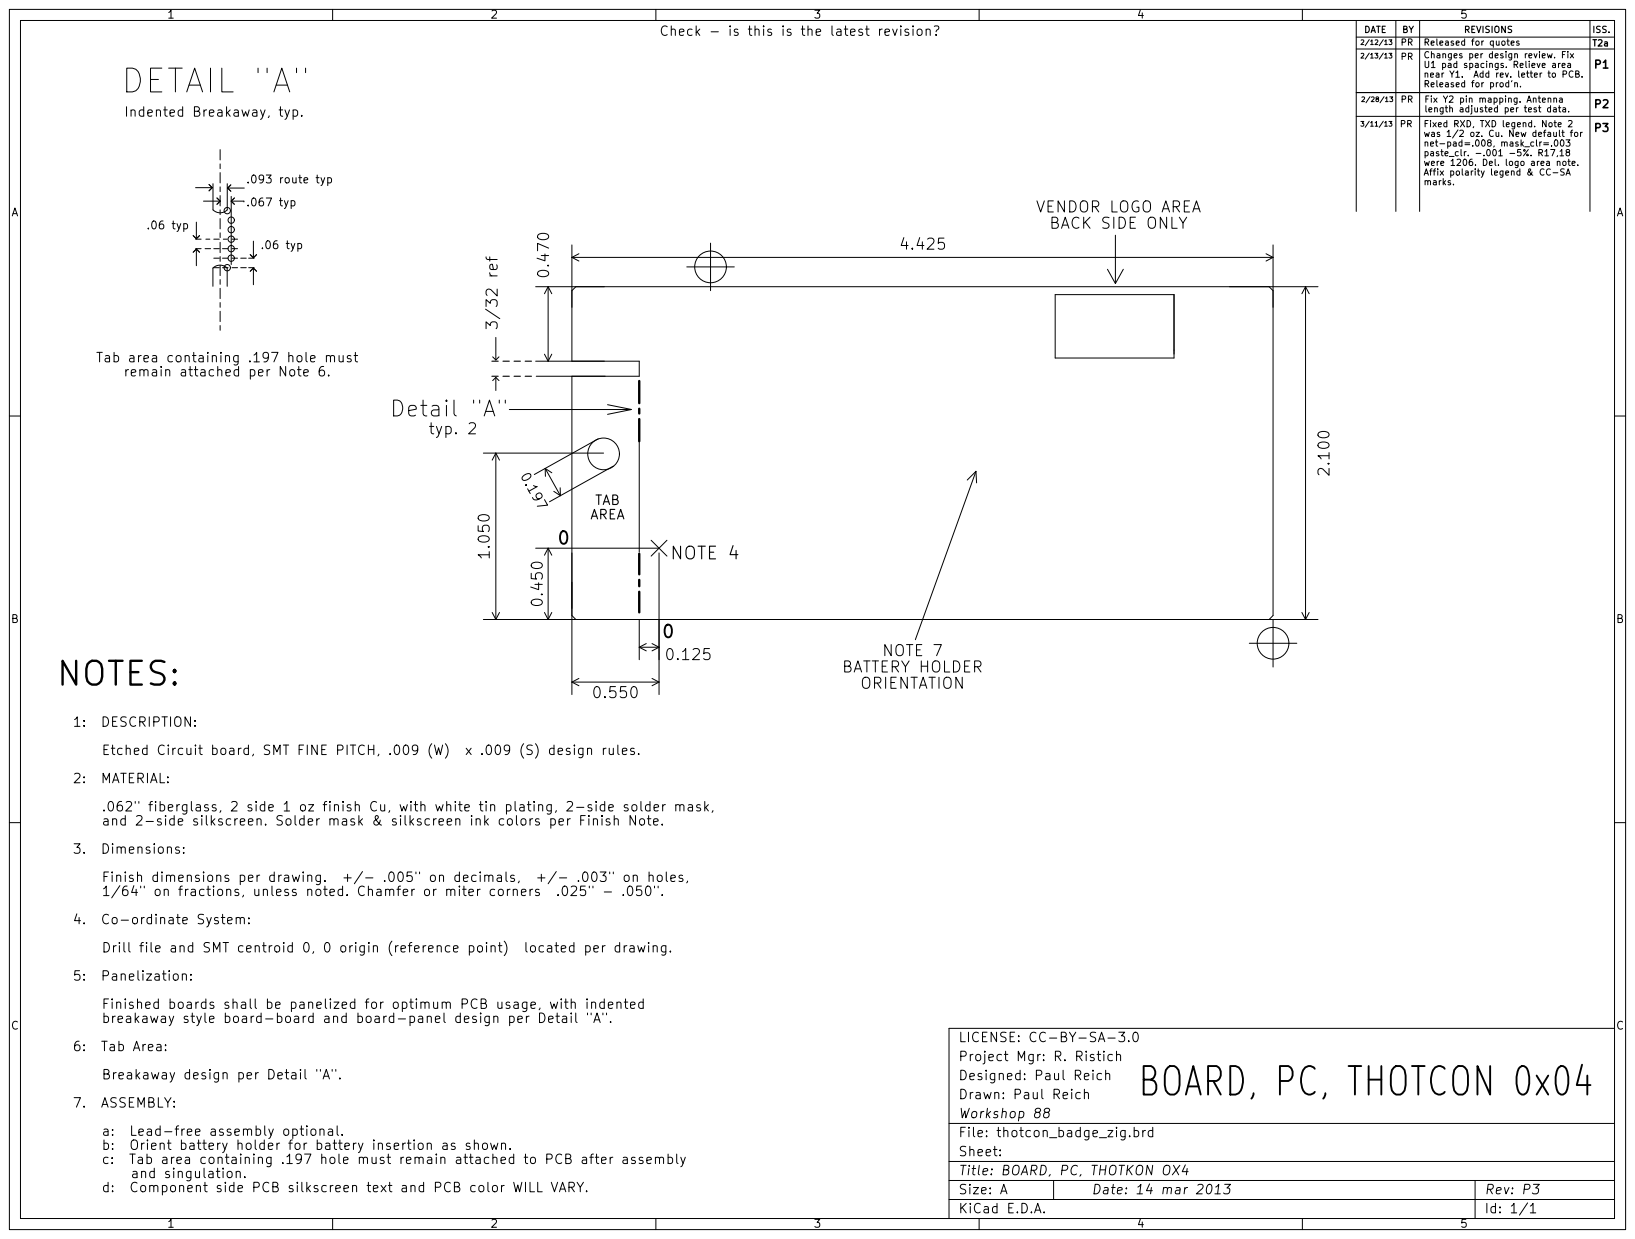
[picture p60: page 1]
