Workshop88/thotcon0x4/00PCB-layout/development/iss_P3/release/thotcon_badge_zig-Edge_Cuts.pdf

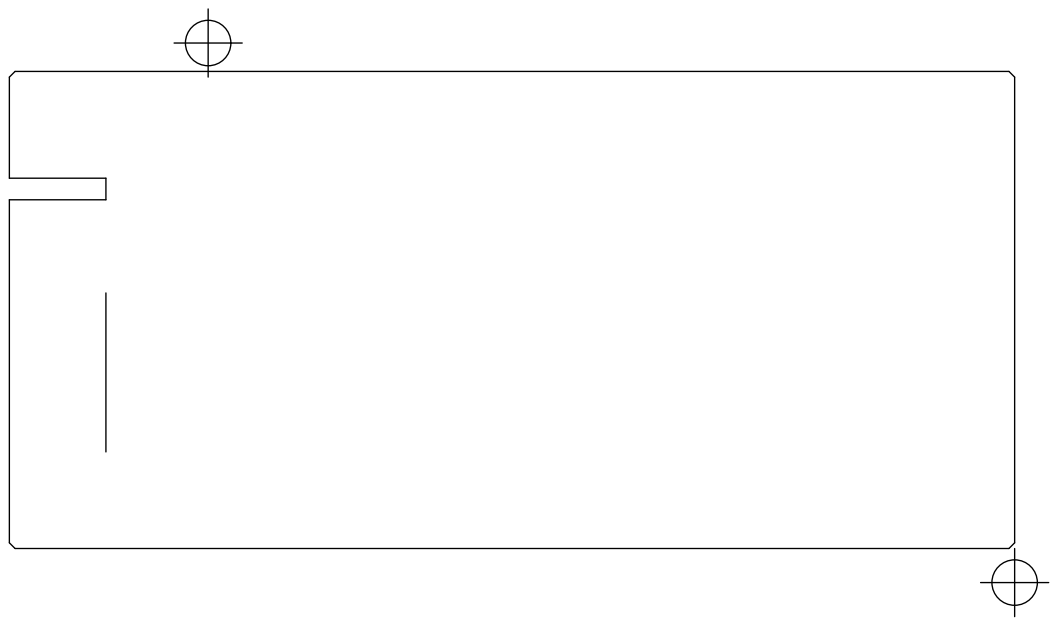
[picture p61: page 1]
