Workshop88/thotcon0x4/00PCB-layout/development/iss_P3/release/thotcon_badge_zig-F_Mask.pdf

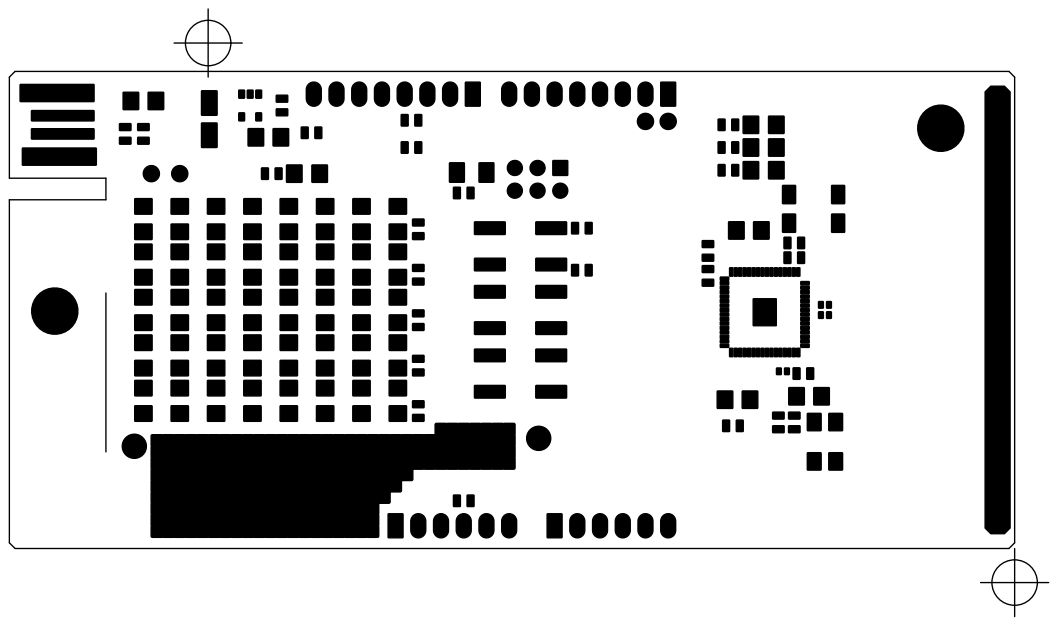
[picture p63: page 1]
