Workshop88/thotcon0x4/00PCB-layout/development/iss_P3/release/thotcon_badge_zig-F_Paste.pdf

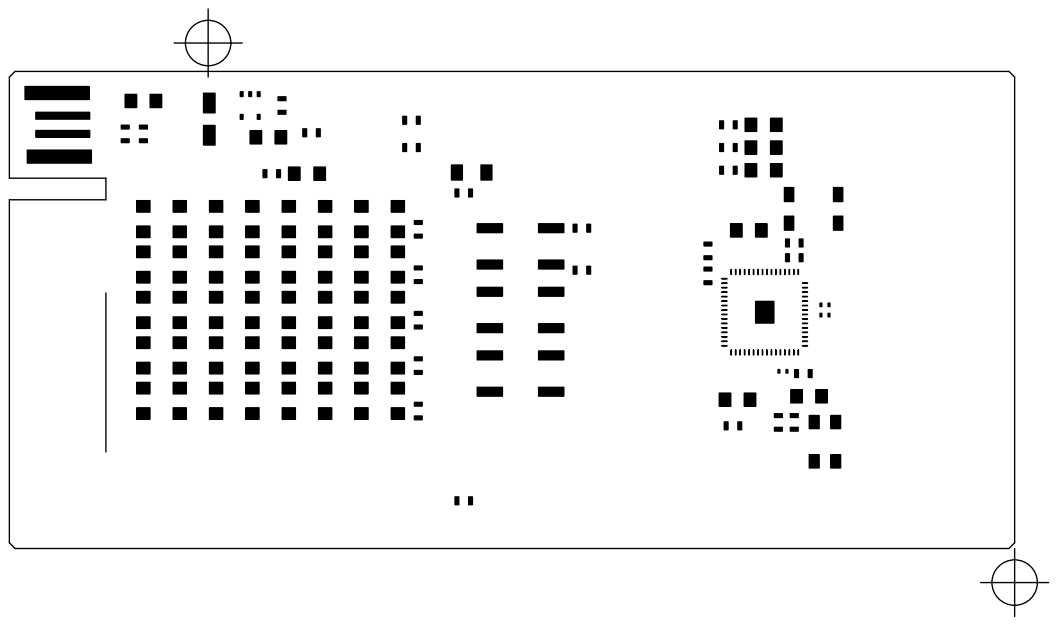
[picture p64: page 1]
