Workshop88/thotcon0x4/00PCB-layout/development/iss_P3/release/thotcon_badge_zig-F_SilkS.pdf

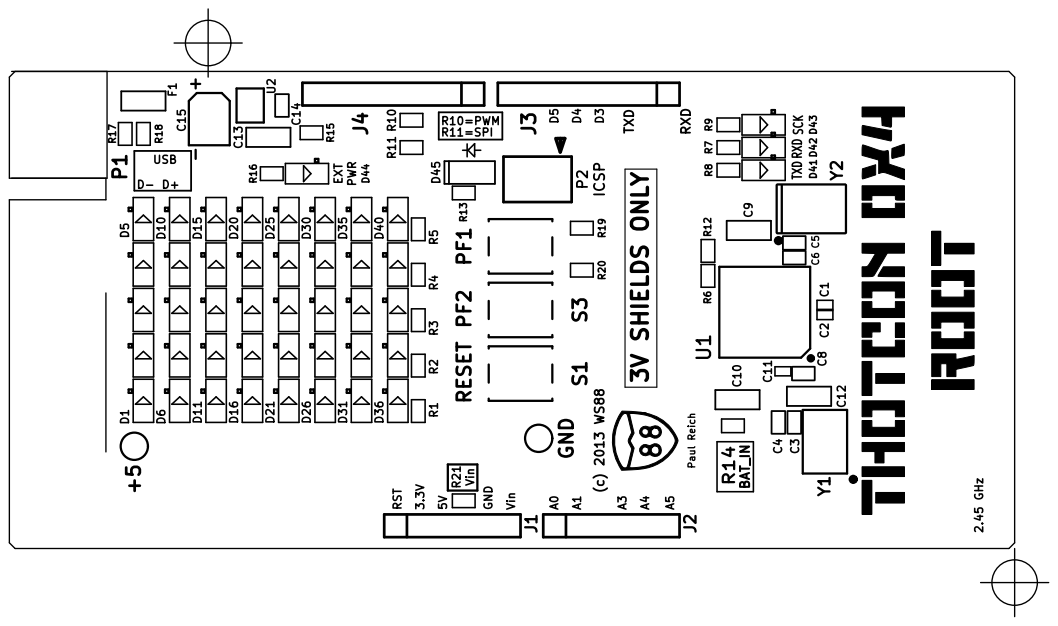
[picture p65: page 1]
