Workshop88/thotcon0x4/00PCB-layout/attic/iss_T1/thotcon_badge.sch

## KiCad design 00PCB-layout/attic/iss_T1/thotcon_badge.sch (2014-10-28)

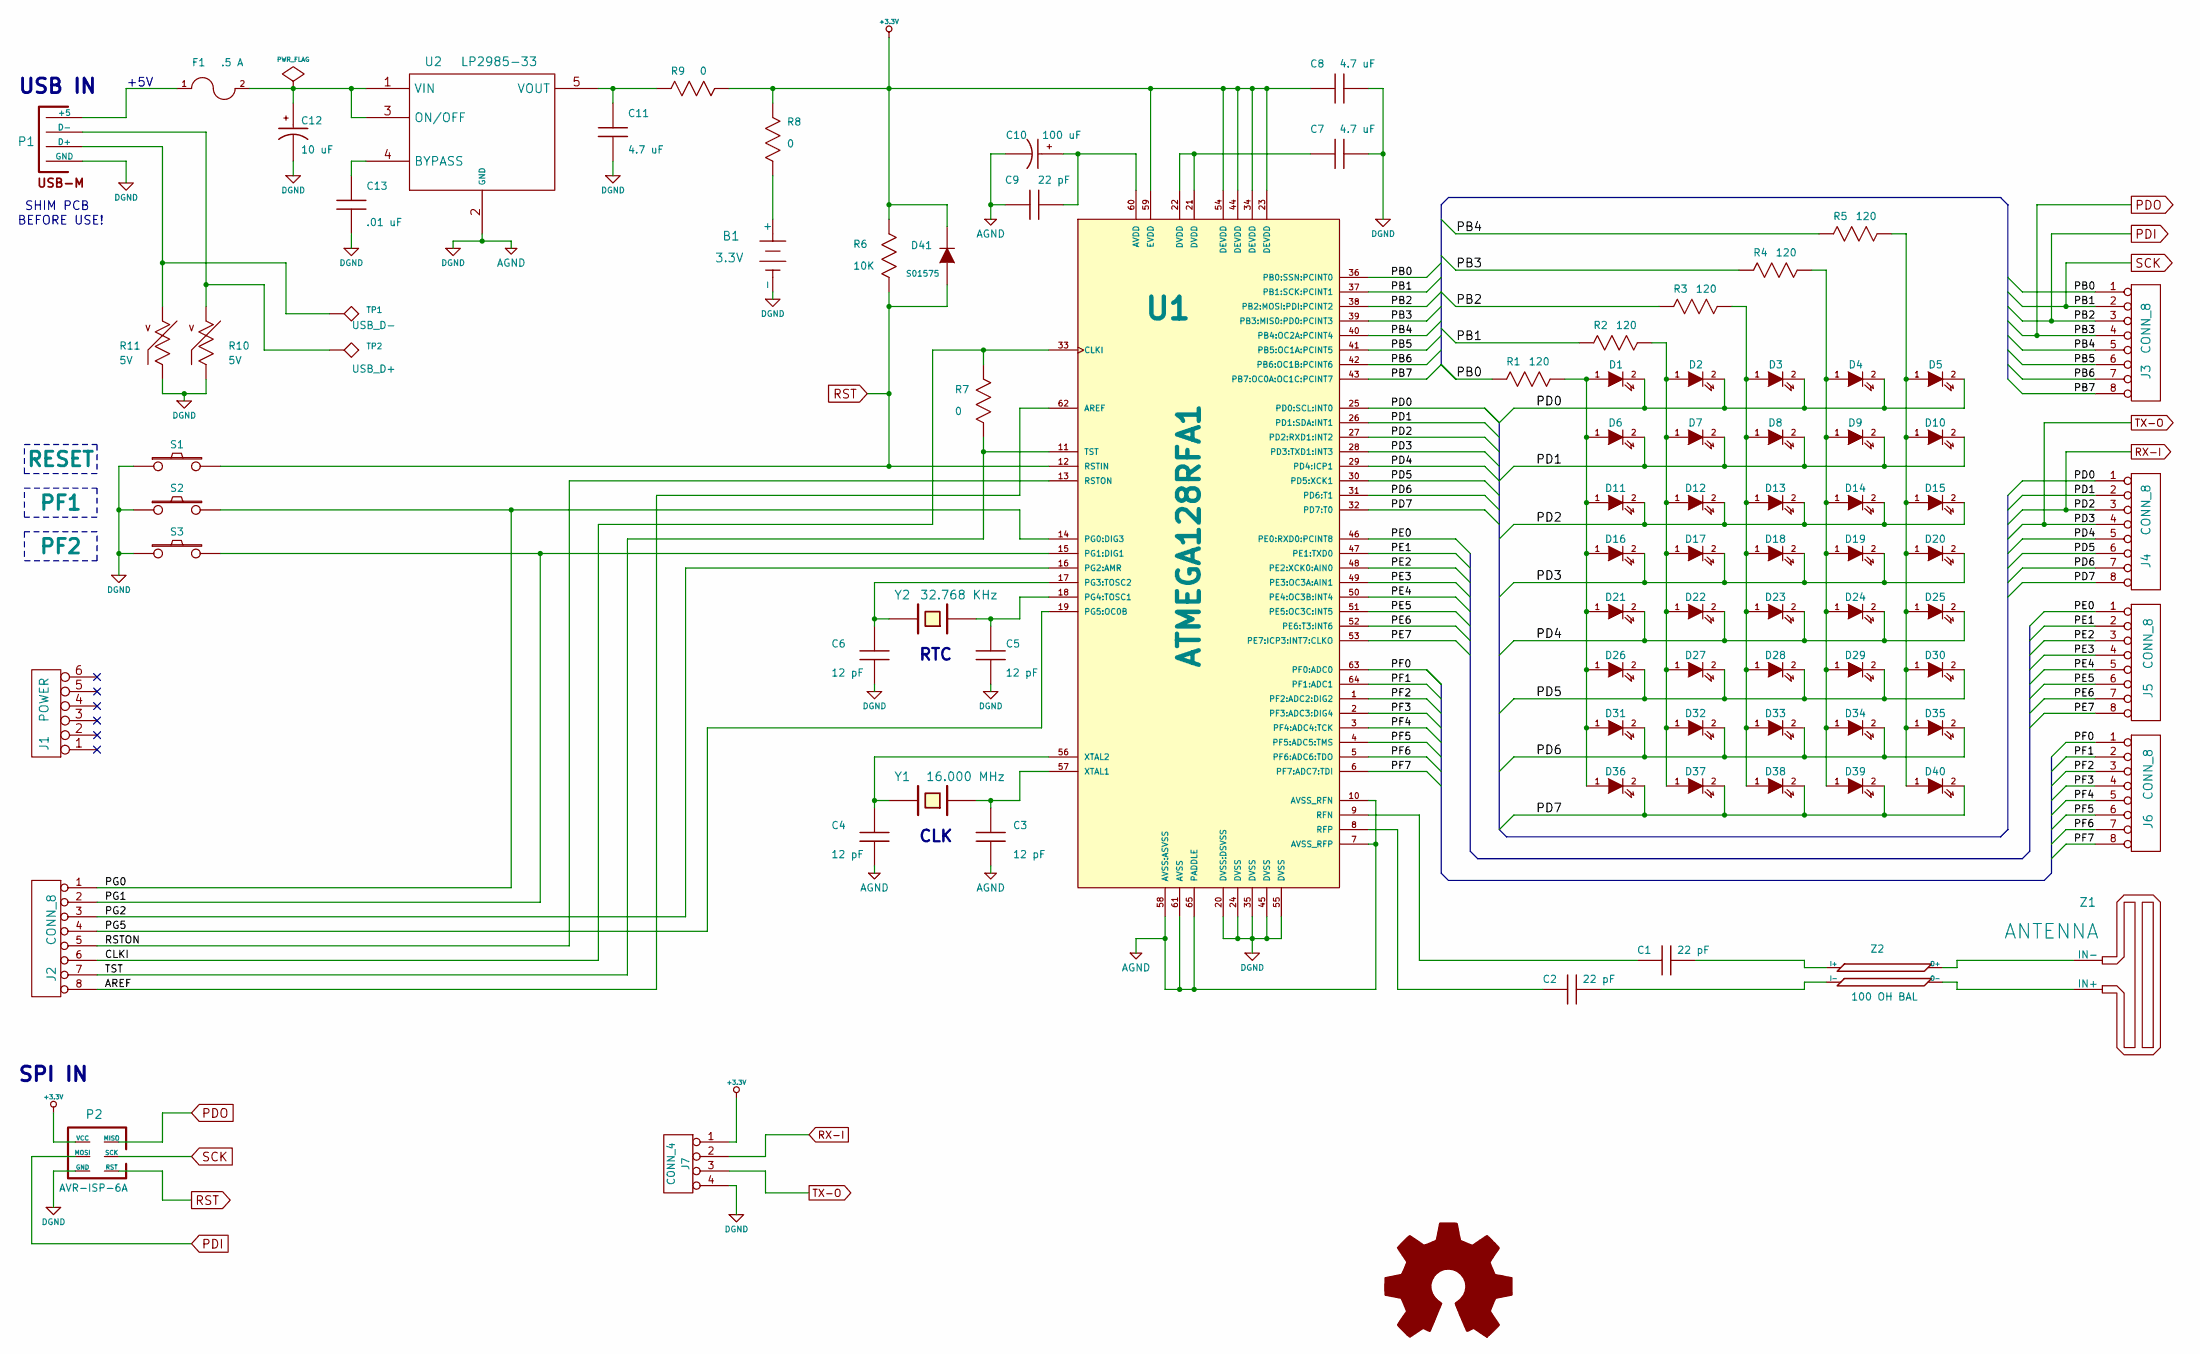
[picture p68: schematic thotcon_badge.sch]

Parts:
B1: 3.3V; MFR_PN BAT-HLD-001
C1, C2: 22 pF; MFR_PN 04023U220JAT2A
C3, C4, C5, C6: 12 pF; MFR_PN GRM1885C1H120JA01D
C7, C8, C11: 4.7 uF; 1206; MFR_PN GRM31CR71E475KA88L
C9: 22 pF; 0402; MFR_PN 04023U220JAT2A
C10: 100 uF; MFR_PN UWX0J101MCL1GB
C12: 10 uF; MFR_PN UWF1C100MCL1GB
C13: .01 uF; 0603; MFR_PN GRM188R71C103KA01D
D1: RED; 1206; MFR_PN APTL3216SURCK
D2, D3, D4, D5, D6, D7, D8, D9, D10, D11, D12, D13, D14, D15, D16, D17, D18, D19, D20, D21, D22, D23, D24, D25, D26, D27, D28, D29, D30, D31, D32, D33, D34, D35, D36, D37, D38, D39, D40: RED; MFR_PN APTL3216SURCK
D41: S01575; MFR_PN CD1206-S01575
F1: .5 A; 1206; MFR_PN 1206L050/15YR
J1: POWER; MFR_PN M20-7820646
J2, J3, J4, J5, J6: CONN_8; MFR_PN M20-7820842
J7: CONN_4
OHL1: LABEL
P1: USB_2_MALE
P2: AVR-ISP-6A; AVR-ISP-6
R1, R2, R3, R4, R5: 120; 0603; MFR_PN ERJ-3GEYJ121V
R6: 10K; 0603; MFR_PN ERJ-3GEYJ103V
R7, R8, R9: 0; MFR_PN ERJ-3GEY0R00V
R10, R11: 5V; MFR_PN CG0603MLC-05E
S1: RESET; MFR_PN EVQQ2P02W
S2: PF1; MFR_PN EVQQ2R02W
S3: PF2; MFR_PN EVQQ2P02W
TP1: USB_D-
TP2: USB_D+
U1: ATMEGA128RFA1; QFN64; MFR_PN ATMEGA128RFA1-ZU
U2: LP2985-33; SOT-5; MFR_PN LP2985-33DBVR
Y1: 16.000 MHz; MFR_PN ABMM-16.000MHZ-B2-T
Y2: 32.768 KHz; MFR_PN 520-ECS327-12.5-17X-TR
Z1: ANTENNA
Z2: 100 OH BAL; MFR_PN W=50 H=63 T=1

Connections:
+3.3V: C8.1, D41.2 (K), J7.1, P2.2 (VCC), R6.1, R8.2, R9.2, U1.23 (DEVDD), U1.34 (DEVDD), U1.44 (DEVDD), U1.54 (DEVDD), U1.59 (EVDD)
AGND: B1.2 (-), C3.2, C4.2, C5.2, C6.2, C7.2, C8.2, C9.1, C10.2, C11.2, C12.2, C13.2, J7.4, P1.4 (GND), P2.6 (GND), R10.2, R11.2, S1.1, S2.1, S3.1, U1.7 (AVSS_RFP), U1.10 (AVSS_RFN), U1.20 (DVSS:DSVSS), U1.24 (DVSS), U1.35 (DVSS), U1.45 (DVSS), U1.55 (DVSS), U1.58 (AVSS:ASVSS), U1.61 (AVSS), U1.65 (PADDLE), U2.2 (GND)
AREF: J2.8, U1.62 (AREF)
CLKI: J2.6, R7.1, U1.33 (CLKI)
unnamed: B1.1 (+), R8.1
unnamed: C1.1, U1.9 (RFN)
unnamed: C1.2, Z2.1 (I+)
unnamed: C2.1, U1.8 (RFP)
unnamed: C2.2, Z2.3 (I-)
unnamed: C3.1, U1.57 (XTAL1), Y1.1
unnamed: C4.1, U1.56 (XTAL2), Y1.2
unnamed: C5.1, U1.18 (PG4:TOSC1), Y2.1
unnamed: C6.1, U1.17 (PG3:TOSC2), Y2.2
unnamed: C7.1, U1.21 (DVDD), U1.22 (DVDD)
unnamed: C9.2, C10.1, U1.60 (AVDD)
unnamed: C11.1, R9.1, U2.5 (VOUT)
unnamed: C12.1, F1.2, U2.1 (VIN), U2.3 (ON/OFF)
unnamed: C13.1, U2.4 (BYPASS)
unnamed: D1.1 (A), D6.1 (A), D11.1 (A), D16.1 (A), D21.1 (A), D26.1 (A), D31.1 (A), D36.1 (A), R1.2
unnamed: D5.1 (A), D10.1 (A), D15.1 (A), D20.1 (A), D25.1 (A), D30.1 (A), D35.1 (A), D40.1 (A), R5.2
unnamed: D2.1 (A), D7.1 (A), D12.1 (A), D17.1 (A), D22.1 (A), D27.1 (A), D32.1 (A), D37.1 (A), R2.2
unnamed: D3.1 (A), D8.1 (A), D13.1 (A), D18.1 (A), D23.1 (A), D28.1 (A), D33.1 (A), D38.1 (A), R3.2
unnamed: D4.1 (A), D9.1 (A), D14.1 (A), D19.1 (A), D24.1 (A), D29.1 (A), D34.1 (A), D39.1 (A), R4.2
unnamed: F1.1, P1.1 (+5)
unnamed: P1.2 (D-), R10.1, TP2.1
unnamed: P1.3 (D+), R11.1, TP1.1
unnamed: Z1.1 (IN+), Z2.4 (O-)
unnamed: Z1.2 (IN-), Z2.2 (O+)
PB0: J3.1, R1.1, U1.36 (PB0:SSN:PCINT0)
PB4: J3.5, R5.1, U1.40 (PB4:OC2A:PCINT4)
PB5: J3.6, U1.41 (PB5:OC1A:PCINT5)
PB6: J3.7, U1.42 (PB6:OC1B:PCINT6)
PB7: J3.8, U1.43 (PB7:OC0A:OC1C:PCINT7)
PD0: D1.2 (K), D2.2 (K), D3.2 (K), D4.2 (K), D5.2 (K), J4.1, U1.25 (PD0:SCL:INT0)
PD1: D6.2 (K), D7.2 (K), D8.2 (K), D9.2 (K), D10.2 (K), J4.2, U1.26 (PD1:SDA:INT1)
PD4: D21.2 (K), D22.2 (K), D23.2 (K), D24.2 (K), D25.2 (K), J4.5, U1.29 (PD4:ICP1)
PD5: D26.2 (K), D27.2 (K), D28.2 (K), D29.2 (K), D30.2 (K), J4.6, U1.30 (PD5:XCK1)
PD6: D31.2 (K), D32.2 (K), D33.2 (K), D34.2 (K), D35.2 (K), J4.7, U1.31 (PD6:T1)
PD7: D36.2 (K), D37.2 (K), D38.2 (K), D39.2 (K), D40.2 (K), J4.8, U1.32 (PD7:T0)
PDI: J3.3, P2.4 (MOSI), R3.1, U1.38 (PB2:MOSI:PDI:PCINT2)
PDO: J3.4, P2.1 (MISO), R4.1, U1.39 (PB3:MIS0:PD0:PCINT3)
PE0: J5.1, U1.46 (PE0:RXD0:PCINT8)
PE1: J5.2, U1.47 (PE1:TXD0)
PE2: J5.3, U1.48 (PE2:XCK0:AIN0)
PE3: J5.4, U1.49 (PE3:OC3A:AIN1)
PE4: J5.5, U1.50 (PE4:OC3B:INT4)
PE5: J5.6, U1.51 (PE5:OC3C:INT5)
PE6: J5.7, U1.52 (PE6:T3:INT6)
PE7: J5.8, U1.53 (PE7:ICP3:INT7:CLKO)
PF0: J6.1, U1.63 (PF0:ADC0)
PF1: J6.2, U1.64 (PF1:ADC1)
PF2: J6.3, U1.1 (PF2:ADC2:DIG2)
PF3: J6.4, U1.2 (PF3:ADC3:DIG4)
PF4: J6.5, U1.3 (PF4:ADC4:TCK)
PF5: J6.6, U1.4 (PF5:ADC5:TMS)
PF6: J6.7, U1.5 (PF6:ADC6:TDO)
PF7: J6.8, U1.6 (PF7:ADC7:TDI)
PG0: J2.1, S2.2, U1.14 (PG0:DIG3)
PG1: J2.2, S3.2, U1.15 (PG1:DIG1)
PG2: J2.3, U1.16 (PG2:AMR)
PG5: J2.4, U1.19 (PG5:OC0B)
RST: D41.1 (A), P2.5 (RST), R6.2, S1.2, U1.12 (RSTIN)
RSTON: J2.5, U1.13 (RSTON)
RX-I: D11.2 (K), D12.2 (K), D13.2 (K), D14.2 (K), D15.2 (K), J4.3, J7.2, U1.27 (PD2:RXD1:INT2)
SCK: J3.2, P2.3 (SCK), R2.1, U1.37 (PB1:SCK:PCINT1)
TST: J2.7, R7.2, U1.11 (TST)
TX-O: D16.2 (K), D17.2 (K), D18.2 (K), D19.2 (K), D20.2 (K), J4.4, J7.3, U1.28 (PD3:TXD1:INT3)

Notes on the sheet:
+5V
RTC
SPI IN
SHIM PCB
BEFORE USE!
USB IN
CLK
