Workshop88/thotcon0x4/animation_final/animation_final.ino

#include <ZigduinoRadio.h>

int row_pin[] = {14, 15, 16, 17, 18, 19, 33, 35}; // port b 0, 4 , 5 , 6, 7 

int column_pin[] = {36, 37, 4, 5, 6};

/* Area bytes arrays -- These are the final positions of pieces on the board */
byte a1[] =       {  0b11111111, 
                     0b11111111, 
                     0b11111111, 
                     0b11111110, 
                     0b11111000  };

byte a2[] =      {   0b11111111, 
                     0b11111110, 
                     0b11111100, 
                     0b11111100, 
                     0b11111000  };
                     
byte a3[] =      {   0b11110000, 
                     0b11111110, 
                     0b11111100, 
                     0b11111100, 
                     0b11111000   };
                     
byte a4[] =      {   0b11110000, 
                     0b11111000, 
                     0b11111000, 
                     0b11111000, 
                     0b11111000   };
                     
byte a5[] =      {   0b11110000, 
                     0b11110000, 
                     0b11100000, 
                     0b11110000, 
                     0b11111000   };
                     
byte a6[]  =     {   0b11000000, 
                     0b11000000, 
                     0b11100000, 
                     0b11110000, 
                     0b11111000   };
                     
byte a7[]  =      {  0b11000000, 
                     0b11000000, 
                     0b11100000, 
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
                     0b11111000   };
 
byte t46[]  =    {   0b11000000, 
                     0b11000000, 
                     0b11100000, 
                     0b10010000, 
                     0b11001000   };
                 
byte *anim7[] = {t42,t43,t44,t45,t46,a7};

byte t47[]  =     {  0b11000000, 
                     0b11000000, 
                     0b01100000, 
                     0b11000000, 
                     0b11100000   };
                     
byte t48[]  =     {  0b11000000, 
                     0b01000000, 
                     0b00100000, 
                     0b11000000, 
                     0b11100000   };
                     
byte t49[]  =     {  0b11000000, 
                     0b11000000, 
                     0b01100000, 
                     0b00000000, 
                     0b11100000   };
                     
byte t50[]  =     {  0b11000000, 
                     0b11000000, 
                     0b11100000, 
                     0b01000000, 
                     0b00100000   };
                     
byte *anim8[] = {t47,t48,t49,t50,a8};

byte t51[] =      {  0b11000000, 
                     0b01000000, 
                     0b01100000, 
                     0b10000000, 
                     0b00000000   };
                     
byte t52[] =      {  0b11000000, 
                     0b10000000, 
                     0b00100000, 
                     0b10000000, 
                     0b00000000   };
                     
byte *anim9[] = {t51,t52,a9};

byte w88[] =      {  0b00000000,
                     0b11101010,
                     0b00010000,
                     0b11101010,
                     0b00000000   };
                     
                     
void show_screen(byte shape[], int iterations)
{
  while (--iterations)
  {
    for (int i=0; i<5; i++)
    {
      blank_led_array();
      show_column(shape[4-i], i);
    }
  }
}

void blank_led_array()
{
  for (int i=0; i<5; i++)
  {
     digitalWrite(column_pin[i], LOW);
  }
}

void show_column(byte whole_col, int n)
{
  for (byte i=0; i<8; i++)
  {
    digitalWrite(row_pin[i], bitRead(whole_col, 7-i));
   
  }
  
  digitalWrite(column_pin[n], HIGH);
}

void setup()
{
   DDRE |= (  (1<<PE0) | (1<<PE1) | (1<<PE2) | (1<<PE3) | (1<<PE4) );

   DDRF = 0xFF;
};

byte **anims[] = {anim1,anim2,anim3,anim4,anim5,anim6,anim7,anim8,anim9};
uint16_t anim_lens[9] = {9,10,10,8,5,5,6,5,3};

void displayAnim(int n)
{
      int i = 0;
      for (i = 0; i < anim_lens[n]; i++)
          show_screen(anims[n][i],100);
}

void loop()
{
uint16_t i = 0;

for( i =0; i < 9; i++)
   displayAnim(i);
 

};

/*
void loop()
{

  show_screen(w88, 1000);
  show_screen(t1, 100);
  show_screen(t2, 100);
  show_screen(t3, 100);
  show_screen(t4, 100);
  show_screen(t5, 100);
  show_screen(t6, 100);
  show_screen(t7, 100);
//  show_screen((t7>>1)&0xFF, 100);
  show_screen(t8, 100);
  show_screen(a1, 100);
  show_screen(a1, 100);
  show_screen(a1, 100);
  show_screen(a1, 100);
  show_screen(t9, 100);
  show_screen(t10, 100);
  show_screen(t11, 100);
  show_screen(t12, 100);
  show_screen(t13, 100);
  show_screen(t14, 100);
  show_screen(t15, 100);
  show_screen(t16, 100);
  show_screen(t17, 100);
  show_screen(a2, 100);
  show_screen(a2, 100);
  show_screen(a2, 100);
  show_screen(a2, 100);
  show_screen(t18, 100);
  show_screen(t19, 100);
  show_screen(t20, 100);
  show_screen(t21, 100);
  show_screen(t22, 100);
  show_screen(t23, 100);
  show_screen(t24, 100);
  show_screen(t25, 100);
  show_screen(t26, 100);
  show_screen(a3, 100);
  show_screen(a3, 100);
  show_screen(a3, 100);
  show_screen(a3, 100);
  show_screen(t27, 100);
  show_screen(t28, 100);
  show_screen(t29, 100);
  show_screen(t30, 100);
  show_screen(t31, 100);
  show_screen(t32, 100);
  show_screen(t33, 100);
  show_screen(a4, 100);
  show_screen(a4, 100);
  show_screen(a4, 100);
  show_screen(a4, 100);
  show_screen(t34, 100);
  show_screen(t35, 100);
  show_screen(t36, 100);
  show_screen(t37, 100);
  show_screen(a5, 100);
  show_screen(a5, 100);
  show_screen(a5, 100);
  show_screen(a5, 100);
  show_screen(t38, 100);
  show_screen(t39, 100);  
  show_screen(t40, 100);
  show_screen(t41, 100);
  show_screen(a6, 100);
  show_screen(a6, 100);
  show_screen(a6, 100);
  show_screen(a6, 100);
  show_screen(t42, 100);
  show_screen(t43, 100);  
  show_screen(t44, 100);
  show_screen(t45, 100);
  show_screen(t46, 100);
  show_screen(a7, 100);
  show_screen(a7, 100);
  show_screen(a7, 100);
  show_screen(a7, 100);
  show_screen(t47, 100);
  show_screen(t48, 100);
  show_screen(t49, 100);  
  show_screen(t50, 100);
  show_screen(a8, 100);
  show_screen(a8, 100);
  show_screen(a8, 100);
  show_screen(a8, 100);
  show_screen(t51, 100);
  show_screen(t52, 100);
  show_screen(a9, 100);
  show_screen(a9, 100);
  show_screen(a9, 100);
  show_screen(a9, 100);
  show_screen(aa, 100);
 show_screen(aa, 100); 
 show_screen(aa, 100);
  show_screen(aa, 100);
   show_screen(aa, 100);
};*/
