Workshop88/thotcon0x4/(commit log)

2014-10-28 These files got lost from the repo for some reason. Adding them back.
    Former-commit-id: 1d4085c8e31a07bcd1b591d52980725daf15e6ec
    [Fuse-bit-advice.ods, balun_2450.sch, test.brd, thotcon_badge-BOM-BY-REF.ods, thotcon_badge.brd, thotcon_badge.sch, thotcon_badge_fixture.brd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]
2014-10-28 Removed kicad.
    Former-commit-id: 95d93a1bc9f49bb269f8b805f8d7975e5aff03b9
