Workshop88/thotcon0x4/(notices)

Notices in the files:
parts and their libraries:
(c) 2013 WS88
